bialykostek/kontroler/README.md

# Neural controller for Unmanned Aerial Vehicle control
Official repositiry 

List of most important files:

- [jan_kostecki_praca_inzynierska.pdf](/praca/jan_kostecki_praca_inzynierska.pdf) - Engineering Thesis
- [flight_model_18.h](/Kontroler/babyDodoTFPPM/flight_model_18.h) - best AI model (2 minutes in the air!)
- [flight.py](/AI/sintest.py) - Tensorflow model training
- [nettocpp.m](/AI/nettocpp.m) - matlab neural network to C++ converter
- [groundStation.ino](/Ground%20Station/groundStation/groundStation.ino) - ground station software
- [websockeetCOM.py](/Ground%20Station/websocketCOM.py) - relay app
- [babyDodo.ino](/Kontroler/babyDodo/babyDodo.ino) - controller software
- [plytka.kicad_pcb](/plytka/plytka/plytka.kicad_pcb) - PCB design
- [dodo.xfl](/samolot/dodo.xfl) - XFLR5 plane design
- [websocket.js](/serwer/websocket.js) - server software
- [main.html](/webapp/main.html) - web app main page
- [documentation.txt](/documentation.md) - communication protocol documentation
