bialykostek/kontroler/praca/neuralcontroler.pptx

## Neural controller for Unmanned Aerial Vehicle control

Jan Kostecki

## Objective

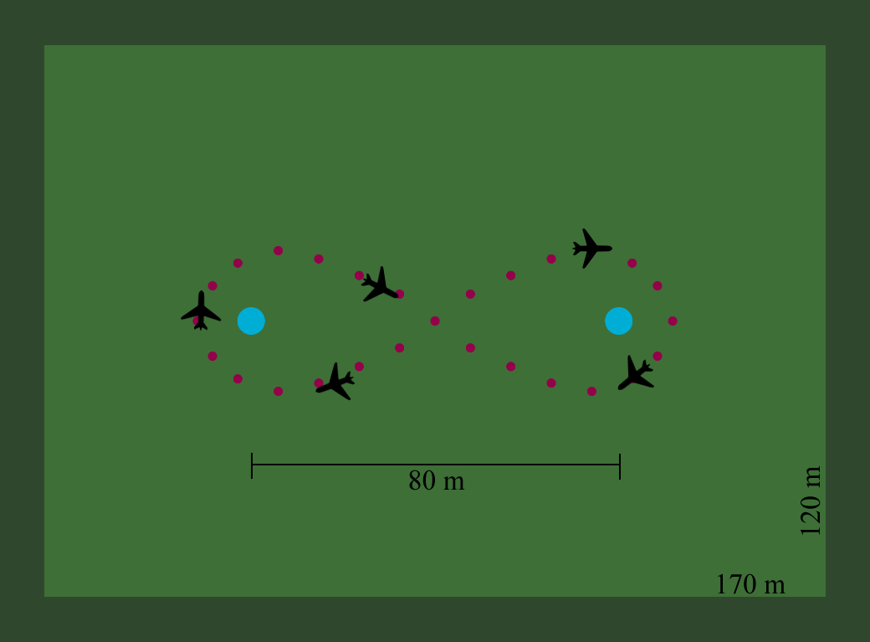
[picture p1: figure]

## Slide 3

Model plane „Dodo”

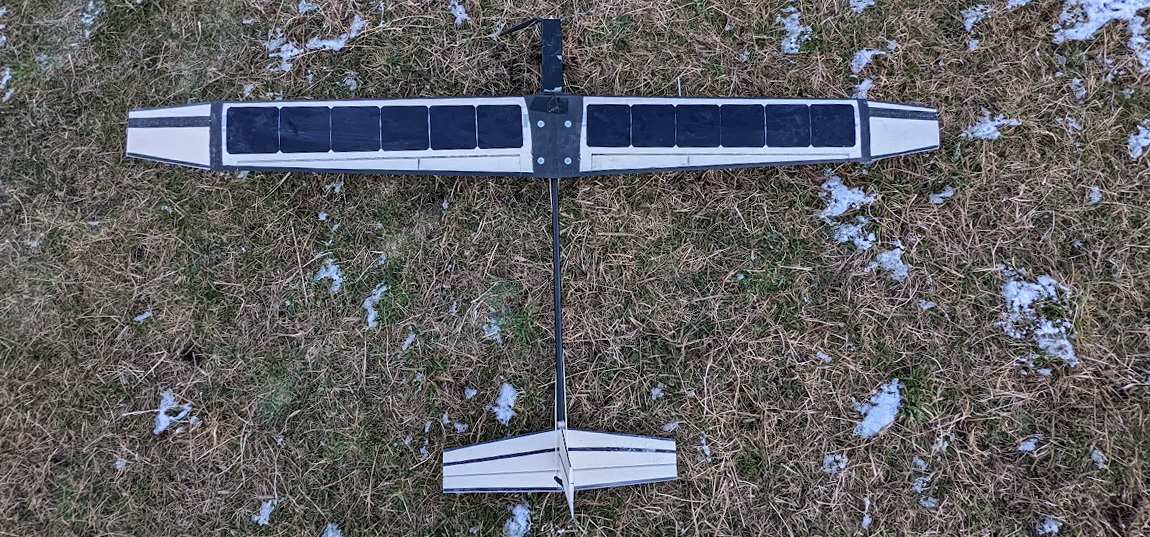
[picture p2: figure]
A picture containing text, tree, outdoor, sign

## Slide 4

Electronic controller module

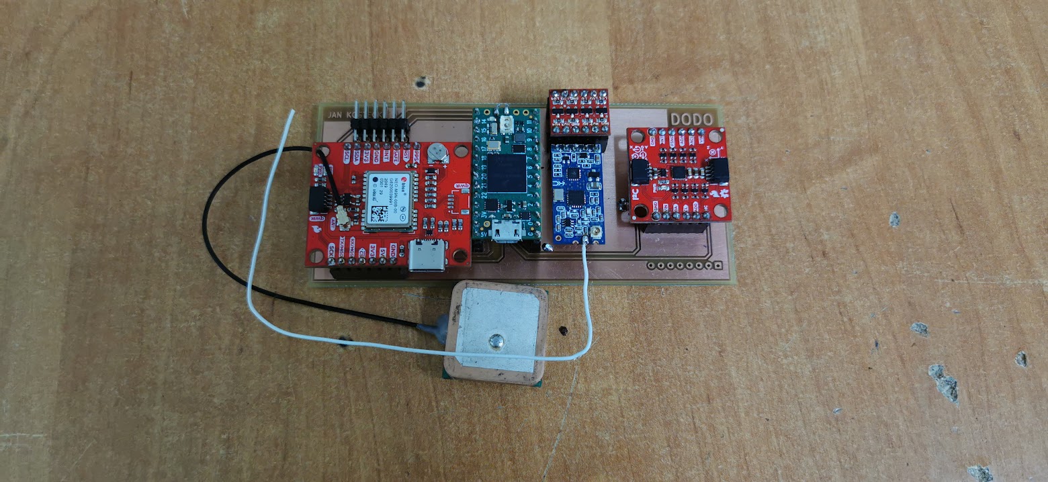
[picture p3: figure]

## Slide 5

Web visualization app

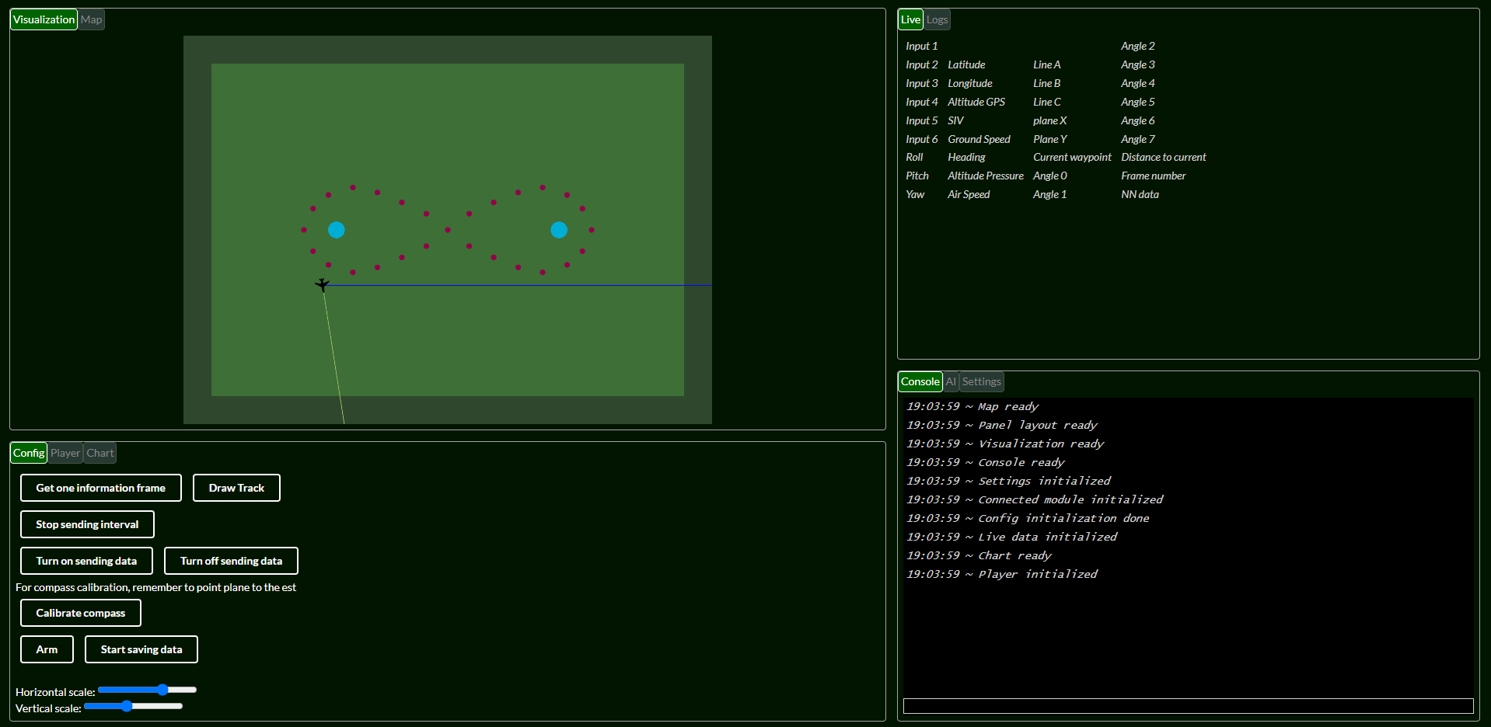
[picture p4: figure]

## Milestones

1. Prepare plane for flight (small repairs)
2. Test flight
3. Collect training data during flights
4. Fix importing TensorFlow Lite model to Teensy 4.0 microcontroller
5. Train few different networks (RNN, LSTM)
6. Test autonomous flight
7. Compare performance results

## Bibliography

Mozammal Chowdhury and Shawn Keshmiri. Design and flight test validation of an ai-based longitudinal flight controller for fixed-wing uass. IEEE Computer Society, 2022
Mihai Lungu. Backstepping and dynamic inversion combined controller for auto-landing of fixed wing uavs. Aerospace Science and Technology, 2020
Ruijie Sun, Zhou Zhou, and Xiaoping Zhu. Stability control of a fixed full-wing layout uav under manipulation constraints. Aerospace Science and Technology, 2022

## Thank you :)
