bialykostek/kontroler/praca/template/template/template.tex

%
\RequirePackage{fix-cm}
\documentclass[12pt]{report}
\usepackage{graphicx}
\usepackage{setspace}
\usepackage{authblk}
\usepackage{booktabs}
\usepackage{color,soul}
\usepackage{subfigure}
\usepackage{indentfirst}
\setlength\parindent{1cm}
\usepackage{times}
\usepackage{cite}
\usepackage[nottoc,notlot,notlof]{tocbibind}
% For tablesgenerator:
\usepackage{multirow}
\usepackage[table,xcdraw]{xcolor}
\usepackage[normalem]{ulem}
\usepackage{adjustbox}
\usepackage{float}
\usepackage[toc,page]{appendix}
\usepackage{listings}
\usepackage[utf8]{inputenc}
\usepackage{geometry}
\usepackage[final]{pdfpages}
\usepackage{hyperref}

\geometry{ a4paper, left=35mm,  right=25mm,  top=25mm, bottom=25mm  }
\linespread{1.2}

\hbadness=12000

\begin{document}

\tableofcontents
\chapter{Example chapter}
\section{Example section}
Example text.Example text.Example text.Example text.Example text.Example text.Example text.Example text.Example text.Example text.Example text.Example text.Example text.Example text.Example text.Example text.Example text.
\par
Example 2nd paragraph. Example 2nd paragraph.Example 2nd paragraph.Example 2nd paragraph.Example 2nd paragraph.Example 2nd paragraph.Example 2nd paragraph.Example 2nd paragraph.Example 2nd paragraph.Example 2nd paragraph.Example 2nd paragraph.Example 2nd paragraph. \par
\subsection{Example subsection}
Example text.Example text.Example text.Example text.Example text.Example text.Example text.Example text.Example text.Example text.Example text.Example text.Example text.Example text.Example text.Example text.Example text.

\chapter{Useful things}
\label{sec:useful_things}
\section{Lists and such}

Example itemize.
\begin{itemize}
\item item
\item item
\item item
\end{itemize}

Example enumerate
\begin{enumerate}
\item item
\item item
\item item
\end{enumerate}

\section{Including external content}
\label{sec:content}
\begin{figure}[H] 
  \centering
    
      \caption{Figure caption}
      \label{fig:example}
\end{figure}

\includepdf[pages=1]{pdfs/example}

\section{Tables and equations}
http://www.tablesgenerator.com/ is convenient for table generation until you get
used to the syntax.
\begin{table}[H]
\label{tab:example}
\begin{tabular}{|l|l|l|l|l|}
\hline
1 & 1 & 1 & 1 & 1 \\ \hline
1 & 1 & 1 & 1 & 1 \\ \hline
1 & 1 & 1 & 1 & 1 \\ \hline
1 & 1 & 1 & 1 & 1 \\ \hline
\end{tabular}
\end{table}

https://www.codecogs.com/latex/eqneditor.php is convenient for equation generation
until you get used to the syntax.

\begin{equation}
\label{eq:example}
 u(t)=K_{p}e(t) + K_{i} \int_{0}^{t}e(t')dt'+K_{d}\frac{de(t)}{dt}
\end{equation}

\section{Adding references}
Added content was labeled following type:label convention, using:
\begin{itemize}
\item tab for tables
\item fig for figures
\item eq for equations
\item sec for text sections
\end{itemize}
Not a rigid thing, can be changed to any other names but some labeling convention should be used, as it makes referring specific things easier.
Example references:
\begin{itemize}
\item table: \autoref{tab:example}
\item figure: \autoref{fig:example}
\item equation: \autoref{eq:example}
\item chapter: \autoref{sec:useful_things}
\item section: \autoref{sec:content}
\item position from bibliography(within the included .bib file): \cite{ref_key}
\end{itemize}

\bibliography{template_ref}
\bibliographystyle{ieeetr}	

\end{document}
