bialykostek/kontroler/praca/latex/tytulowa.pdf

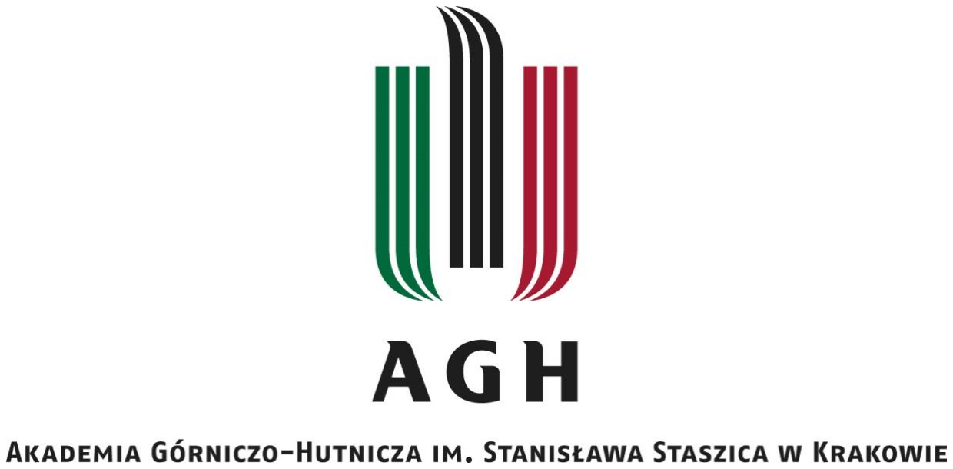
[picture p74: figure]

WYDZIAŁ INŻYNIERII MECHANICZNEJ I ROBOTYKI

KATEDRA ROBOTYKI I MECHATRONIKI

## Praca dyplomowa

## Neuronowy kontroler do sterowania bezzałogowym statkiem powietrznym

## Neural controller for an Unmanned Aerial Vehicle control

Autor: | Jan Kostecki
Kierunek studiów: | Inżynieria Mechatroniczna
Opiekun pracy: | dr hab. inż. Ziemowit Dworakowski, prof. AGH

Kraków, 2022
