bialykostek/kontroler/polocie_dark.png

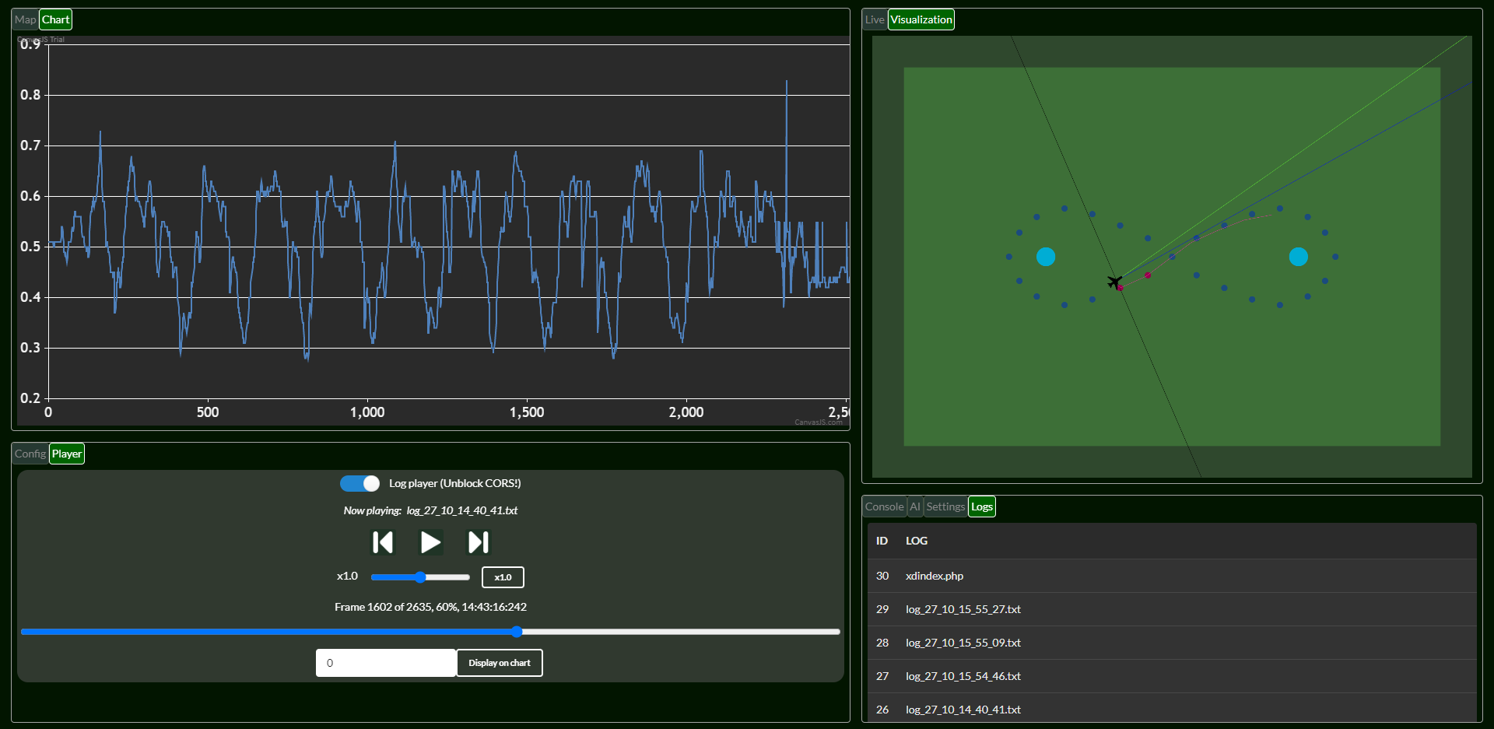
polocie_dark.png
