bialykostek/kontroler/praca/latex/images/budowa2.png

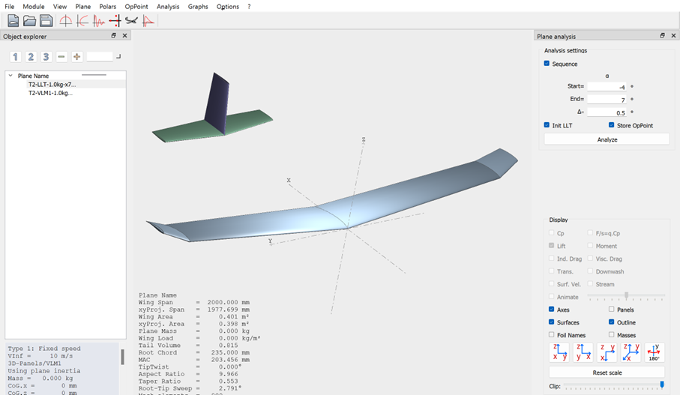
praca/latex/images/budowa2.png
