bialykostek/kontroler/praca/latex/images/budowa6.jpg

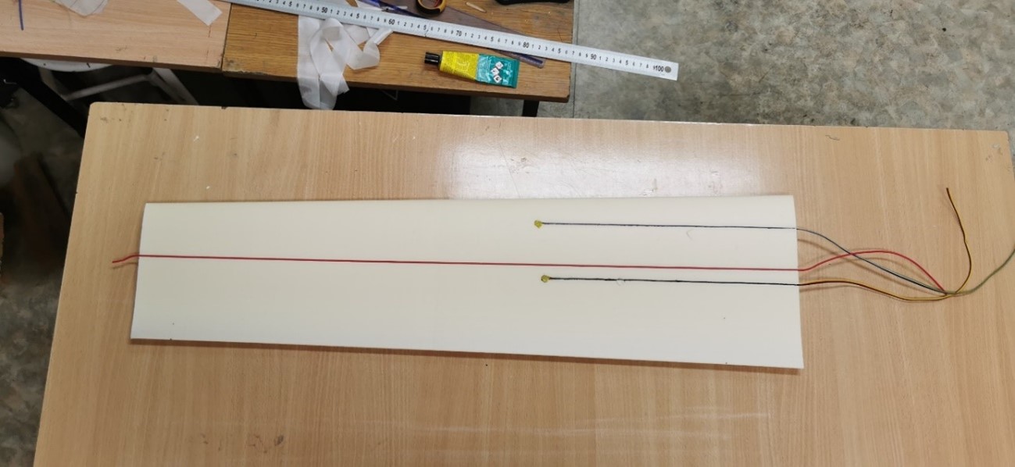
praca/latex/images/budowa6.jpg
