bialykostek/kontroler/praca/latex/images/budowa8.jpg

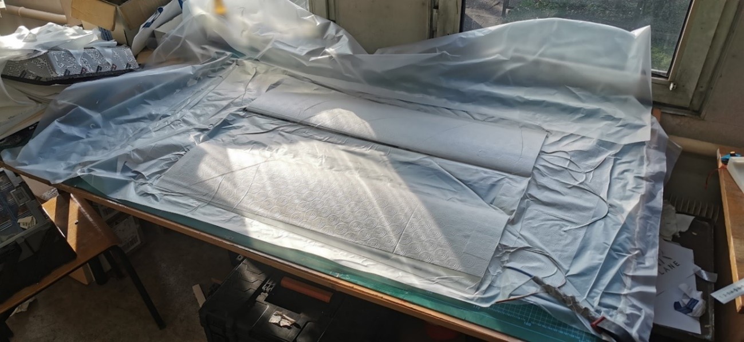
praca/latex/images/budowa8.jpg
