bialykostek/kontroler/praca/latex/images/budowa10.jpg

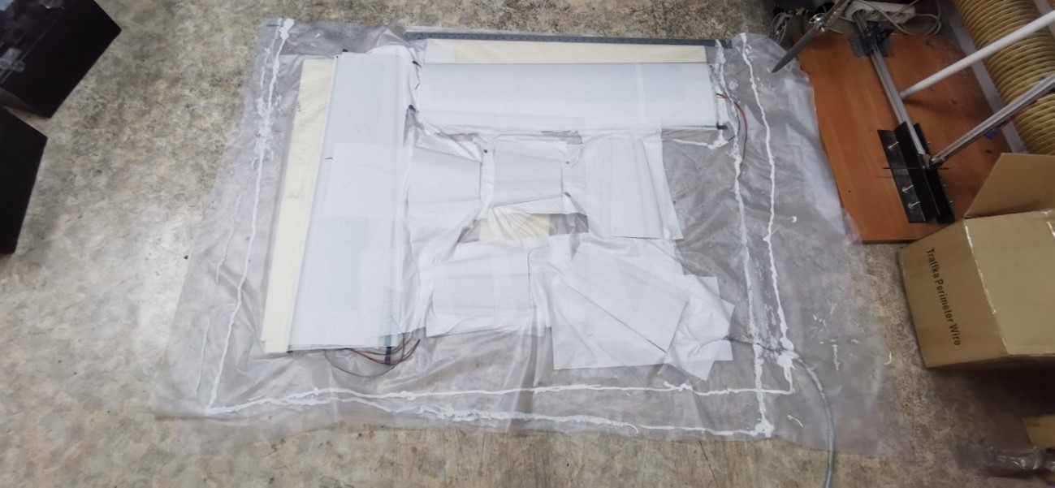
praca/latex/images/budowa10.jpg
