bialykostek/kontroler/praca/latex/images/budowa12.jpg

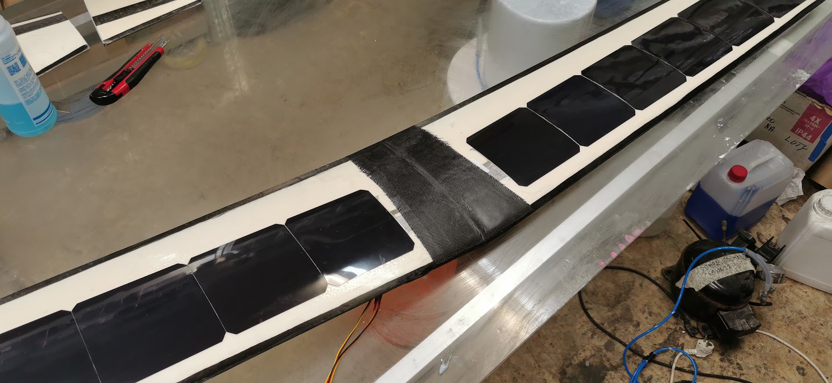
praca/latex/images/budowa12.jpg
