bialykostek/kontroler/praca/latex/images/budowa15.png

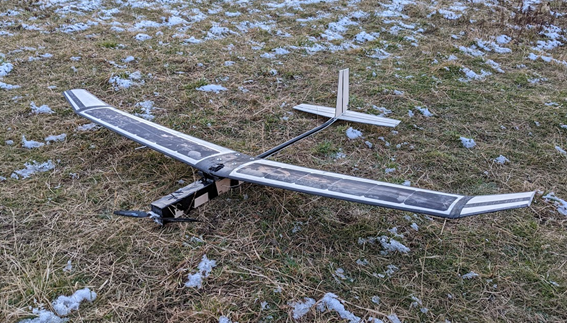
praca/latex/images/budowa15.png
