bialykostek/kontroler/praca/latex/images/charakterystyki.png

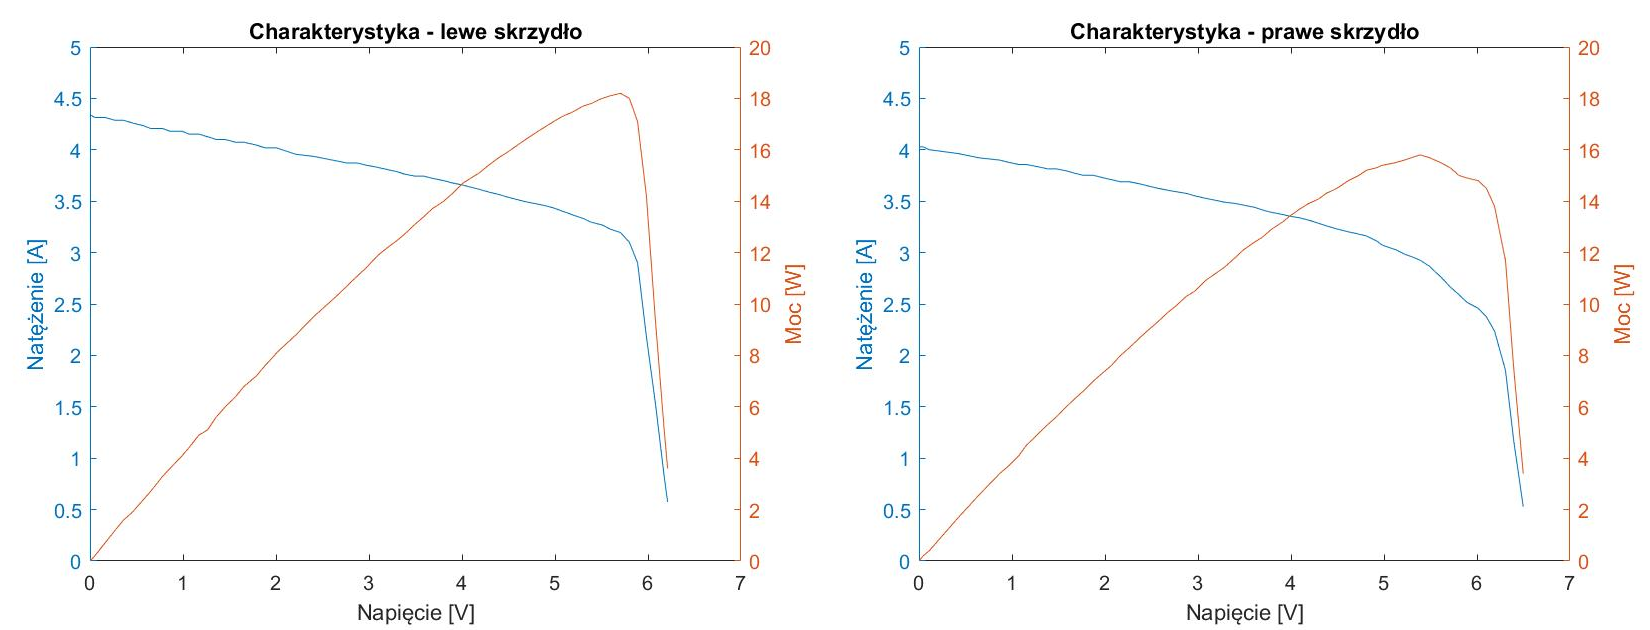
praca/latex/images/charakterystyki.png
