bialykostek/kontroler/praca/latex/images/cuav.jpg

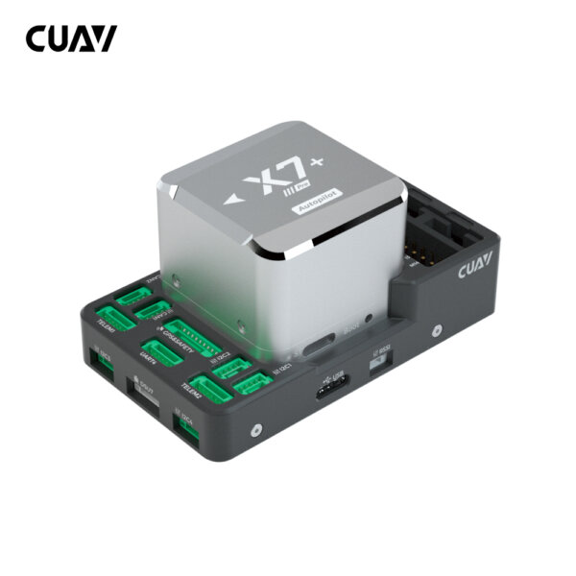
praca/latex/images/cuav.jpg
