bialykostek/kontroler/praca/latex/images/diagram_blokowy.png

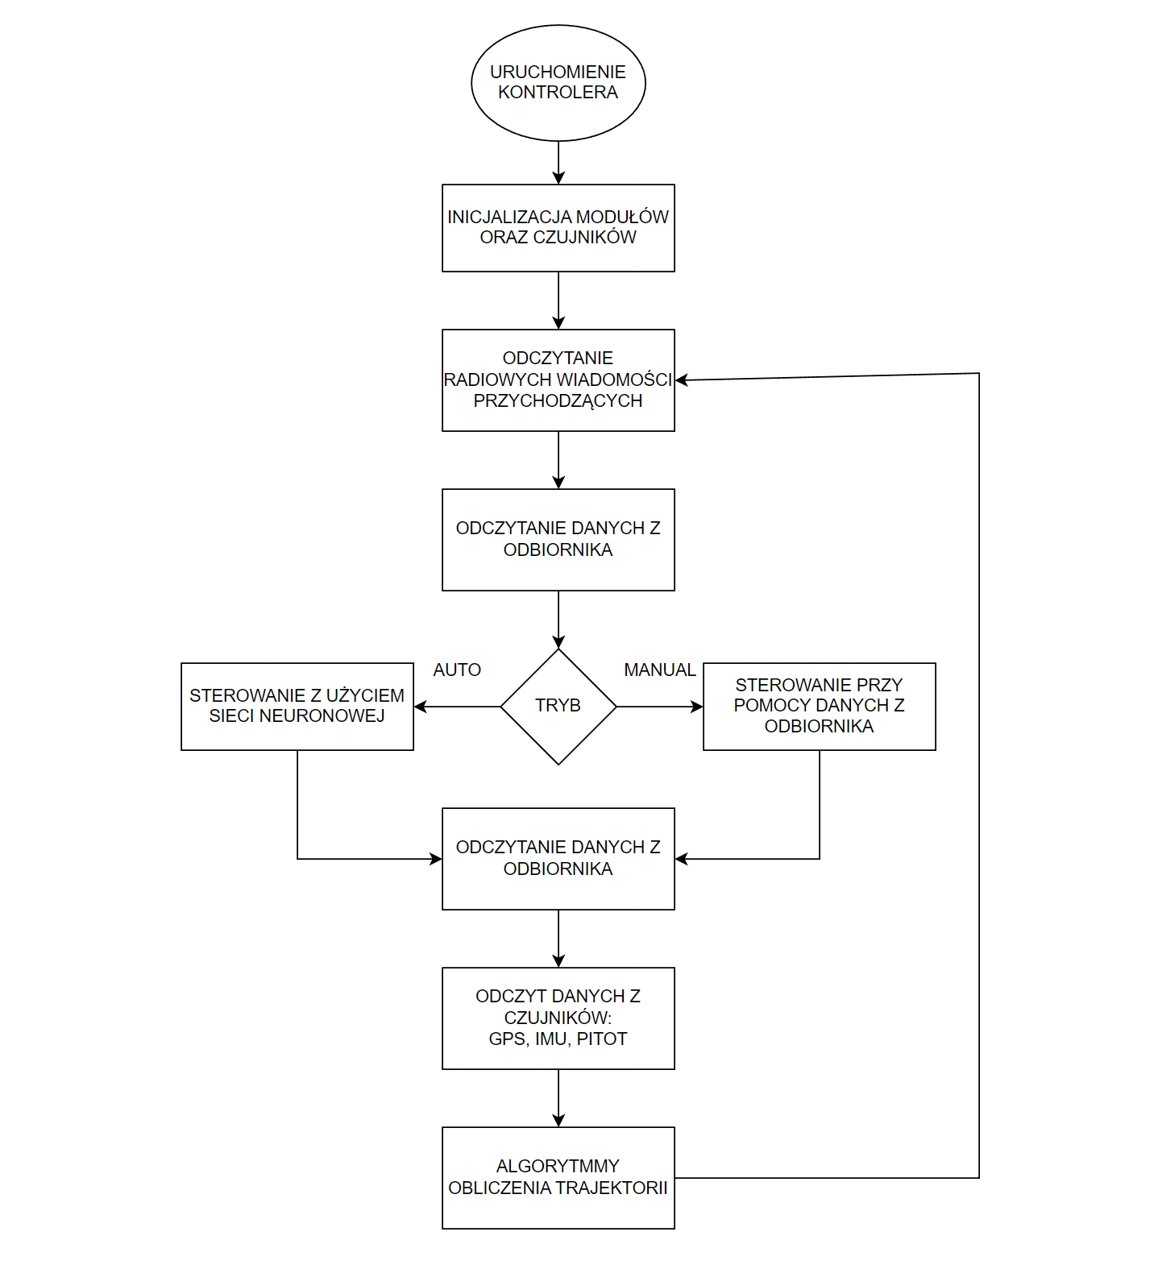
praca/latex/images/diagram_blokowy.png
