bialykostek/kontroler/praca/latex/images/diagram_emergency.png

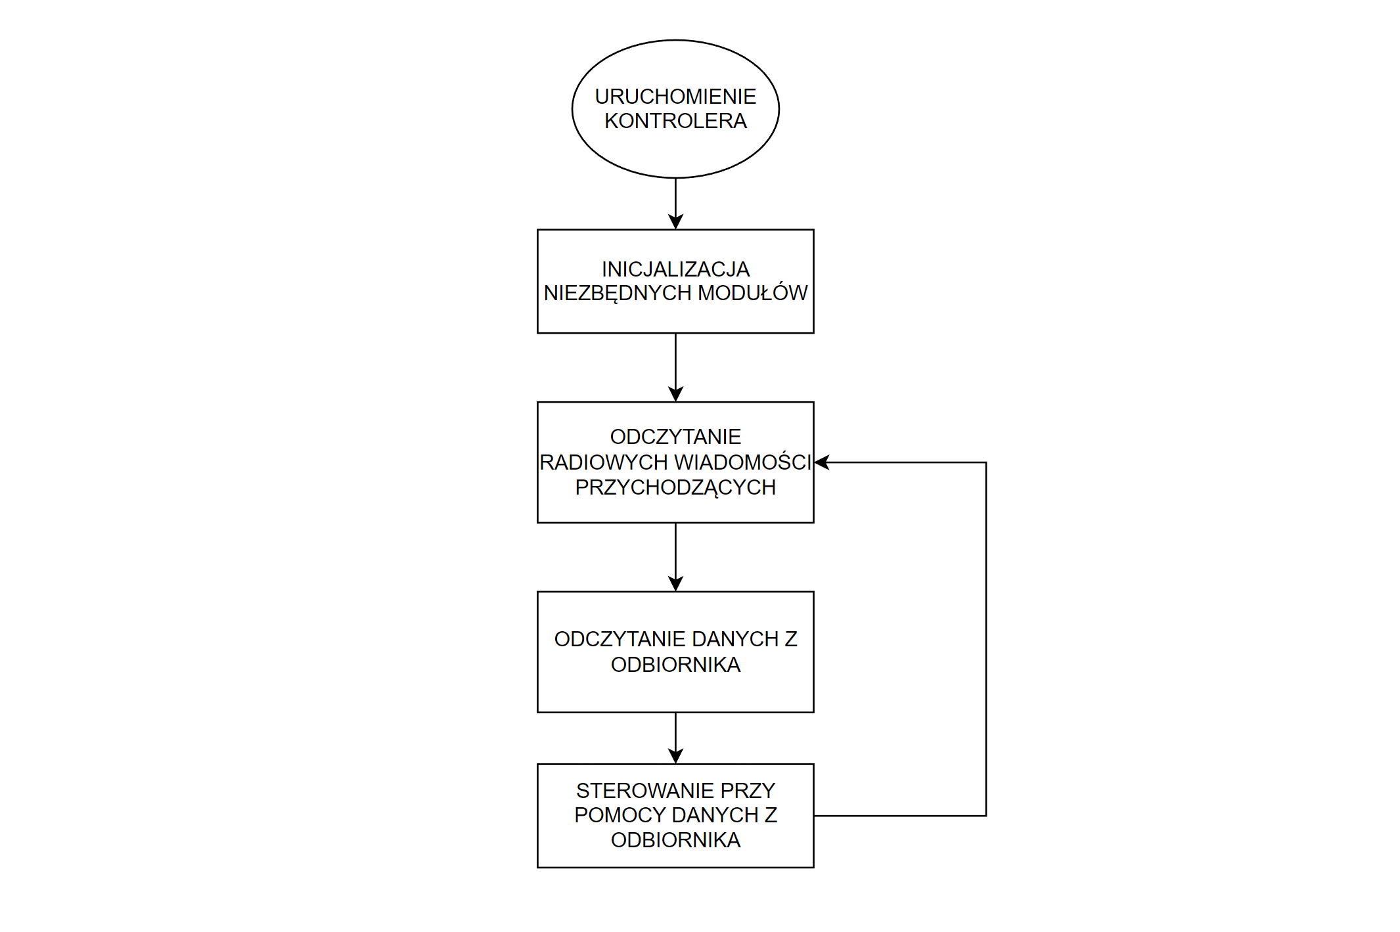
praca/latex/images/diagram_emergency.png
