bialykostek/kontroler/praca/latex/images/dodopcb.png

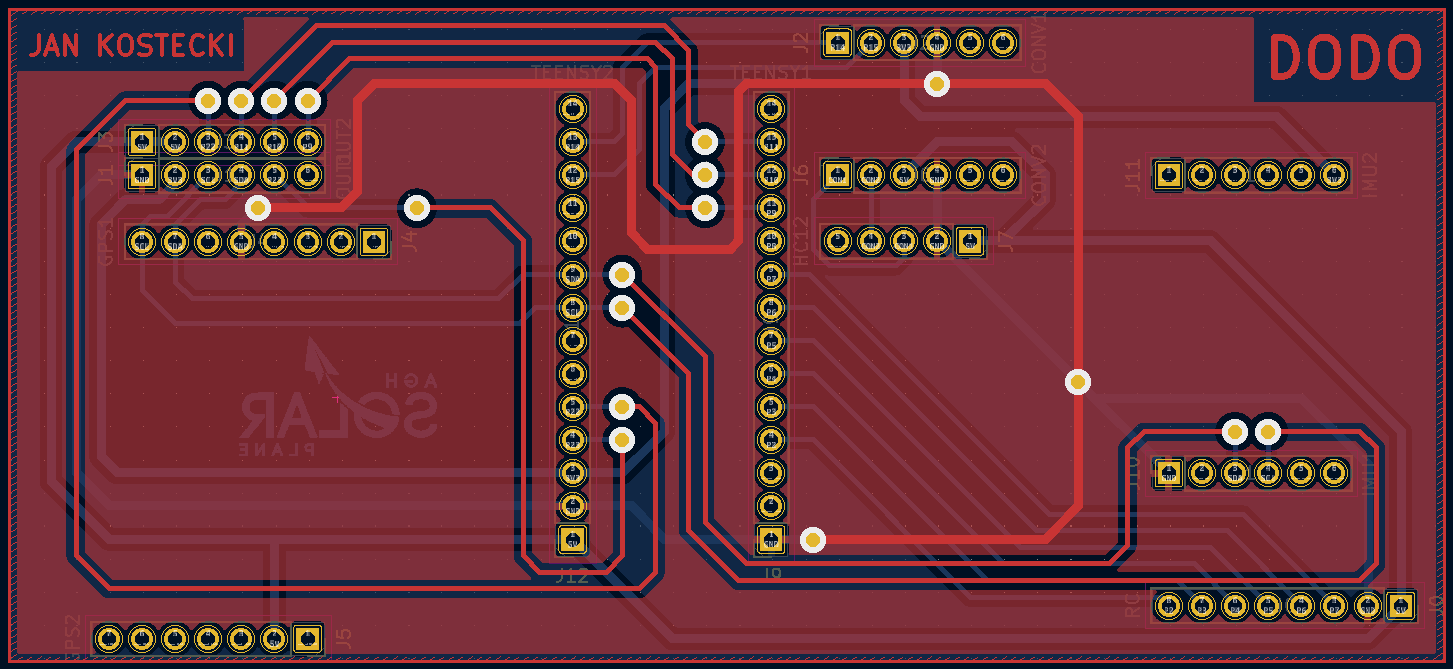
praca/latex/images/dodopcb.png
