bialykostek/kontroler/praca/latex/images/kamerat.png

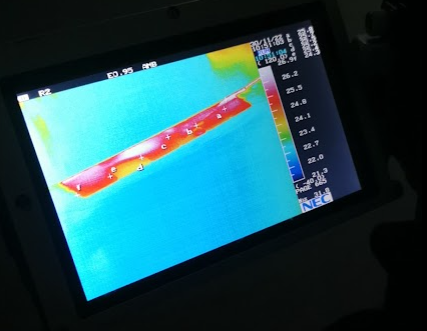
praca/latex/images/kamerat.png
