bialykostek/kontroler/praca/latex/images/kontroler1.png

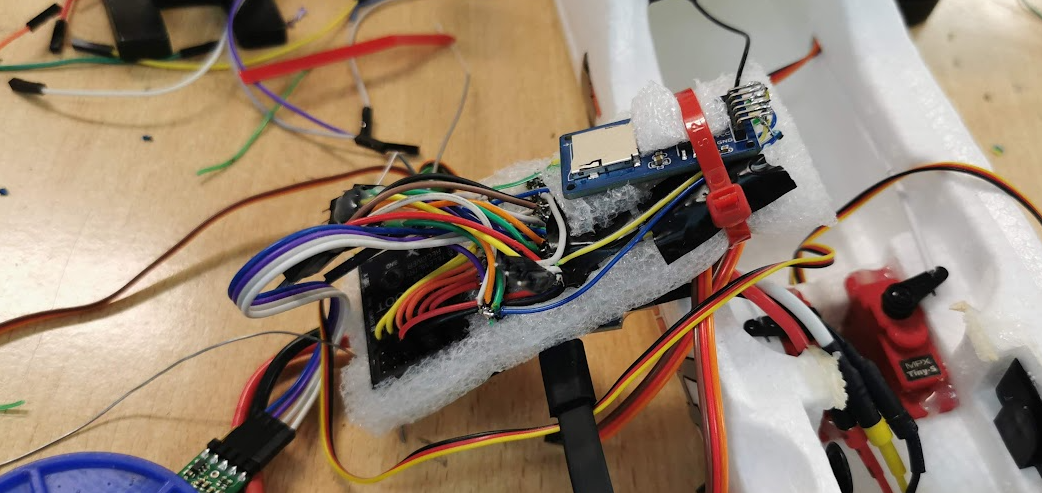
praca/latex/images/kontroler1.png
