bialykostek/kontroler/praca/latex/images/legitymacjap.jpg

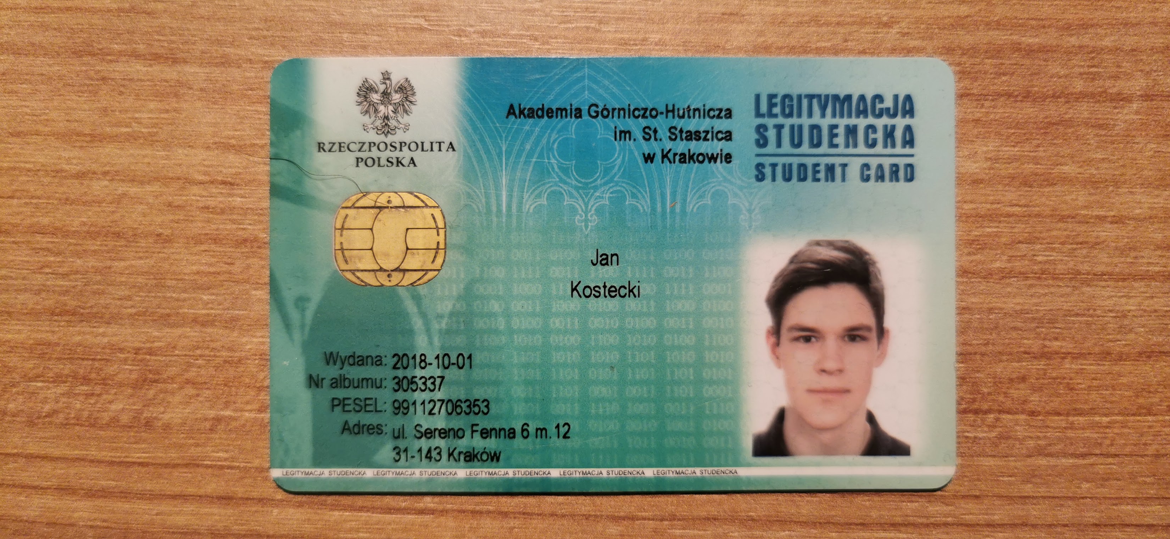
praca/latex/images/legitymacjap.jpg
