bialykostek/kontroler/praca/latex/images/legitymacjat.jpg

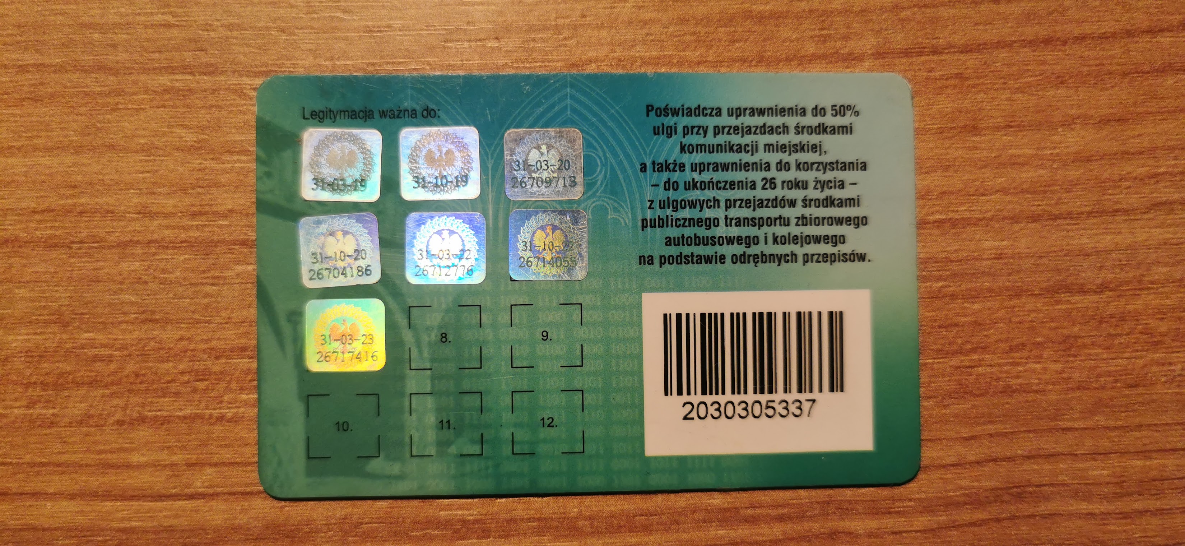
praca/latex/images/legitymacjat.jpg
