bialykostek/kontroler/praca/latex/images/leweprzetarte.jpg

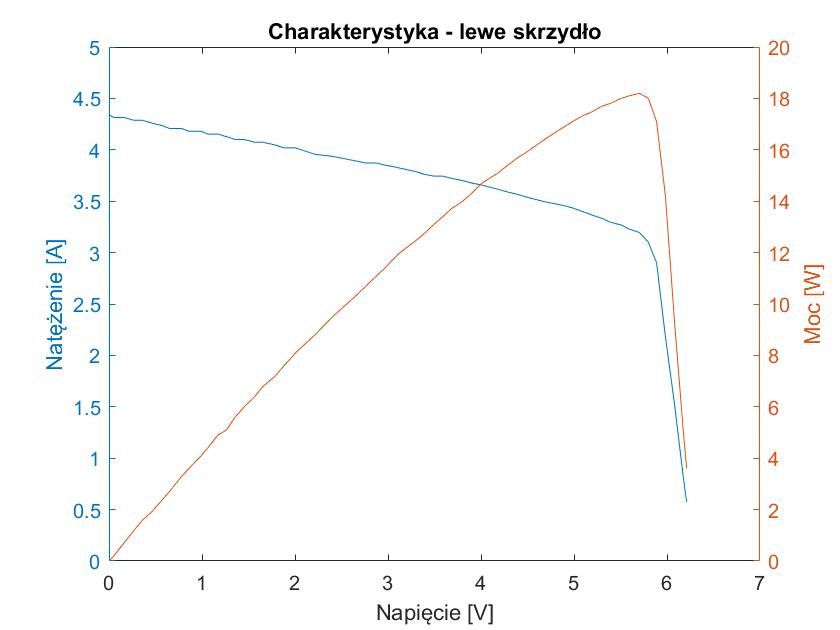
praca/latex/images/leweprzetarte.jpg
