bialykostek/kontroler/praca/latex/images/mateksys.png

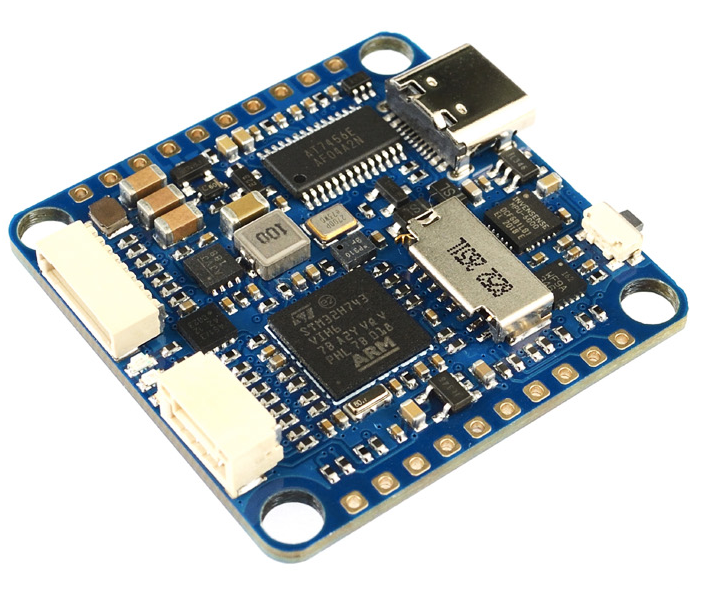
praca/latex/images/mateksys.png
