bialykostek/kontroler/praca/latex/images/pixhawk.jpg

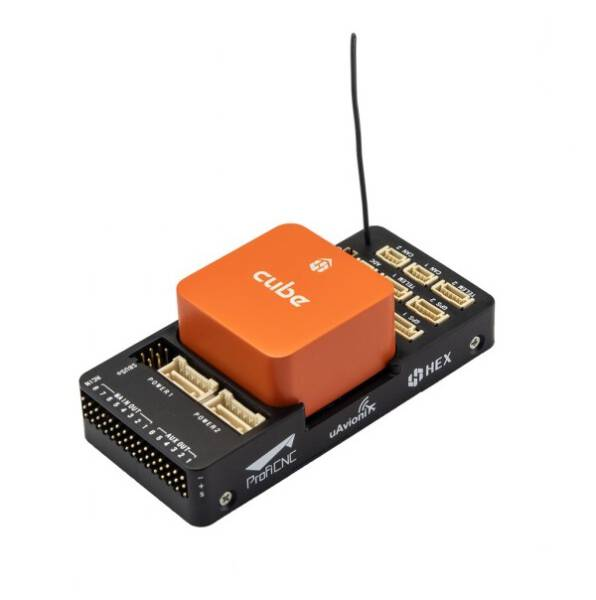
praca/latex/images/pixhawk.jpg
