bialykostek/kontroler/praca/latex/images/porownanie2.jpg

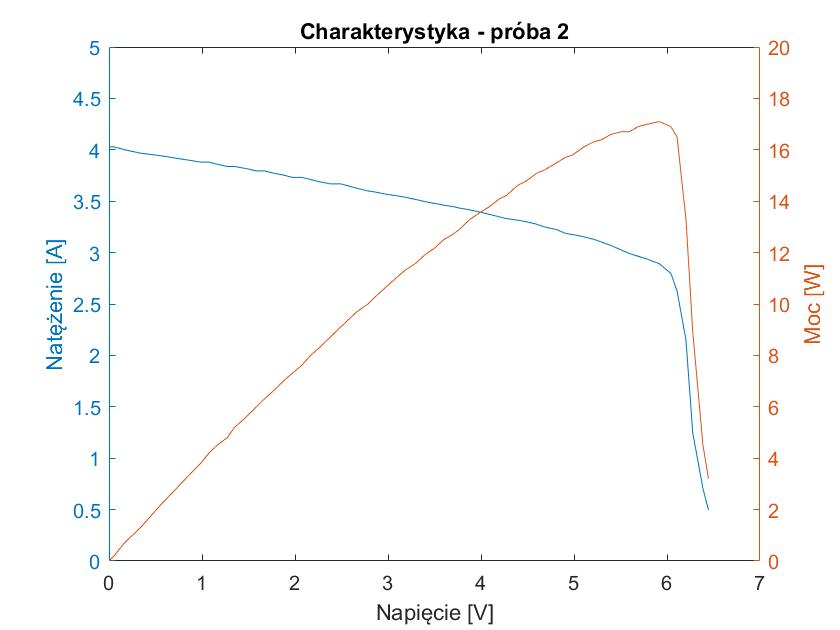
praca/latex/images/porownanie2.jpg
