bialykostek/kontroler/praca/latex/images/stacjaodbiorcza.jpg

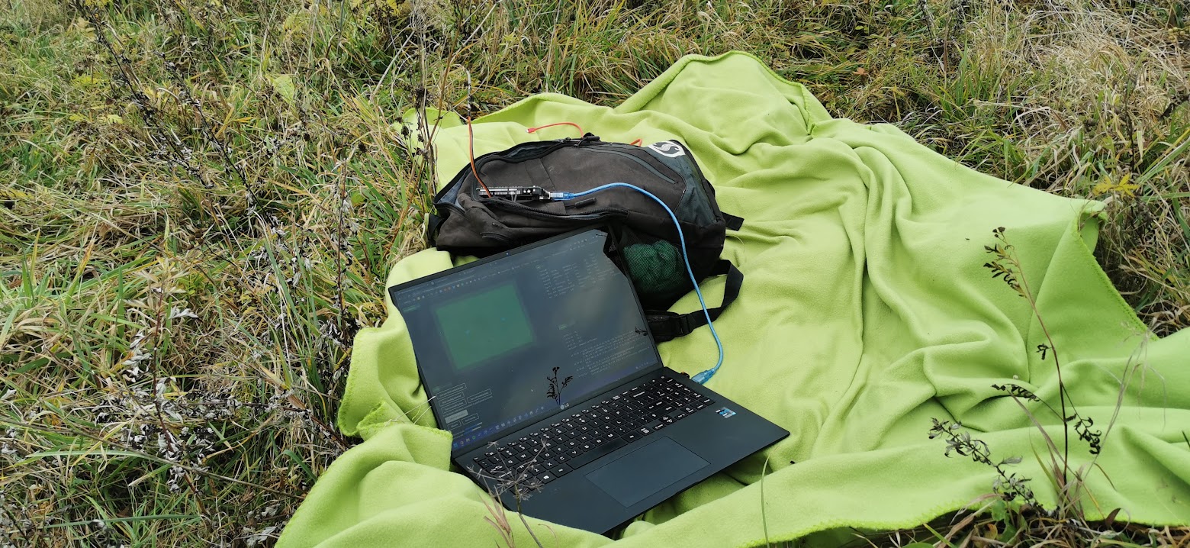
praca/latex/images/stacjaodbiorcza.jpg
