bialykostek/kontroler/praca/latex/images/termolewe.jpg

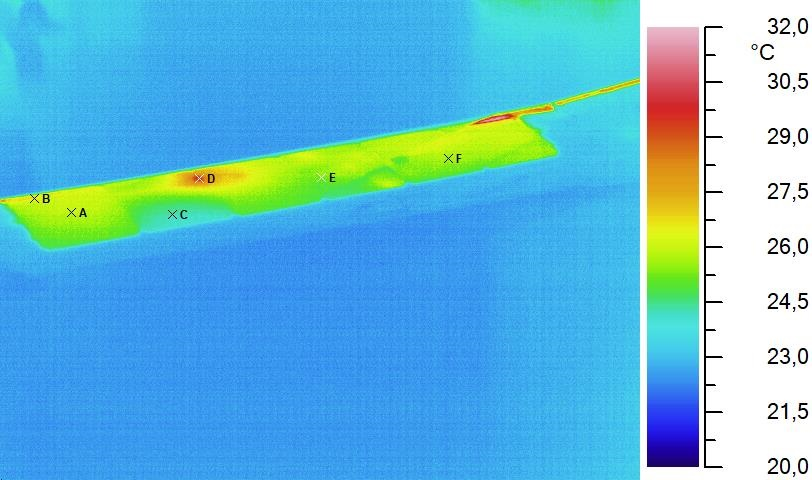
praca/latex/images/termolewe.jpg
