bialykostek/kontroler/praca/latex/images/termoprawe.jpg

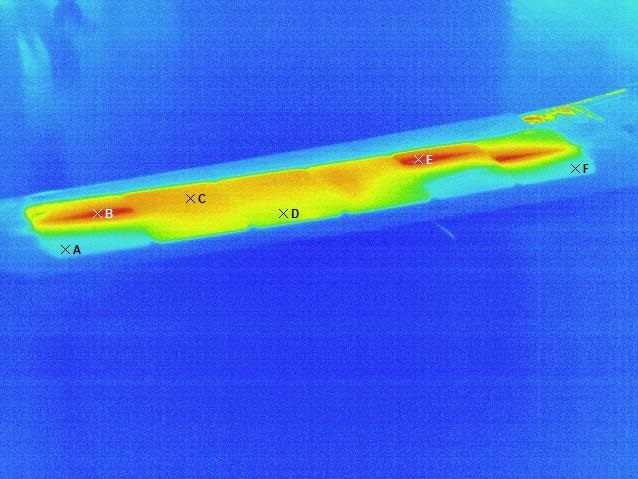
praca/latex/images/termoprawe.jpg
