bialykostek/kontroler/praca/latex/images/terzwlewe.jpg

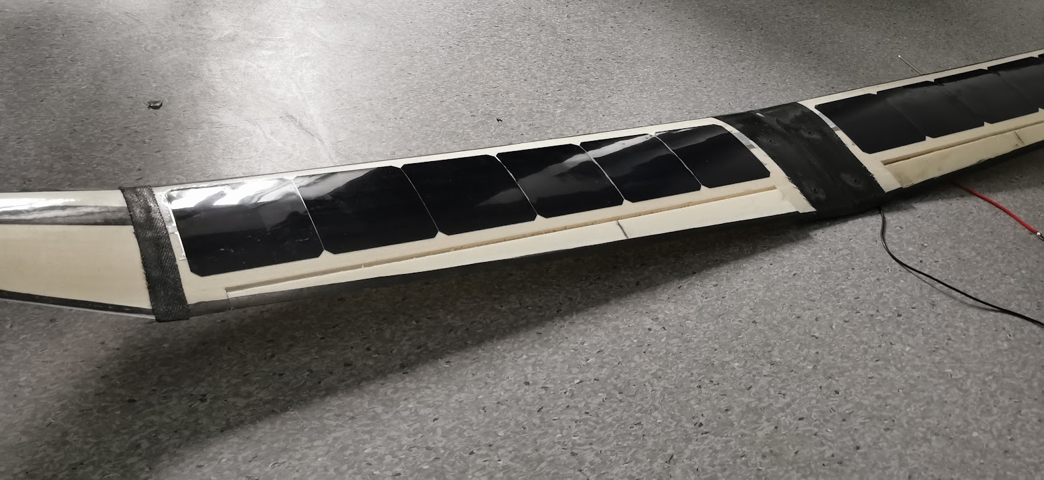
praca/latex/images/terzwlewe.jpg
