bialykostek/kontroler/praca/latex/images/terzwprawe.jpg

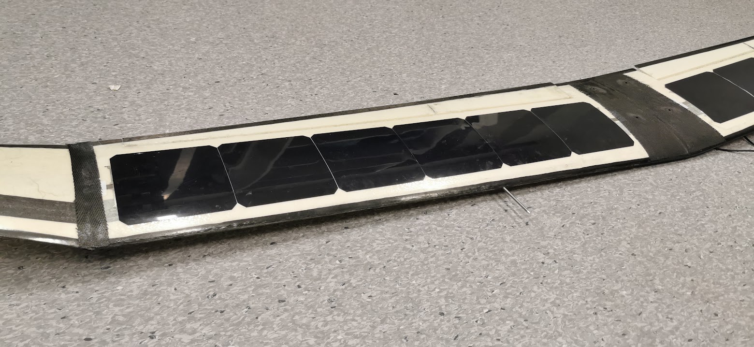
praca/latex/images/terzwprawe.jpg
