bialykostek/kontroler/praca/na pracy.png

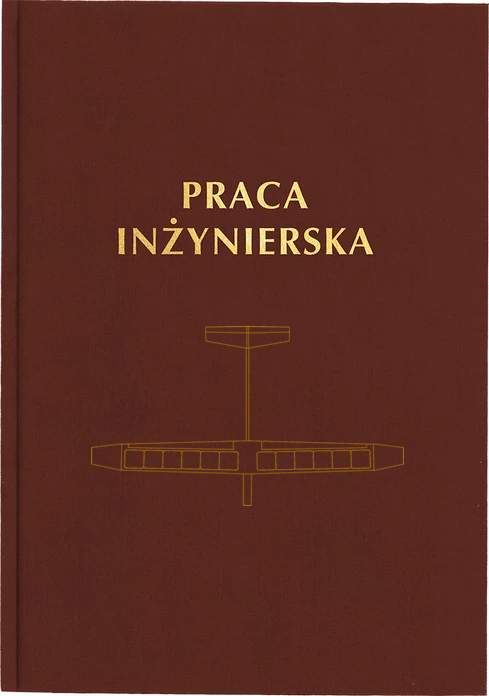
praca/na pracy.png
