bialykostek/kontroler/praca/pcb1.png

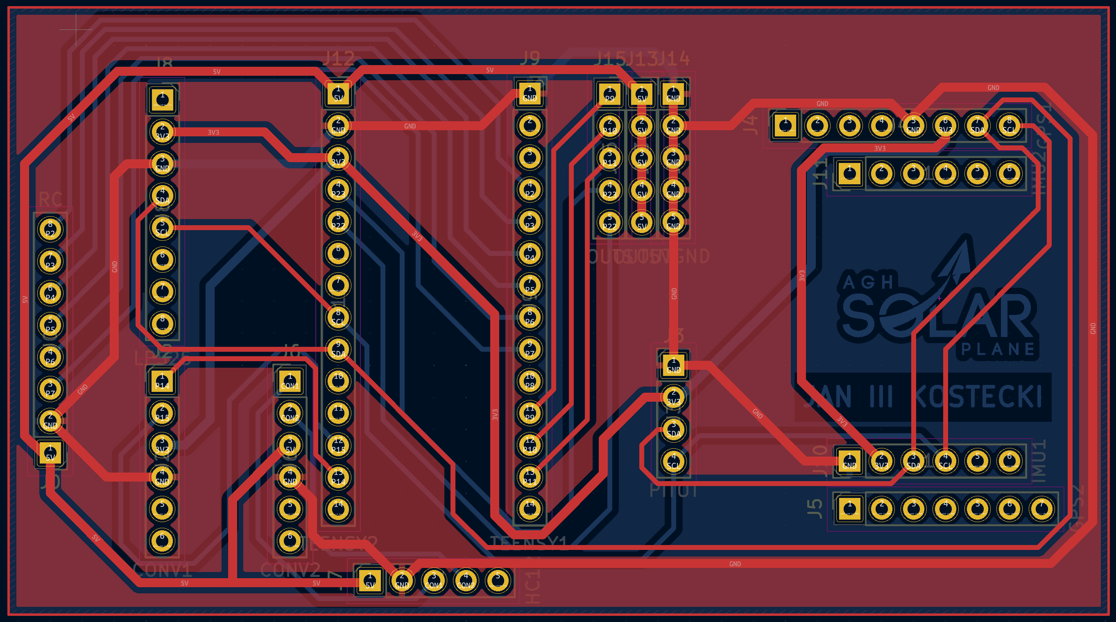
praca/pcb1.png
