bialykostek/kontroler/praca/pcb2.png

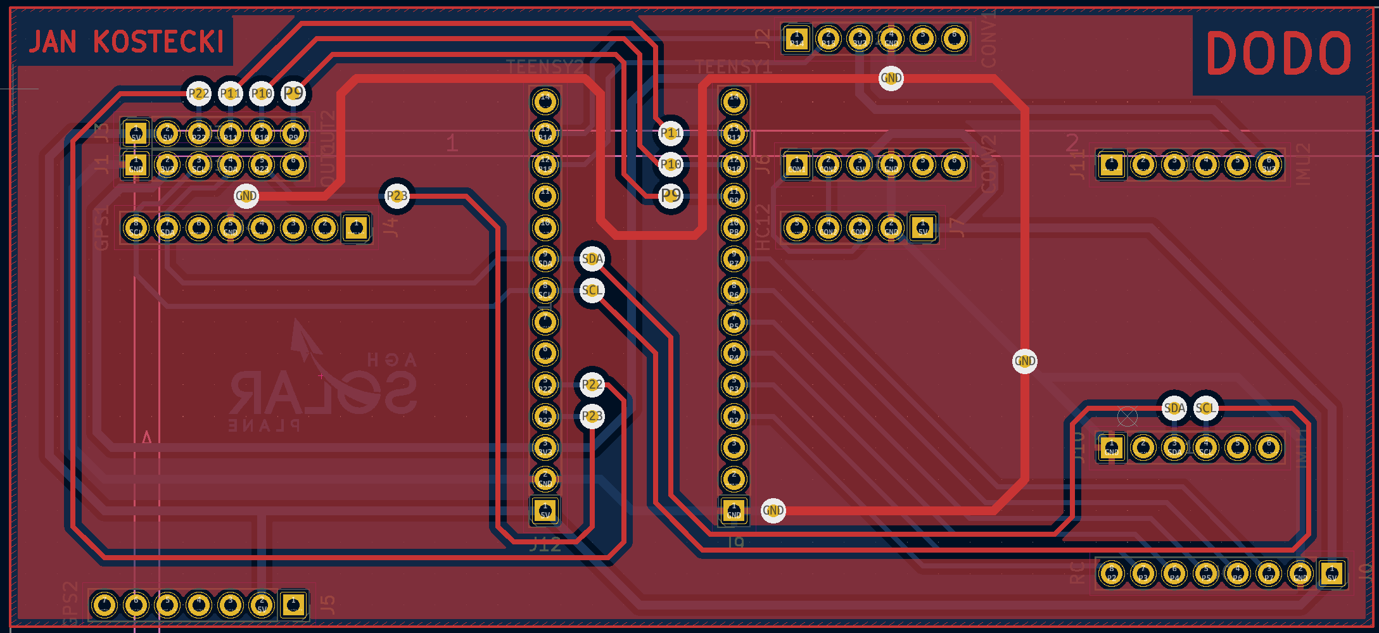
praca/pcb2.png
