bialykostek/kontroler/praca/pomiary/pomiar10aleweprzetarte.PNG

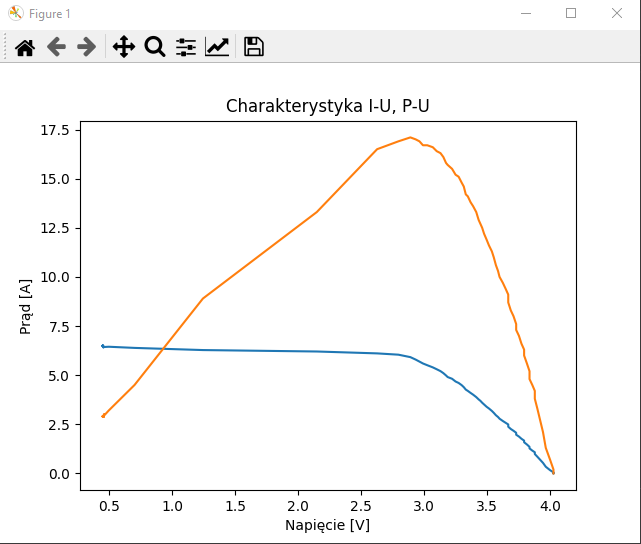
praca/pomiary/pomiar10aleweprzetarte.PNG
