bialykostek/kontroler/praca/pomiary/pomiar10apraweprzetarte.PNG

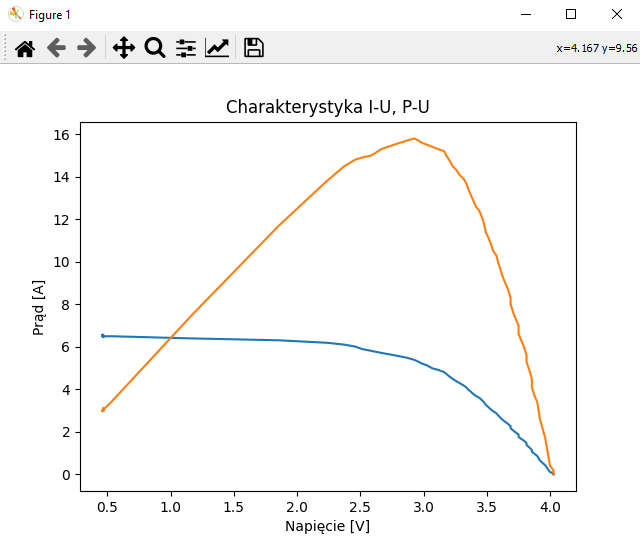
praca/pomiary/pomiar10apraweprzetarte.PNG
