bialykostek/kontroler/praca/porownanie2.jpg

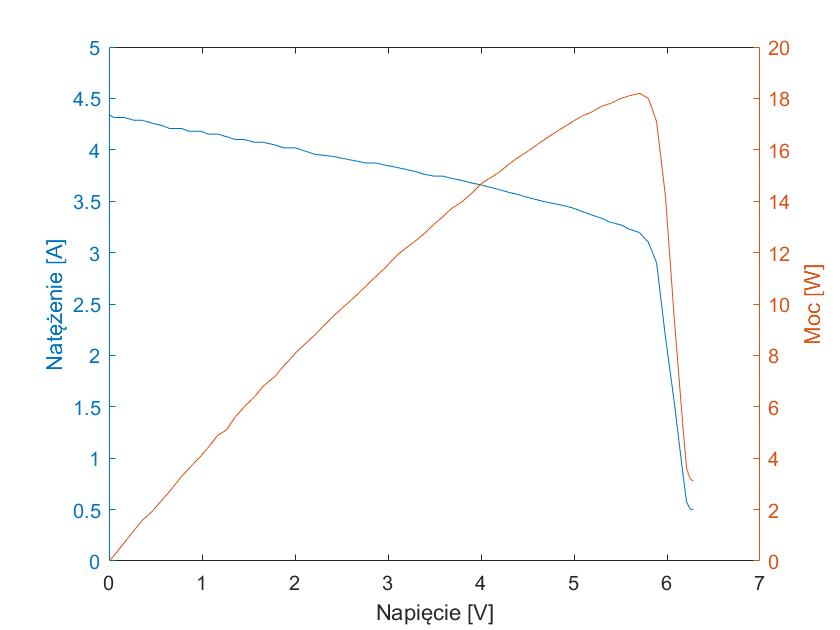
praca/porownanie2.jpg
