bialykostek/kontroler/praca/samolociksam (1).png

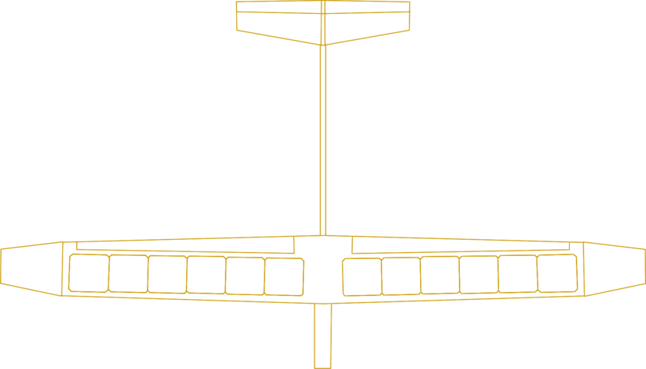
praca/samolociksam (1).png
