bialykostek/kontroler/praca/trasa.png

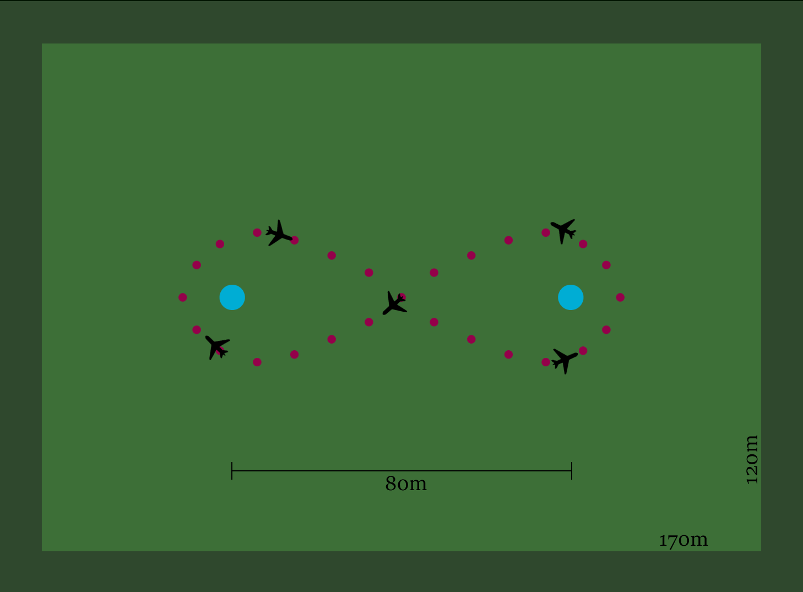
praca/trasa.png
