bialykostek/kontroler/praca/zdodo.jpg

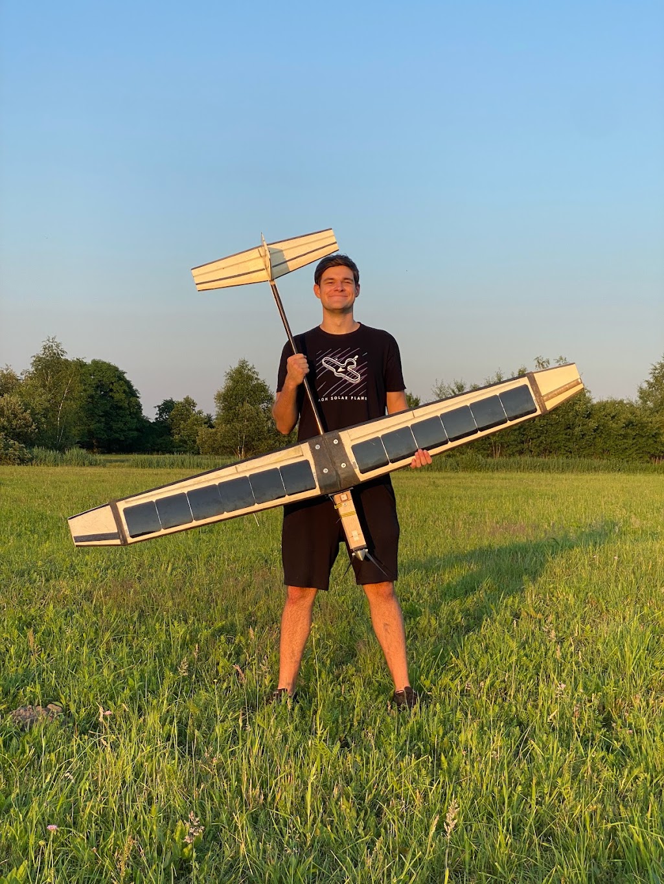
praca/zdodo.jpg
