bialykostek/kontroler/przedlotem_dark.png

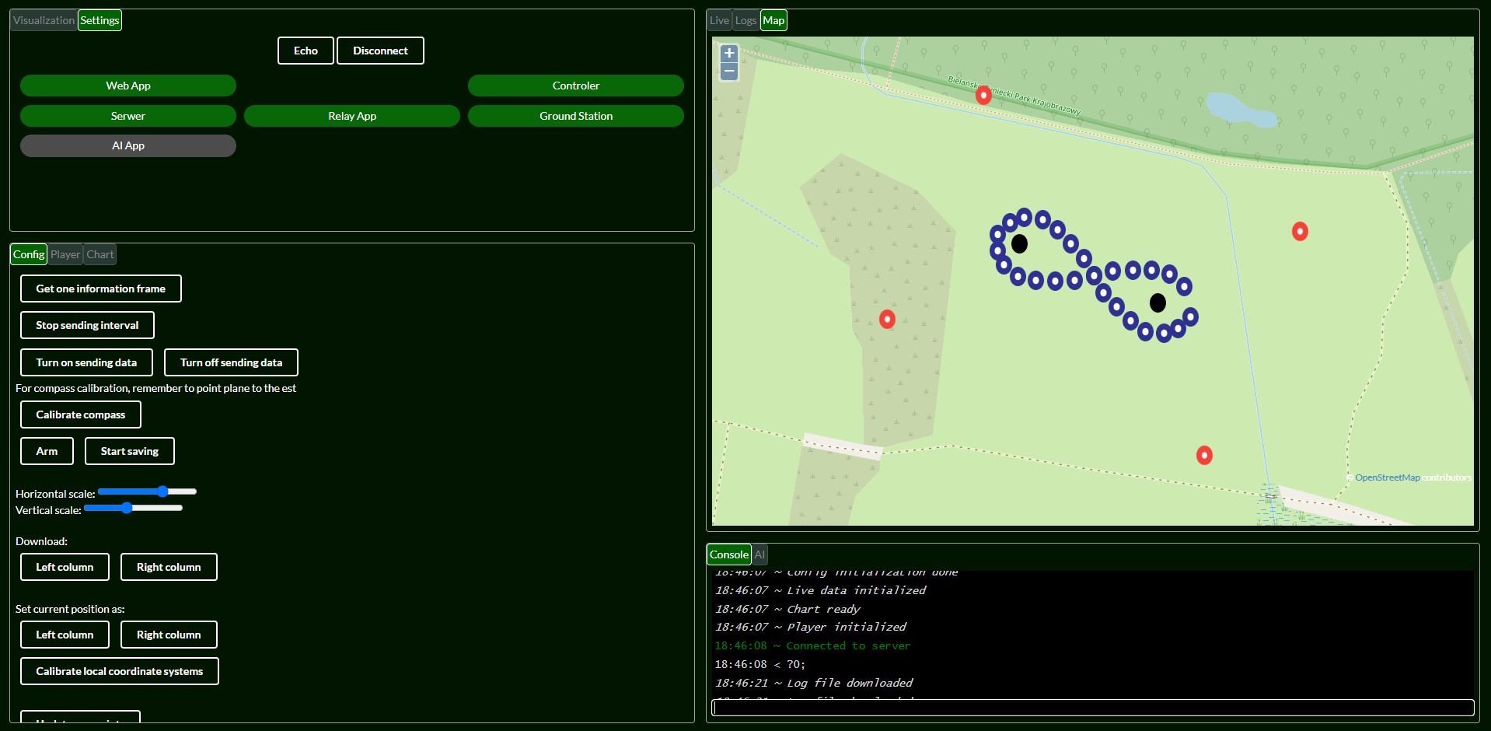
przedlotem_dark.png
