bialykostek/kontroler/samolot/podstawka.step

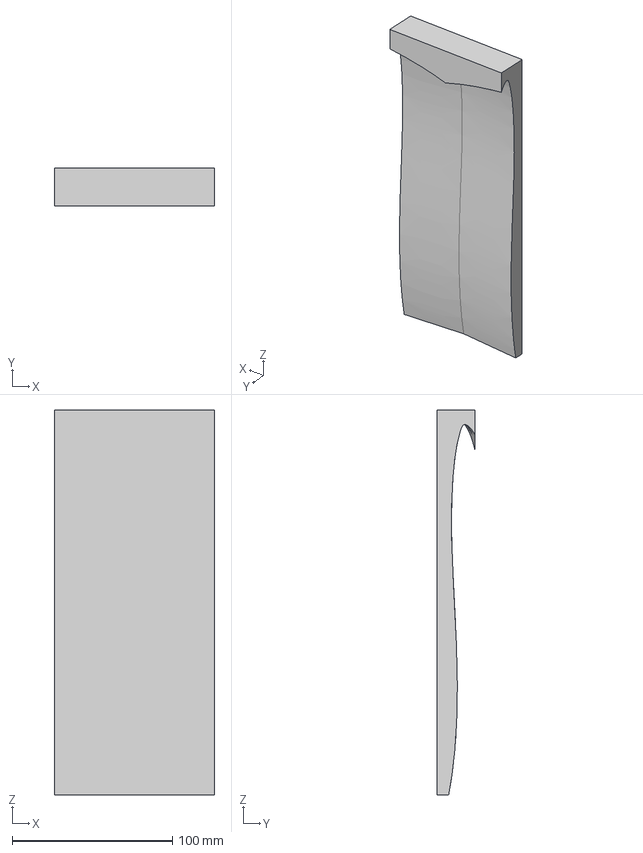
[picture p112: CAD file, 2022-12-01]
samolot/podstawka.step
100.0 x 24.0 x 240.0 mm
