bialykostek/kontroler/samolot/podstawka v6.step

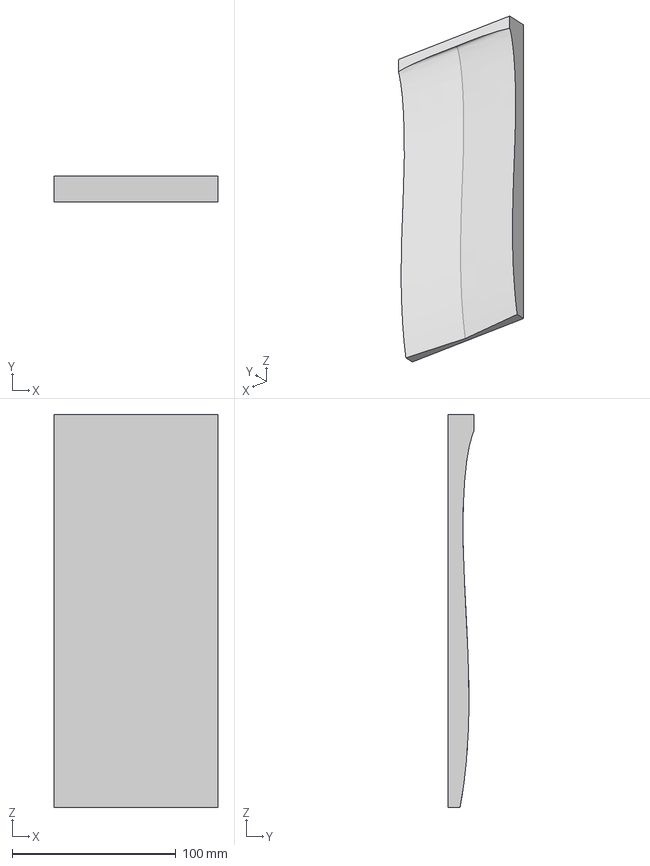
[picture p113: CAD file, 2022-12-01]
samolot/podstawka v6.step
100.0 x 16.0 x 240.0 mm
