bialykostek/kontroler/samolot/podstawka v5.stl

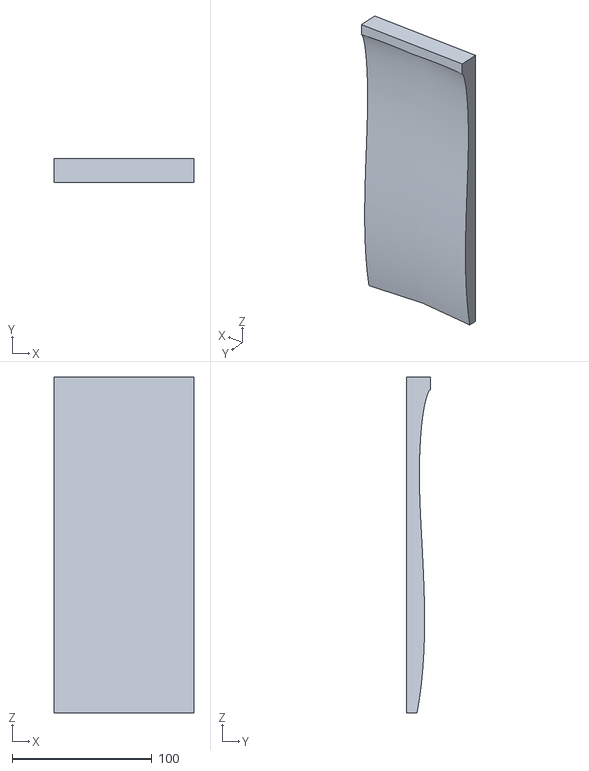
[picture p114: CAD file, 2022-12-01]
samolot/podstawka v5.stl
100.0 x 17.0 x 240.0
