bialykostek/kontroler/(list of files, cad)

Other CAD files:
samolot/podstawka v4.stl
