bialykostek/kontroler/samolot/poziom_lewy_Jasiek_off_100_fix.txt

G17
G21
G91
( SET CUTTER COMPENSATION )
G40
( SET TOOL LENGTH OFFSET )
G49
( SET PATH CONTROL MODE )
G64
( SET FEED RATE MODE )
G94

F1000
G1 X0 Y100 U0 Z100
G1 X300 Y0 U300 Z0
G1 X0 Y-90 U0 Z-90
F40
G1 X0 Y-50 U0 Z-50
G1 X-39.9414 Y0 U0 Z0
G1 X-10 Y0 U-10 Z0
G1 X-1.4856 Y0.1375 U-4.9362 Z0.457
G1 X-0.2404 Y0.0225 U-0.7991 Z0.0713
G1 X-1.5806 Y0.1436 U-5.2519 Z0.4772
G1 X-0.2246 Y0.0207 U-0.7468 Z0.0643
G1 X-2.1005 Y0.1857 U-6.9794 Z0.617
G1 X-0.2045 Y0.0184 U-0.68 Z0.0564
G1 X-2.2226 Y0.1903 U-7.3851 Z0.6322
G1 X-0.1835 Y0.016 U-0.6103 Z0.0488
G1 X-2.2813 Y0.1888 U-7.5804 Z0.6272
G1 X-0.1622 Y0.0137 U-0.5393 Z0.0417
G1 X-2.261 Y0.1809 U-7.5129 Z0.6011
G1 X-0.1412 Y0.0115 U-0.4696 Z0.0351
G1 X-2.297 Y0.1776 U-7.6323 Z0.59
G1 X-0.1201 Y0.0095 U-0.3993 Z0.0288
G1 X-2.3617 Y0.1764 U-7.8474 Z0.586
G1 X-0.0985 Y0.0075 U-0.3276 Z0.0228
G1 X-2.4018 Y0.1732 U-7.9806 Z0.5754
G1 X-0.0768 Y0.0057 U-0.2554 Z0.0171
G1 X-2.4215 Y0.1682 U-8.0461 Z0.5588
G1 X-0.0551 Y0.0039 U-0.1833 Z0.0118
G1 X-2.4496 Y0.1636 U-8.1393 Z0.5437
G1 X-0.0334 Y0.0023 U-0.1109 Z0.0068
G1 X-2.4639 Y0.158 U-8.1869 Z0.525
G1 X-0.0117 Y0.0008 U-0.0389 Z0.0023
G1 X-2.4721 Y0.1515 U-8.2143 Z0.5033
G1 X-0.0099 Y0.0006 U-0.0328 Z0.0021
G1 X-2.4639 Y0.1435 U-8.187 Z0.4769
G1 X-0.0314 Y0.0017 U-0.1044 Z0.0064
G1 X-2.4454 Y0.1346 U-8.1254 Z0.4471
G1 X-0.053 Y0.0026 U-0.1759 Z0.0103
G1 X-2.4256 Y0.1251 U-8.0597 Z0.4157
G1 X-0.0745 Y0.0034 U-0.2473 Z0.0136
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
