bialykostek/kontroler/samolot/poziom_prawy_Jasiek_off_650_fix.txt

G17
G21
G91
( SET CUTTER COMPENSATION )
G40
( SET TOOL LENGTH OFFSET )
G49
( SET PATH CONTROL MODE )
G64
( SET FEED RATE MODE )
G94

F1000
G1 X0 Y100 U0 Z100
G1 X300 Y0 U300 Z0
G1 X0 Y-90 U0 Z-90
F40
G1 X0 Y-50 U0 Z-50
G1 X0 Y0 U-39.8989 Z0
G1 X-10 Y0 U-10 Z0
G1 X-4.5048 Y0.4171 U-1.0542 Z0.0976
G1 X-0.7293 Y0.0652 U-0.1706 Z0.0164
G1 X-4.793 Y0.4355 U-1.1217 Z0.1019
G1 X-0.6816 Y0.0588 U-0.1594 Z0.0153
G1 X-6.3696 Y0.5631 U-1.4906 Z0.1318
G1 X-0.6206 Y0.0516 U-0.1451 Z0.0137
G1 X-6.7398 Y0.5769 U-1.5773 Z0.135
G1 X-0.5569 Y0.0447 U-0.1302 Z0.0119
G1 X-6.918 Y0.5724 U-1.619 Z0.134
G1 X-0.4922 Y0.0382 U-0.1151 Z0.0102
G1 X-6.8565 Y0.5486 U-1.6046 Z0.1284
G1 X-0.4285 Y0.0321 U-0.1002 Z0.0086
G1 X-6.9654 Y0.5384 U-1.63 Z0.126
G1 X-0.3644 Y0.0264 U-0.0852 Z0.0071
G1 X-7.1617 Y0.5348 U-1.676 Z0.1252
G1 X-0.299 Y0.0209 U-0.0699 Z0.0056
G1 X-7.2833 Y0.5251 U-1.7044 Z0.1229
G1 X-0.2331 Y0.0157 U-0.0545 Z0.0042
G1 X-7.343 Y0.5099 U-1.7184 Z0.1193
G1 X-0.1673 Y0.0108 U-0.0391 Z0.0029
G1 X-7.4281 Y0.4962 U-1.7383 Z0.1161
G1 X-0.1012 Y0.0063 U-0.0237 Z0.0017
G1 X-7.4715 Y0.4791 U-1.7485 Z0.1121
G1 X-0.0355 Y0.0021 U-0.0083 Z0.0006
G1 X-7.4965 Y0.4593 U-1.7543 Z0.1075
G1 X-0.0299 Y0.0019 U-0.007 Z0.0004
G1 X-7.4716 Y0.4352 U-1.7485 Z0.1018
G1 X-0.0953 Y0.0058 U-0.0223 Z0.0011
G1 X-7.4154 Y0.4081 U-1.7354 Z0.0955
G1 X-0.1606 Y0.0093 U-0.0376 Z0.0017
G1 X-7.3555 Y0.3794 U-1.7213 Z0.0888
G1 X-0.2257 Y0.0123 U-0.0529 Z0.0021
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
