bialykostek/kontroler/plytka/plytka/plytka.kicad_pcb

## KiCad design plytka/plytka/plytka.kicad_pcb (2022-12-01)

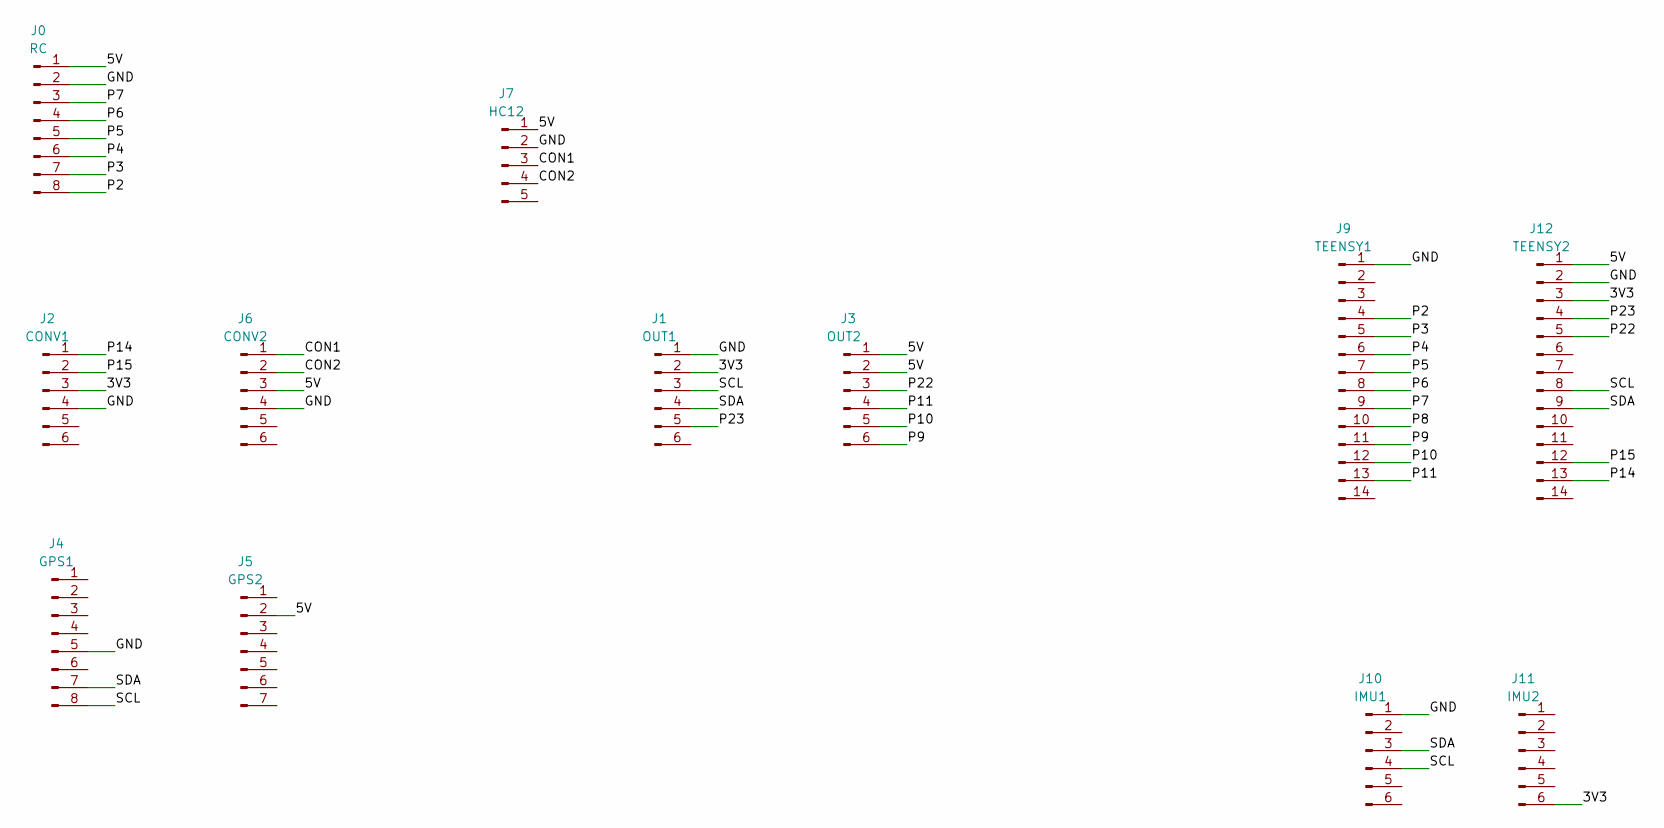
[picture p115: schematic plytka.kicad_sch]

Parts:
J0: RC; PinSocket_1x08_P2.54mm_Vertical
J1: OUT1; PinSocket_1x06_P2.54mm_Vertical
J2: CONV1; PinSocket_1x06_P2.54mm_Vertical
J3: OUT2; PinSocket_1x06_P2.54mm_Vertical
J4: GPS1; PinSocket_1x08_P2.54mm_Vertical
J5: GPS2; PinSocket_1x07_P2.54mm_Vertical
J6: CONV2; PinSocket_1x06_P2.54mm_Vertical
J7: HC12; PinSocket_1x05_P2.54mm_Vertical
J9: TEENSY1; PinSocket_1x14_P2.54mm_Vertical
J10: IMU1; PinSocket_1x06_P2.54mm_Vertical
J11: IMU2; PinSocket_1x06_P2.54mm_Vertical
J12: TEENSY2; PinSocket_1x14_P2.54mm_Vertical

Connections:
/3V3: J1.2, J2.3, J11.6, J12.3
/5V: J0.1, J3.1, J3.2, J5.2, J6.3, J7.1, J12.1
/CON1: J6.1, J7.3
/CON2: J6.2, J7.4
/GND: J0.2, J1.1, J2.4, J4.5, J6.4, J7.2, J9.1, J10.1, J12.2
/P2: J0.8, J9.4
/P3: J0.7, J9.5
/P4: J0.6, J9.6
/P5: J0.5, J9.7
/P6: J0.4, J9.8
/P7: J0.3, J9.9
/P8: J9.10
/P9: J3.6, J9.11
/P10: J3.5, J9.12
/P11: J3.4, J9.13
/P14: J2.1, J12.13
/P15: J2.2, J12.12
/P22: J3.3, J12.5
/P23: J1.5, J12.4
/SCL: J1.3, J4.8, J10.4, J12.8
/SDA: J1.4, J4.7, J10.3, J12.9

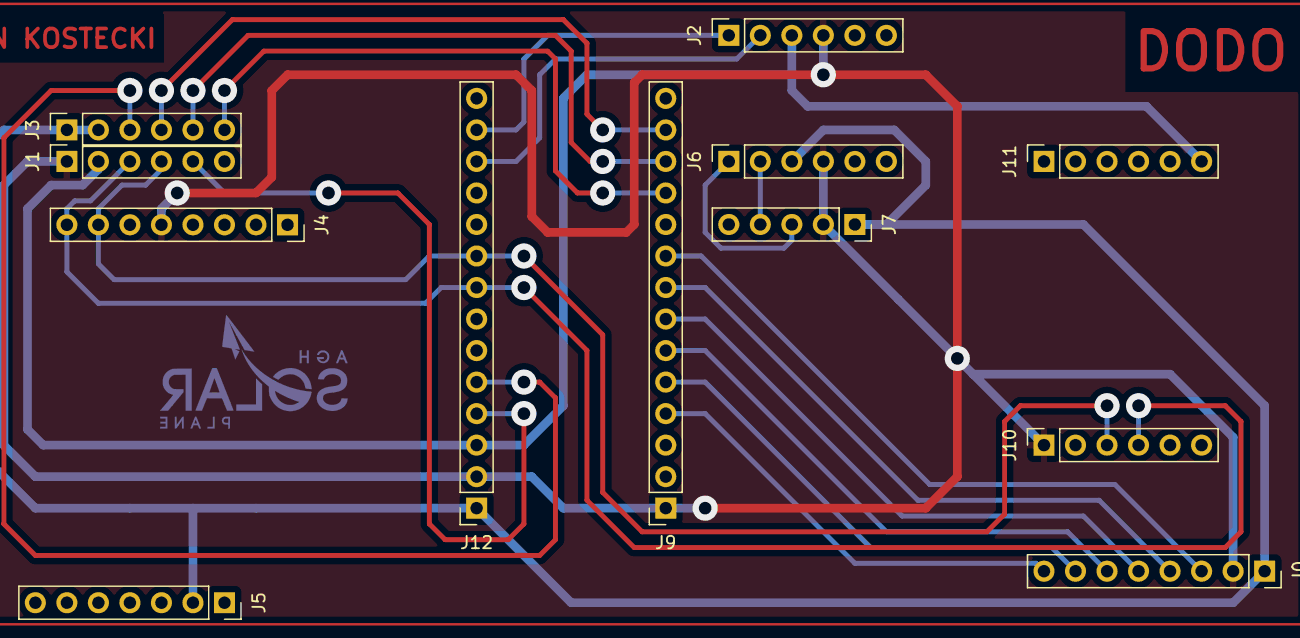
[picture p116: board plytka.kicad_pcb from above]

Board: 2 copper layers, 13 parts (0 on the bottom side), 20 nets.

Other parts of the board:
Ge: LOGO; LogoSolar_15x9
