bialykostek/kontroler/AI/flight_model_2.h

#define TENSORFLOW_LITE_EXPERIMENTAL_MICRO_EXAMPLES_HELLO_WORLD_SINE_MODEL_DATA_H_
#ifdef __has_attribute
#define HAVE_ATTRIBUTE(x) __has_attribute(x)
#else
#define HAVE_ATTRIBUTE(x) 0
#endif
#if HAVE_ATTRIBUTE(aligned) || (defined(__GNUC__) && !defined(__clang__))
#define DATA_ALIGN_ATTRIBUTE __attribute__((aligned(4)))
#else
#define DATA_ALIGN_ATTRIBUTE
#endif

const int flight_model_len = 4584;
const unsigned char flight_model[] DATA_ALIGN_ATTRIBUTE = {
 0x1c, 0x00, 0x00, 0x00, 0x54, 0x46, 0x4c, 0x33, 0x00, 0x00, 0x12, 0x00,
  0x1c, 0x00, 0x04, 0x00, 0x08, 0x00, 0x0c, 0x00, 0x10, 0x00, 0x14, 0x00,
  0x00, 0x00, 0x18, 0x00, 0x12, 0x00, 0x00, 0x00, 0x03, 0x00, 0x00, 0x00,
  0x94, 0x11, 0x00, 0x00, 0x94, 0x0c, 0x00, 0x00, 0x7c, 0x0c, 0x00, 0x00,
  0x34, 0x00, 0x00, 0x00, 0x04, 0x00, 0x00, 0x00, 0x01, 0x00, 0x00, 0x00,
  0x04, 0x00, 0x00, 0x00, 0x10, 0xef, 0xff, 0xff, 0x08, 0x00, 0x00, 0x00,
  0x0d, 0x00, 0x00, 0x00, 0x13, 0x00, 0x00, 0x00, 0x6d, 0x69, 0x6e, 0x5f,
  0x72, 0x75, 0x6e, 0x74, 0x69, 0x6d, 0x65, 0x5f, 0x76, 0x65, 0x72, 0x73,
  0x69, 0x6f, 0x6e, 0x00, 0x0e, 0x00, 0x00, 0x00, 0x3c, 0x0c, 0x00, 0x00,
  0x34, 0x0c, 0x00, 0x00, 0xdc, 0x08, 0x00, 0x00, 0xcc, 0x08, 0x00, 0x00,
  0xc0, 0x08, 0x00, 0x00, 0xb8, 0x08, 0x00, 0x00, 0xb0, 0x08, 0x00, 0x00,
  0xa8, 0x08, 0x00, 0x00, 0xb4, 0x01, 0x00, 0x00, 0x50, 0x01, 0x00, 0x00,
  0x18, 0x01, 0x00, 0x00, 0x40, 0x00, 0x00, 0x00, 0x1c, 0x00, 0x00, 0x00,
  0x04, 0x00, 0x00, 0x00, 0x5a, 0xf7, 0xff, 0xff, 0x04, 0x00, 0x00, 0x00,
  0x06, 0x00, 0x00, 0x00, 0x31, 0x2e, 0x31, 0x34, 0x2e, 0x30, 0x00, 0x00,
  0x6e, 0xf7, 0xff, 0xff, 0x04, 0x00, 0x00, 0x00, 0x14, 0x00, 0x00, 0x00,
  0x9b, 0xf6, 0xa9, 0x3e, 0xce, 0xd2, 0xe3, 0x3e, 0x5a, 0x2d, 0xb8, 0x3e,
  0x74, 0x7d, 0x01, 0x3f, 0x74, 0xfc, 0xdd, 0x3e, 0x8e, 0xf7, 0xff, 0xff,
  0x04, 0x00, 0x00, 0x00, 0xc8, 0x00, 0x00, 0x00, 0x78, 0x6e, 0xbb, 0x3e,
  0x2d, 0xe4, 0x40, 0x3f, 0x7d, 0xa1, 0xe5, 0x3e, 0x48, 0xf8, 0x88, 0x3c,
  0x56, 0x51, 0xb9, 0x3e, 0x4d, 0xcf, 0xd3, 0x3e, 0x3f, 0x17, 0xdb, 0x3d,
  0x43, 0x41, 0xb5, 0x3c, 0x78, 0xd5, 0x04, 0x3f, 0xe3, 0x8a, 0x2b, 0x3e,
  0xac, 0x53, 0xdb, 0xbe, 0x84, 0x86, 0xcd, 0x3d, 0xa2, 0x8c, 0x85, 0x3e,
  0x74, 0x13, 0x9f, 0x3e, 0x32, 0xf3, 0x14, 0xbe, 0x2c, 0x7a, 0xc5, 0xbd,
  0xf5, 0x69, 0x99, 0x3c, 0x0d, 0x5a, 0x54, 0x3e, 0xce, 0x55, 0xcc, 0xbd,
  0xe4, 0x97, 0x8f, 0x3e, 0x35, 0xda, 0xc4, 0xbe, 0x94, 0x44, 0x0c, 0xbd,
  0x14, 0xfd, 0xaf, 0x3e, 0x86, 0xae, 0x9b, 0x3e, 0xe7, 0x26, 0x29, 0xbe,
  0xa2, 0x1e, 0xbb, 0xbd, 0xec, 0x93, 0x14, 0x3d, 0xfb, 0xc2, 0x54, 0x3e,
  0xfe, 0x26, 0xa2, 0xbd, 0x67, 0x1c, 0x79, 0x3e, 0x88, 0x44, 0xce, 0x3d,
  0x92, 0x42, 0x0e, 0xbb, 0x59, 0x48, 0x41, 0x3d, 0x39, 0xfb, 0x0a, 0xbd,
  0xa1, 0x1c, 0x29, 0xbe, 0xca, 0x45, 0x52, 0x3d, 0xa8, 0x8d, 0xf8, 0x3c,
  0x82, 0x81, 0x36, 0xbc, 0xef, 0x36, 0xc3, 0xbd, 0xa3, 0x07, 0x21, 0x3d,
  0x8f, 0xb9, 0xe5, 0xbc, 0xd9, 0x8b, 0xc1, 0xbe, 0x80, 0xbd, 0x6b, 0x3e,
  0x2d, 0x47, 0x90, 0x3c, 0xce, 0x63, 0x98, 0x3e, 0x0f, 0x96, 0xed, 0x3e,
  0xa2, 0xed, 0xf1, 0xbe, 0xc9, 0xae, 0x37, 0x3d, 0xdf, 0xc0, 0xa5, 0x3d,
  0x14, 0x24, 0x1e, 0x3e, 0x62, 0xf8, 0xff, 0xff, 0x04, 0x00, 0x00, 0x00,
  0x28, 0x00, 0x00, 0x00, 0x26, 0xbb, 0x92, 0xbe, 0x89, 0xbe, 0x91, 0xbe,
  0x9a, 0xac, 0x51, 0xbe, 0x70, 0x47, 0xb0, 0xbe, 0x70, 0xb1, 0x94, 0xbe,
  0x8f, 0x3b, 0xcd, 0xbe, 0xa3, 0x31, 0xd5, 0xbe, 0x0d, 0xc8, 0xa9, 0xbe,
  0x3e, 0xa1, 0xa4, 0xbe, 0xc2, 0x69, 0xb3, 0xbe, 0x96, 0xf8, 0xff, 0xff,
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
 
};
