bialykostek/kontroler/AI/flight_model_3.h

#define TENSORFLOW_LITE_EXPERIMENTAL_MICRO_EXAMPLES_HELLO_WORLD_SINE_MODEL_DATA_H_
#ifdef __has_attribute
#define HAVE_ATTRIBUTE(x) __has_attribute(x)
#else
#define HAVE_ATTRIBUTE(x) 0
#endif
#if HAVE_ATTRIBUTE(aligned) || (defined(__GNUC__) && !defined(__clang__))
#define DATA_ALIGN_ATTRIBUTE __attribute__((aligned(4)))
#else
#define DATA_ALIGN_ATTRIBUTE
#endif

const int flight_model_len = 3476;
const unsigned char flight_model[] DATA_ALIGN_ATTRIBUTE = {
 0x1c, 0x00, 0x00, 0x00, 0x54, 0x46, 0x4c, 0x33, 0x00, 0x00, 0x12, 0x00,
  0x1c, 0x00, 0x04, 0x00, 0x08, 0x00, 0x0c, 0x00, 0x10, 0x00, 0x14, 0x00,
  0x00, 0x00, 0x18, 0x00, 0x12, 0x00, 0x00, 0x00, 0x03, 0x00, 0x00, 0x00,
  0x40, 0x0d, 0x00, 0x00, 0xd0, 0x09, 0x00, 0x00, 0xb8, 0x09, 0x00, 0x00,
  0x34, 0x00, 0x00, 0x00, 0x04, 0x00, 0x00, 0x00, 0x01, 0x00, 0x00, 0x00,
  0x04, 0x00, 0x00, 0x00, 0x64, 0xf3, 0xff, 0xff, 0x08, 0x00, 0x00, 0x00,
  0x09, 0x00, 0x00, 0x00, 0x13, 0x00, 0x00, 0x00, 0x6d, 0x69, 0x6e, 0x5f,
  0x72, 0x75, 0x6e, 0x74, 0x69, 0x6d, 0x65, 0x5f, 0x76, 0x65, 0x72, 0x73,
  0x69, 0x6f, 0x6e, 0x00, 0x0a, 0x00, 0x00, 0x00, 0x78, 0x09, 0x00, 0x00,
  0x70, 0x09, 0x00, 0x00, 0xbc, 0x07, 0x00, 0x00, 0xac, 0x07, 0x00, 0x00,
  0xa0, 0x07, 0x00, 0x00, 0x98, 0x07, 0x00, 0x00, 0xa4, 0x00, 0x00, 0x00,
  0x40, 0x00, 0x00, 0x00, 0x1c, 0x00, 0x00, 0x00, 0x04, 0x00, 0x00, 0x00,
  0x6a, 0xf8, 0xff, 0xff, 0x04, 0x00, 0x00, 0x00, 0x06, 0x00, 0x00, 0x00,
  0x31, 0x2e, 0x31, 0x34, 0x2e, 0x30, 0x00, 0x00, 0x7e, 0xf8, 0xff, 0xff,
  0x04, 0x00, 0x00, 0x00, 0x14, 0x00, 0x00, 0x00, 0xf6, 0x63, 0x16, 0x3f,
  0xb7, 0xeb, 0xf7, 0x3e, 0x76, 0xfa, 0xc9, 0x3e, 0x59, 0xe9, 0x00, 0x3f,
  0xef, 0x56, 0x00, 0x3f, 0x9e, 0xf8, 0xff, 0xff, 0x04, 0x00, 0x00, 0x00,
  0x54, 0x00, 0x00, 0x00, 0xf8, 0x78, 0x0e, 0x3d, 0xec, 0x5c, 0xef, 0xbe,
  0x6f, 0x23, 0x5f, 0xbe, 0x73, 0x82, 0x11, 0xbf, 0x6d, 0x18, 0xb9, 0xbe,
  0x1d, 0x2f, 0x1d, 0x3e, 0xca, 0xa7, 0xfc, 0x3d, 0x64, 0x85, 0x84, 0xbc,
  0xa0, 0x86, 0x37, 0xbe, 0x74, 0xfb, 0x70, 0xbe, 0xba, 0x17, 0x04, 0xbf,
  0x27, 0x93, 0x0a, 0xbf, 0x9a, 0x32, 0x81, 0x3a, 0xf0, 0xb7, 0x58, 0xbf,
  0x15, 0x89, 0xfd, 0xbe, 0xd5, 0xaa, 0x16, 0xbe, 0x9a, 0x15, 0xac, 0xbd,
  0x8a, 0xb3, 0xeb, 0xbe, 0xed, 0x81, 0x02, 0xbf, 0xe4, 0xf3, 0x4e, 0xbf,
  0x84, 0x82, 0x71, 0xbd, 0xfe, 0xf8, 0xff, 0xff, 0x04, 0x00, 0x00, 0x00,
  0xe4, 0x06, 0x00, 0x00, 0xea, 0x50, 0xbd, 0xbe, 0x0d, 0x64, 0x98, 0x3d,
  0x98, 0x29, 0x97, 0xbe, 0x44, 0x7b, 0x52, 0xbc, 0xed, 0x89, 0xa9, 0xbe,
  0x1d, 0xd3, 0xa0, 0xbd, 0x20, 0x55, 0xbb, 0xbe, 0x58, 0x71, 0x88, 0x3e,
  0x0a, 0x1e, 0x81, 0xbd, 0x4a, 0xb4, 0x51, 0xbe, 0x0f, 0x1d, 0x82, 0xbe,
  0xe1, 0x3c, 0xf5, 0xbd, 0x1c, 0x86, 0x85, 0xbe, 0xc1, 0xbb, 0x43, 0x3d,
  0x13, 0x87, 0xb9, 0xbe, 0x9f, 0x75, 0xdb, 0x3d, 0x2f, 0xba, 0xda, 0xbf,
  0x50, 0xa3, 0x51, 0xbf, 0xa7, 0x75, 0x5e, 0xbf, 0x7d, 0x07, 0x93, 0x3f,
  0x09, 0x13, 0x7b, 0xbf, 0x9b, 0xb1, 0x25, 0x3e, 0xec, 0x51, 0x23, 0xbe,
  0xea, 0x2c, 0xa9, 0xbd, 0xe2, 0x90, 0xf8, 0xbe, 0xfb, 0x52, 0x96, 0xbd,
  0xf8, 0xc1, 0x43, 0x3e, 0x65, 0xc5, 0x15, 0x3e, 0xc8, 0x8f, 0x11, 0xbe,
  0xae, 0xa8, 0xf5, 0xbe, 0x22, 0x8c, 0x35, 0xbf, 0x94, 0x8a, 0x5a, 0xbe,
  0x8e, 0x1f, 0x99, 0xbd, 0xb4, 0x83, 0x47, 0xbe, 0x07, 0x9b, 0xb0, 0xbd,
  0x7b, 0x6e, 0x22, 0xbe, 0xce, 0x0c, 0x00, 0x3d, 0x27, 0x9a, 0xab, 0x3e,
  0x5e, 0x9f, 0xaf, 0x3e, 0x06, 0x12, 0x3d, 0x3f, 0x45, 0x4c, 0x5a, 0x3c,
  0xbf, 0x6f, 0x85, 0x3e, 0x4c, 0x31, 0xb8, 0xbd, 0x6f, 0x06, 0x01, 0xbf,
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
};
