bialykostek/kontroler/Kontroler/DodoMaster/flight_model_18.h

#define TENSORFLOW_LITE_EXPERIMENTAL_MICRO_EXAMPLES_HELLO_WORLD_SINE_MODEL_DATA_H_
#ifdef __has_attribute
#define HAVE_ATTRIBUTE(x) __has_attribute(x)
#else
#define HAVE_ATTRIBUTE(x) 0
#endif
#if HAVE_ATTRIBUTE(aligned) || (defined(__GNUC__) && !defined(__clang__))
#define DATA_ALIGN_ATTRIBUTE __attribute__((aligned(4)))
#else
#define DATA_ALIGN_ATTRIBUTE
#endif

const int flight_model_len = 32180;
const unsigned char flight_model[] DATA_ALIGN_ATTRIBUTE = {
 0x1c, 0x00, 0x00, 0x00, 0x54, 0x46, 0x4c, 0x33, 0x00, 0x00, 0x12, 0x00,
  0x1c, 0x00, 0x04, 0x00, 0x08, 0x00, 0x0c, 0x00, 0x10, 0x00, 0x14, 0x00,
  0x00, 0x00, 0x18, 0x00, 0x12, 0x00, 0x00, 0x00, 0x03, 0x00, 0x00, 0x00,
  0x70, 0x7d, 0x00, 0x00, 0x08, 0x72, 0x00, 0x00, 0xf0, 0x71, 0x00, 0x00,
  0x34, 0x00, 0x00, 0x00, 0x04, 0x00, 0x00, 0x00, 0x01, 0x00, 0x00, 0x00,
  0x04, 0x00, 0x00, 0x00, 0x34, 0x83, 0xff, 0xff, 0x08, 0x00, 0x00, 0x00,
  0x1d, 0x00, 0x00, 0x00, 0x13, 0x00, 0x00, 0x00, 0x6d, 0x69, 0x6e, 0x5f,
  0x72, 0x75, 0x6e, 0x74, 0x69, 0x6d, 0x65, 0x5f, 0x76, 0x65, 0x72, 0x73,
  0x69, 0x6f, 0x6e, 0x00, 0x1e, 0x00, 0x00, 0x00, 0xb0, 0x71, 0x00, 0x00,
  0xa8, 0x71, 0x00, 0x00, 0xa0, 0x71, 0x00, 0x00, 0x18, 0x71, 0x00, 0x00,
  0x88, 0x70, 0x00, 0x00, 0x80, 0x70, 0x00, 0x00, 0x60, 0x62, 0x00, 0x00,
  0x58, 0x62, 0x00, 0x00, 0x50, 0x62, 0x00, 0x00, 0x48, 0x62, 0x00, 0x00,
  0x40, 0x62, 0x00, 0x00, 0x38, 0x62, 0x00, 0x00, 0x30, 0x62, 0x00, 0x00,
  0x10, 0x54, 0x00, 0x00, 0x80, 0x4c, 0x00, 0x00, 0x78, 0x4c, 0x00, 0x00,
  0x58, 0x3e, 0x00, 0x00, 0xd0, 0x3d, 0x00, 0x00, 0xb0, 0x2f, 0x00, 0x00,
  0x28, 0x2f, 0x00, 0x00, 0xa0, 0x2e, 0x00, 0x00, 0x80, 0x20, 0x00, 0x00,
  0xf8, 0x1f, 0x00, 0x00, 0x70, 0x1f, 0x00, 0x00, 0x50, 0x11, 0x00, 0x00,
  0x30, 0x03, 0x00, 0x00, 0xa8, 0x02, 0x00, 0x00, 0x40, 0x00, 0x00, 0x00,
  0x1c, 0x00, 0x00, 0x00, 0x04, 0x00, 0x00, 0x00, 0x5a, 0x8f, 0xff, 0xff,
  0x04, 0x00, 0x00, 0x00, 0x05, 0x00, 0x00, 0x00, 0x31, 0x2e, 0x35, 0x2e,
  0x30, 0x00, 0x00, 0x00, 0x6e, 0x8f, 0xff, 0xff, 0x04, 0x00, 0x00, 0x00,
  0x14, 0x00, 0x00, 0x00, 0xb0, 0x27, 0x08, 0x3e, 0x31, 0x01, 0xb6, 0x3d,
  0xc7, 0xfa, 0xd1, 0x3d, 0x4b, 0xf0, 0x50, 0x3e, 0x4e, 0xcb, 0xd9, 0x3d,
  0x8e, 0x8f, 0xff, 0xff, 0x04, 0x00, 0x00, 0x00, 0x58, 0x02, 0x00, 0x00,
  0xca, 0xe4, 0x97, 0xbe, 0x3a, 0x9d, 0xe1, 0x3d, 0x2c, 0x46, 0xb6, 0xbe,
  0x7e, 0x88, 0x13, 0xbd, 0xab, 0xe8, 0xe6, 0x3e, 0xc6, 0xc4, 0x20, 0x3d,
  0xd1, 0xd5, 0x59, 0xbe, 0xe3, 0xc1, 0x9f, 0x3d, 0xed, 0x41, 0x65, 0xbe,
  0x25, 0xdf, 0xf9, 0x3d, 0x22, 0x41, 0x83, 0xbd, 0x70, 0xa2, 0xc9, 0x3e,
  0x41, 0xfe, 0xbb, 0xbd, 0x4b, 0x31, 0x75, 0xbd, 0x14, 0x14, 0x23, 0x3e,
  0xcd, 0x67, 0xae, 0x3e, 0x64, 0x1e, 0x83, 0x3c, 0x93, 0x2e, 0x20, 0xbe,
  0xb2, 0xad, 0xb2, 0x3d, 0xae, 0x40, 0x25, 0x3e, 0x5b, 0x68, 0x3d, 0x3e,
  0xb2, 0x15, 0x6a, 0x3d, 0x47, 0xb2, 0x9b, 0x3e, 0x78, 0x6e, 0x83, 0xbe,
  0xca, 0x45, 0x3c, 0xbe, 0xff, 0x66, 0xb6, 0xbd, 0x8e, 0x72, 0x4e, 0xbe,
  0x36, 0x1b, 0xa6, 0xbe, 0xfc, 0x26, 0xd8, 0x3e, 0xd0, 0x61, 0x83, 0xbe,
  0xe4, 0x3a, 0x21, 0xbe, 0xae, 0x25, 0x2b, 0x3e, 0xf9, 0xa3, 0xc0, 0xbd,
  0xcc, 0x9d, 0x50, 0xbe, 0xdd, 0xfc, 0x2f, 0x3e, 0x5b, 0xae, 0x3f, 0xbe,
  0x45, 0x50, 0x9d, 0x3e, 0x27, 0x07, 0x50, 0xbe, 0x54, 0xa4, 0xa1, 0xbd,
  0x95, 0x0e, 0xa4, 0xbe, 0x00, 0xfb, 0x5e, 0x3e, 0xd0, 0x9c, 0x99, 0xbe,
  0x2b, 0x1c, 0xb7, 0x3e, 0xd0, 0x4a, 0x42, 0xbe, 0x39, 0xdf, 0x67, 0xbe,
  0x5c, 0xba, 0x72, 0x3d, 0xc0, 0x4f, 0x07, 0xbe, 0xeb, 0x1f, 0x18, 0x3d,
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
};
