bialykostek/kontroler/Kontroler/babyDodoTFPPM/flight_model_1.h

#define TENSORFLOW_LITE_EXPERIMENTAL_MICRO_EXAMPLES_HELLO_WORLD_SINE_MODEL_DATA_H_
#ifdef __has_attribute
#define HAVE_ATTRIBUTE(x) __has_attribute(x)
#else
#define HAVE_ATTRIBUTE(x) 0
#endif
#if HAVE_ATTRIBUTE(aligned) || (defined(__GNUC__) && !defined(__clang__))
#define DATA_ALIGN_ATTRIBUTE __attribute__((aligned(4)))
#else
#define DATA_ALIGN_ATTRIBUTE
#endif

const int flight_model_len = 4468;
const unsigned char flight_model[] DATA_ALIGN_ATTRIBUTE = {
 0x1c, 0x00, 0x00, 0x00, 0x54, 0x46, 0x4c, 0x33, 0x00, 0x00, 0x12, 0x00,
  0x1c, 0x00, 0x04, 0x00, 0x08, 0x00, 0x0c, 0x00, 0x10, 0x00, 0x14, 0x00,
  0x00, 0x00, 0x18, 0x00, 0x12, 0x00, 0x00, 0x00, 0x03, 0x00, 0x00, 0x00,
  0x20, 0x11, 0x00, 0x00, 0x8c, 0x0c, 0x00, 0x00, 0x74, 0x0c, 0x00, 0x00,
  0x34, 0x00, 0x00, 0x00, 0x04, 0x00, 0x00, 0x00, 0x01, 0x00, 0x00, 0x00,
  0x04, 0x00, 0x00, 0x00, 0x84, 0xef, 0xff, 0xff, 0x08, 0x00, 0x00, 0x00,
  0x0c, 0x00, 0x00, 0x00, 0x13, 0x00, 0x00, 0x00, 0x6d, 0x69, 0x6e, 0x5f,
  0x72, 0x75, 0x6e, 0x74, 0x69, 0x6d, 0x65, 0x5f, 0x76, 0x65, 0x72, 0x73,
  0x69, 0x6f, 0x6e, 0x00, 0x0d, 0x00, 0x00, 0x00, 0x34, 0x0c, 0x00, 0x00,
  0x2c, 0x0c, 0x00, 0x00, 0xd4, 0x08, 0x00, 0x00, 0xc4, 0x08, 0x00, 0x00,
  0xb8, 0x08, 0x00, 0x00, 0xb0, 0x08, 0x00, 0x00, 0xa8, 0x08, 0x00, 0x00,
  0xb4, 0x01, 0x00, 0x00, 0x50, 0x01, 0x00, 0x00, 0x18, 0x01, 0x00, 0x00,
  0x40, 0x00, 0x00, 0x00, 0x1c, 0x00, 0x00, 0x00, 0x04, 0x00, 0x00, 0x00,
  0x5e, 0xf7, 0xff, 0xff, 0x04, 0x00, 0x00, 0x00, 0x06, 0x00, 0x00, 0x00,
  0x31, 0x2e, 0x31, 0x34, 0x2e, 0x30, 0x00, 0x00, 0x72, 0xf7, 0xff, 0xff,
  0x04, 0x00, 0x00, 0x00, 0x14, 0x00, 0x00, 0x00, 0x1e, 0x64, 0x1a, 0x3f,
  0x62, 0xd9, 0x00, 0x3f, 0x29, 0xc4, 0xd6, 0x3e, 0xf6, 0x26, 0xfd, 0x3e,
  0x7f, 0xa5, 0xe1, 0x3e, 0x92, 0xf7, 0xff, 0xff, 0x04, 0x00, 0x00, 0x00,
  0xc8, 0x00, 0x00, 0x00, 0xa1, 0x6c, 0x34, 0x3f, 0x7a, 0x9e, 0x34, 0x3e,
  0x9a, 0x23, 0x3f, 0x3e, 0x23, 0x15, 0xa4, 0x3e, 0xa4, 0x99, 0xe2, 0xbd,
  0x40, 0xa7, 0xa7, 0xbd, 0xdd, 0x2c, 0x25, 0xbf, 0x8d, 0x72, 0xc7, 0x3e,
  0x93, 0x94, 0x00, 0xbf, 0x91, 0x51, 0xc3, 0x3d, 0x1b, 0x52, 0x20, 0x3e,
  0xb6, 0xde, 0x83, 0xbe, 0x92, 0xb4, 0x26, 0x3e, 0xe3, 0x1c, 0xbc, 0x3e,
  0xeb, 0xa6, 0xad, 0x3e, 0x24, 0x0f, 0x1a, 0x3f, 0xca, 0x34, 0x29, 0x3e,
  0x99, 0x16, 0x37, 0x3e, 0x93, 0x4c, 0x87, 0xbe, 0x18, 0xbe, 0xa6, 0x3e,
  0x28, 0x96, 0xe3, 0x3d, 0xab, 0xf5, 0xed, 0xbd, 0x5a, 0x84, 0x4a, 0x3e,
  0x8a, 0x91, 0xb7, 0x3d, 0x82, 0x91, 0xff, 0x3e, 0x73, 0x1a, 0x1d, 0x3f,
  0x7c, 0x36, 0xbf, 0xbd, 0xc6, 0x80, 0x2e, 0xbe, 0x50, 0x51, 0x8b, 0xbe,
  0x1e, 0x0c, 0x79, 0x3e, 0x3f, 0xb3, 0x01, 0xbf, 0xbf, 0x8c, 0xd3, 0xbc,
  0xd0, 0x90, 0x21, 0x3f, 0x97, 0x1d, 0x92, 0x3e, 0x40, 0xfc, 0x30, 0x3e,
  0xcb, 0x98, 0xca, 0xbe, 0x0a, 0xb0, 0x8d, 0xbe, 0x52, 0x16, 0xa1, 0x3a,
  0x54, 0x95, 0x12, 0xbd, 0x60, 0x23, 0x29, 0x3e, 0x86, 0xbf, 0x08, 0x3f,
  0xbb, 0xb3, 0x28, 0xbf, 0x25, 0x64, 0x12, 0x3a, 0x82, 0x96, 0xbf, 0x3d,
  0x1d, 0xc0, 0x83, 0x3c, 0x22, 0xb4, 0x18, 0xbf, 0x85, 0xc9, 0x08, 0xbe,
  0x2e, 0x54, 0x08, 0xbf, 0xe3, 0x99, 0x8d, 0x3d, 0x4c, 0x29, 0x4e, 0x3e,
  0x66, 0xf8, 0xff, 0xff, 0x04, 0x00, 0x00, 0x00, 0x28, 0x00, 0x00, 0x00,
  0x63, 0x6c, 0xca, 0x3d, 0x1e, 0x6f, 0xfc, 0xbd, 0x98, 0xd0, 0xae, 0x3d,
  0xcd, 0x7d, 0x7e, 0x3d, 0x77, 0xde, 0xeb, 0x3d, 0x0b, 0xdb, 0x31, 0xbc,
  0x0b, 0x11, 0x34, 0xbd, 0x98, 0xa1, 0xa0, 0x3c, 0x60, 0x22, 0x91, 0xbd,
  0x3d, 0xdc, 0x2a, 0x3d, 0x9a, 0xf8, 0xff, 0xff, 0x04, 0x00, 0x00, 0x00,
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
};
