bialykostek/kontroler/Kontroler/babyDodoTFPPM/flight_model_10.h

#define TENSORFLOW_LITE_EXPERIMENTAL_MICRO_EXAMPLES_HELLO_WORLD_SINE_MODEL_DATA_H_
#ifdef __has_attribute
#define HAVE_ATTRIBUTE(x) __has_attribute(x)
#else
#define HAVE_ATTRIBUTE(x) 0
#endif
#if HAVE_ATTRIBUTE(aligned) || (defined(__GNUC__) && !defined(__clang__))
#define DATA_ALIGN_ATTRIBUTE __attribute__((aligned(4)))
#else
#define DATA_ALIGN_ATTRIBUTE
#endif

const int flight_model_len = 3728;
const unsigned char flight_model[] DATA_ALIGN_ATTRIBUTE = {
 0x1c, 0x00, 0x00, 0x00, 0x54, 0x46, 0x4c, 0x33, 0x00, 0x00, 0x12, 0x00,
  0x1c, 0x00, 0x04, 0x00, 0x08, 0x00, 0x0c, 0x00, 0x10, 0x00, 0x14, 0x00,
  0x00, 0x00, 0x18, 0x00, 0x12, 0x00, 0x00, 0x00, 0x03, 0x00, 0x00, 0x00,
  0x4c, 0x0e, 0x00, 0x00, 0x3c, 0x0b, 0x00, 0x00, 0x24, 0x0b, 0x00, 0x00,
  0x34, 0x00, 0x00, 0x00, 0x04, 0x00, 0x00, 0x00, 0x01, 0x00, 0x00, 0x00,
  0x04, 0x00, 0x00, 0x00, 0x58, 0xf2, 0xff, 0xff, 0x08, 0x00, 0x00, 0x00,
  0x08, 0x00, 0x00, 0x00, 0x13, 0x00, 0x00, 0x00, 0x6d, 0x69, 0x6e, 0x5f,
  0x72, 0x75, 0x6e, 0x74, 0x69, 0x6d, 0x65, 0x5f, 0x76, 0x65, 0x72, 0x73,
  0x69, 0x6f, 0x6e, 0x00, 0x09, 0x00, 0x00, 0x00, 0xe4, 0x0a, 0x00, 0x00,
  0xdc, 0x0a, 0x00, 0x00, 0x74, 0x08, 0x00, 0x00, 0x64, 0x08, 0x00, 0x00,
  0x58, 0x08, 0x00, 0x00, 0xc8, 0x00, 0x00, 0x00, 0x40, 0x00, 0x00, 0x00,
  0x1c, 0x00, 0x00, 0x00, 0x04, 0x00, 0x00, 0x00, 0xae, 0xf7, 0xff, 0xff,
  0x04, 0x00, 0x00, 0x00, 0x05, 0x00, 0x00, 0x00, 0x31, 0x2e, 0x35, 0x2e,
  0x30, 0x00, 0x00, 0x00, 0xc2, 0xf7, 0xff, 0xff, 0x04, 0x00, 0x00, 0x00,
  0x14, 0x00, 0x00, 0x00, 0x7c, 0x82, 0x03, 0x3e, 0xce, 0x05, 0x57, 0x3e,
  0xf4, 0xb8, 0x86, 0x3d, 0x73, 0xd7, 0xfc, 0x3d, 0x69, 0x75, 0xa5, 0x3d,
  0xe2, 0xf7, 0xff, 0xff, 0x04, 0x00, 0x00, 0x00, 0x78, 0x00, 0x00, 0x00,
  0x13, 0x02, 0xca, 0xbd, 0x7d, 0x3a, 0x65, 0x3e, 0x3e, 0x80, 0x3e, 0xbd,
  0x14, 0x53, 0xf1, 0x3d, 0x4d, 0xda, 0xc3, 0xbb, 0x8c, 0x2d, 0x0e, 0x3e,
  0x6c, 0x8e, 0x91, 0xbd, 0x40, 0x48, 0xd3, 0xbd, 0xf7, 0x15, 0x67, 0xbc,
  0x05, 0x0d, 0xac, 0xbd, 0x00, 0x00, 0x00, 0x00, 0x00, 0x00, 0x00, 0x00,
  0x00, 0x00, 0x00, 0x00, 0x00, 0x00, 0x00, 0x00, 0x00, 0x00, 0x00, 0x00,
  0x6c, 0x3d, 0x80, 0x3d, 0xe1, 0x38, 0xcc, 0xbd, 0x72, 0x1b, 0x20, 0xbd,
  0x00, 0x00, 0x00, 0x00, 0xc4, 0x85, 0x07, 0x3e, 0x00, 0x00, 0x00, 0x00,
  0x63, 0x01, 0x98, 0xbd, 0x42, 0x05, 0x35, 0xbd, 0x00, 0x00, 0x00, 0x00,
  0x00, 0x00, 0x00, 0x00, 0xf2, 0x68, 0x25, 0x3e, 0xac, 0xb8, 0xa4, 0x3d,
  0xe0, 0xf3, 0xe6, 0xbc, 0xb3, 0xc8, 0x02, 0x3e, 0xb7, 0x29, 0x0a, 0xbd,
  0x66, 0xf8, 0xff, 0xff, 0x04, 0x00, 0x00, 0x00, 0x80, 0x07, 0x00, 0x00,
  0x34, 0xe6, 0x5d, 0x3e, 0x73, 0x8d, 0x4a, 0x3e, 0x6e, 0xd8, 0x2c, 0x3e,
  0x55, 0xd7, 0x1b, 0x3e, 0x92, 0x00, 0x86, 0x3e, 0x15, 0x15, 0x46, 0xbe,
  0xd9, 0x2d, 0x1a, 0x3e, 0xea, 0x8b, 0x99, 0xbd, 0xb5, 0x13, 0x12, 0xbd,
  0x67, 0xf1, 0xa4, 0xbd, 0x1b, 0x10, 0xe9, 0x3d, 0xfa, 0x97, 0x87, 0x3e,
  0x59, 0xa5, 0x67, 0xbe, 0x27, 0xba, 0x64, 0x3e, 0xc0, 0x88, 0x5e, 0x3e,
  0xb7, 0x8e, 0x8d, 0xbe, 0x71, 0xa0, 0xf8, 0xbd, 0xad, 0x07, 0x5e, 0x3b,
  0xba, 0xa7, 0xde, 0x3e, 0x5f, 0x56, 0x7b, 0x3e, 0x53, 0x25, 0x07, 0x3e,
  0x46, 0x79, 0x9d, 0xbe, 0x86, 0x0e, 0xc6, 0xbc, 0x9d, 0x41, 0x3e, 0xbe,
  0xf5, 0xd6, 0xd5, 0xbd, 0xab, 0x27, 0x78, 0x3e, 0xd3, 0x1d, 0x77, 0xbe,
  0xd3, 0x25, 0x82, 0x3e, 0xab, 0xe1, 0xcd, 0xbd, 0xe7, 0x9f, 0xb3, 0x3c,
  0x20, 0xc3, 0x1c, 0xbe, 0x6d, 0x93, 0x33, 0xbe, 0x80, 0x0f, 0x81, 0xbd,
  0x75, 0x42, 0x92, 0x3e, 0xaf, 0xa9, 0xf9, 0x3d, 0x67, 0x39, 0x84, 0xbe,
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
};
