bialykostek/kontroler/Kontroler/babyDodoTFPPM/flight_model_11.h

#define TENSORFLOW_LITE_EXPERIMENTAL_MICRO_EXAMPLES_HELLO_WORLD_SINE_MODEL_DATA_H_
#ifdef __has_attribute
#define HAVE_ATTRIBUTE(x) __has_attribute(x)
#else
#define HAVE_ATTRIBUTE(x) 0
#endif
#if HAVE_ATTRIBUTE(aligned) || (defined(__GNUC__) && !defined(__clang__))
#define DATA_ALIGN_ATTRIBUTE __attribute__((aligned(4)))
#else
#define DATA_ALIGN_ATTRIBUTE
#endif

const int flight_model_len = 15880;
const unsigned char flight_model[] DATA_ALIGN_ATTRIBUTE = {
 0x1c, 0x00, 0x00, 0x00, 0x54, 0x46, 0x4c, 0x33, 0x00, 0x00, 0x12, 0x00,
  0x1c, 0x00, 0x04, 0x00, 0x08, 0x00, 0x0c, 0x00, 0x10, 0x00, 0x14, 0x00,
  0x00, 0x00, 0x18, 0x00, 0x12, 0x00, 0x00, 0x00, 0x03, 0x00, 0x00, 0x00,
  0xc4, 0x3d, 0x00, 0x00, 0x48, 0x37, 0x00, 0x00, 0x30, 0x37, 0x00, 0x00,
  0x34, 0x00, 0x00, 0x00, 0x04, 0x00, 0x00, 0x00, 0x01, 0x00, 0x00, 0x00,
  0x04, 0x00, 0x00, 0x00, 0xe0, 0xc2, 0xff, 0xff, 0x08, 0x00, 0x00, 0x00,
  0x11, 0x00, 0x00, 0x00, 0x13, 0x00, 0x00, 0x00, 0x6d, 0x69, 0x6e, 0x5f,
  0x72, 0x75, 0x6e, 0x74, 0x69, 0x6d, 0x65, 0x5f, 0x76, 0x65, 0x72, 0x73,
  0x69, 0x6f, 0x6e, 0x00, 0x12, 0x00, 0x00, 0x00, 0xf0, 0x36, 0x00, 0x00,
  0xe8, 0x36, 0x00, 0x00, 0xc8, 0x28, 0x00, 0x00, 0x58, 0x26, 0x00, 0x00,
  0xd0, 0x25, 0x00, 0x00, 0xc8, 0x25, 0x00, 0x00, 0xc0, 0x25, 0x00, 0x00,
  0xb8, 0x25, 0x00, 0x00, 0xb0, 0x25, 0x00, 0x00, 0xa8, 0x25, 0x00, 0x00,
  0x18, 0x1e, 0x00, 0x00, 0x90, 0x1d, 0x00, 0x00, 0x08, 0x1d, 0x00, 0x00,
  0xe8, 0x0e, 0x00, 0x00, 0xc8, 0x00, 0x00, 0x00, 0x40, 0x00, 0x00, 0x00,
  0x1c, 0x00, 0x00, 0x00, 0x04, 0x00, 0x00, 0x00, 0x7e, 0xd7, 0xff, 0xff,
  0x04, 0x00, 0x00, 0x00, 0x05, 0x00, 0x00, 0x00, 0x31, 0x2e, 0x35, 0x2e,
  0x30, 0x00, 0x00, 0x00, 0x92, 0xd7, 0xff, 0xff, 0x04, 0x00, 0x00, 0x00,
  0x14, 0x00, 0x00, 0x00, 0x4e, 0x9c, 0x95, 0x3d, 0x91, 0x2d, 0x86, 0x3d,
  0x03, 0xfb, 0x71, 0x3d, 0xe2, 0x8d, 0x00, 0x3e, 0xf2, 0x24, 0x99, 0x3d,
  0xb2, 0xd7, 0xff, 0xff, 0x04, 0x00, 0x00, 0x00, 0x78, 0x00, 0x00, 0x00,
  0x7e, 0xb9, 0x4c, 0xbd, 0xe7, 0xd7, 0x6b, 0x3d, 0x82, 0x38, 0xa0, 0x3d,
  0x59, 0x93, 0x4a, 0xbd, 0x3c, 0xfa, 0xc6, 0x3d, 0x19, 0x96, 0xbd, 0x3c,
  0x67, 0x2c, 0x0c, 0xbd, 0xed, 0x90, 0xbc, 0x3d, 0x30, 0x22, 0x97, 0x3d,
  0xa1, 0x71, 0x83, 0xbc, 0xfc, 0x50, 0x13, 0x3d, 0x19, 0x63, 0xee, 0xbb,
  0x00, 0x00, 0x00, 0x00, 0x00, 0x00, 0x00, 0x00, 0xb6, 0x3e, 0x50, 0xbd,
  0x00, 0x00, 0x00, 0x00, 0x1b, 0x83, 0x46, 0xbd, 0xa7, 0x42, 0x90, 0x3d,
  0xd5, 0xa1, 0xfd, 0xbc, 0x55, 0x5f, 0x10, 0xbd, 0xb5, 0xdf, 0xb4, 0x3d,
  0x00, 0x00, 0x00, 0x00, 0x04, 0x32, 0x8a, 0xbc, 0x89, 0x0e, 0xdb, 0xbc,
  0x2a, 0xa3, 0x17, 0x3d, 0xb9, 0xd4, 0x55, 0x3d, 0xac, 0xaf, 0xab, 0x3c,
  0x4e, 0x04, 0xf7, 0xbc, 0x00, 0x00, 0x00, 0x00, 0x00, 0x00, 0x00, 0x00,
  0x36, 0xd8, 0xff, 0xff, 0x04, 0x00, 0x00, 0x00, 0x10, 0x0e, 0x00, 0x00,
  0xbe, 0xe2, 0xb5, 0xbe, 0xa0, 0x5f, 0x85, 0x3e, 0xfc, 0x8a, 0x00, 0xbe,
  0x5c, 0xf8, 0xf9, 0x3d, 0x56, 0x9f, 0x9a, 0x3e, 0x79, 0x74, 0x1e, 0x3d,
  0xf6, 0x6b, 0x2d, 0x3e, 0xe1, 0x4b, 0x75, 0x3e, 0x8e, 0xec, 0x55, 0x3e,
  0x2a, 0x6d, 0x02, 0x3e, 0x54, 0x7a, 0x35, 0x3e, 0x40, 0x5a, 0xd9, 0x3d,
  0x75, 0xd3, 0xdf, 0x3d, 0x26, 0xf7, 0x85, 0xbe, 0x4a, 0x28, 0x8f, 0xbe,
  0x69, 0xfd, 0x21, 0xbe, 0x49, 0x2d, 0x01, 0x3e, 0xfe, 0xb7, 0xf2, 0xbc,
  0x61, 0x2c, 0x1f, 0x3e, 0xc0, 0xb2, 0x3f, 0xbd, 0x40, 0x6b, 0x31, 0x3d,
  0x5d, 0x47, 0x14, 0x3e, 0x73, 0x84, 0xd6, 0x3b, 0x04, 0xae, 0xa4, 0x3e,
  0x85, 0x93, 0xee, 0x3d, 0x32, 0x4f, 0x28, 0x3e, 0x43, 0x9f, 0x37, 0x3e,
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
};
