bialykostek/kontroler/Kontroler/babyDodoTFPPM/flight_model_12.h

#define TENSORFLOW_LITE_EXPERIMENTAL_MICRO_EXAMPLES_HELLO_WORLD_SINE_MODEL_DATA_H_
#ifdef __has_attribute
#define HAVE_ATTRIBUTE(x) __has_attribute(x)
#else
#define HAVE_ATTRIBUTE(x) 0
#endif
#if HAVE_ATTRIBUTE(aligned) || (defined(__GNUC__) && !defined(__clang__))
#define DATA_ALIGN_ATTRIBUTE __attribute__((aligned(4)))
#else
#define DATA_ALIGN_ATTRIBUTE
#endif

const int flight_model_len = 9976;
const unsigned char flight_model[] DATA_ALIGN_ATTRIBUTE = {
 0x20, 0x00, 0x00, 0x00, 0x54, 0x46, 0x4c, 0x33, 0x00, 0x00, 0x00, 0x00,
  0x00, 0x00, 0x12, 0x00, 0x1c, 0x00, 0x04, 0x00, 0x08, 0x00, 0x0c, 0x00,
  0x10, 0x00, 0x14, 0x00, 0x00, 0x00, 0x18, 0x00, 0x12, 0x00, 0x00, 0x00,
  0x03, 0x00, 0x00, 0x00, 0xb0, 0x26, 0x00, 0x00, 0x1c, 0x21, 0x00, 0x00,
  0x04, 0x21, 0x00, 0x00, 0x34, 0x00, 0x00, 0x00, 0x04, 0x00, 0x00, 0x00,
  0x01, 0x00, 0x00, 0x00, 0x04, 0x00, 0x00, 0x00, 0xf4, 0xd9, 0xff, 0xff,
  0x08, 0x00, 0x00, 0x00, 0x0e, 0x00, 0x00, 0x00, 0x13, 0x00, 0x00, 0x00,
  0x6d, 0x69, 0x6e, 0x5f, 0x72, 0x75, 0x6e, 0x74, 0x69, 0x6d, 0x65, 0x5f,
  0x76, 0x65, 0x72, 0x73, 0x69, 0x6f, 0x6e, 0x00, 0x0f, 0x00, 0x00, 0x00,
  0xc4, 0x20, 0x00, 0x00, 0xbc, 0x20, 0x00, 0x00, 0x6c, 0x1a, 0x00, 0x00,
  0x5c, 0x1a, 0x00, 0x00, 0x50, 0x1a, 0x00, 0x00, 0x48, 0x1a, 0x00, 0x00,
  0x40, 0x1a, 0x00, 0x00, 0x30, 0x10, 0x00, 0x00, 0x80, 0x0f, 0x00, 0x00,
  0xd0, 0x0e, 0x00, 0x00, 0x40, 0x02, 0x00, 0x00, 0xe0, 0x01, 0x00, 0x00,
  0x40, 0x00, 0x00, 0x00, 0x1c, 0x00, 0x00, 0x00, 0x04, 0x00, 0x00, 0x00,
  0xce, 0xe5, 0xff, 0xff, 0x04, 0x00, 0x00, 0x00, 0x05, 0x00, 0x00, 0x00,
  0x31, 0x2e, 0x35, 0x2e, 0x30, 0x00, 0x00, 0x00, 0xe2, 0xe5, 0xff, 0xff,
  0x04, 0x00, 0x00, 0x00, 0x14, 0x00, 0x00, 0x00, 0xae, 0xba, 0xe8, 0x3d,
  0x58, 0x10, 0xac, 0x3d, 0xd5, 0x94, 0xa4, 0x3d, 0x29, 0xea, 0x1c, 0x3e,
  0x67, 0x15, 0xe9, 0x3d, 0x02, 0xe6, 0xff, 0xff, 0x04, 0x00, 0x00, 0x00,
  0x90, 0x01, 0x00, 0x00, 0xb7, 0x70, 0x69, 0x3d, 0x87, 0xaf, 0xc4, 0x3e,
  0x9a, 0x12, 0x88, 0xbe, 0x6b, 0xe0, 0xf9, 0xbe, 0xe8, 0xe5, 0xb9, 0xbe,
  0x5e, 0xc8, 0x64, 0xbf, 0xb6, 0x2c, 0xc5, 0xbe, 0x54, 0x4a, 0x7b, 0x3c,
  0x98, 0xc6, 0x20, 0x3f, 0x05, 0xaf, 0xc0, 0xbe, 0x3e, 0x3a, 0x3e, 0x3e,
  0xff, 0x2c, 0x19, 0xbe, 0x10, 0x1f, 0x76, 0x3e, 0xa0, 0x16, 0xa8, 0xbd,
  0x2a, 0x6f, 0x46, 0x3e, 0xa2, 0xf6, 0x8a, 0x3e, 0x2c, 0x2d, 0x74, 0xbe,
  0x74, 0xca, 0x15, 0xbe, 0x61, 0x72, 0x23, 0xbe, 0xdb, 0xd7, 0xd5, 0xbe,
  0x52, 0x7d, 0x55, 0xbf, 0x53, 0x0a, 0x04, 0x3f, 0x49, 0x66, 0xab, 0xbd,
  0x9c, 0x5f, 0xee, 0x3e, 0xb5, 0x77, 0xf0, 0x3e, 0x7c, 0xb5, 0x22, 0x3f,
  0x72, 0x12, 0x4d, 0xbe, 0x2d, 0x33, 0x81, 0x3c, 0xe7, 0x8e, 0x67, 0xbe,
  0xcb, 0xdd, 0xd0, 0xbe, 0xbd, 0x5a, 0x4f, 0xbe, 0x9f, 0xd9, 0xc4, 0x3d,
  0x4d, 0x3f, 0x06, 0x3f, 0xca, 0xe6, 0x29, 0x3e, 0xa0, 0x90, 0x75, 0x3c,
  0x3c, 0xe2, 0xb0, 0x3e, 0xe3, 0x3e, 0x2b, 0x3d, 0x68, 0x21, 0x09, 0x3e,
  0x3a, 0xd2, 0x88, 0xbe, 0x0c, 0xf2, 0xd9, 0x3e, 0xdd, 0x6b, 0x54, 0xbf,
  0x62, 0x7b, 0x95, 0x3e, 0xcd, 0xa6, 0xc1, 0xbc, 0xfb, 0xef, 0xe6, 0x3e,
  0x6f, 0x0c, 0x0e, 0x3e, 0x51, 0xb6, 0x02, 0x3f, 0xcb, 0x29, 0x98, 0x3e,
  0x85, 0x93, 0x3a, 0xbe, 0x40, 0x98, 0x81, 0x3d, 0xfc, 0x94, 0xc5, 0xbe,
  0x3c, 0xbc, 0xaa, 0x3e, 0x28, 0xae, 0x0c, 0x3f, 0x6b, 0x65, 0x20, 0x3f,
  0x11, 0x50, 0x13, 0x3e, 0x56, 0x5c, 0xf9, 0xbe, 0x62, 0x55, 0x8d, 0x3d,
  0x20, 0xeb, 0x2e, 0x3e, 0xfb, 0x55, 0x89, 0xbe, 0xf4, 0x97, 0xf3, 0x3e,
  0x2a, 0x43, 0xd6, 0x3e, 0x18, 0xd9, 0x84, 0x3e, 0xee, 0x70, 0xc3, 0x3e,
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
};
