bialykostek/kontroler/Kontroler/babyDodoTFPPM/flight_model_13.h

#define TENSORFLOW_LITE_EXPERIMENTAL_MICRO_EXAMPLES_HELLO_WORLD_SINE_MODEL_DATA_H_
#ifdef __has_attribute
#define HAVE_ATTRIBUTE(x) __has_attribute(x)
#else
#define HAVE_ATTRIBUTE(x) 0
#endif
#if HAVE_ATTRIBUTE(aligned) || (defined(__GNUC__) && !defined(__clang__))
#define DATA_ALIGN_ATTRIBUTE __attribute__((aligned(4)))
#else
#define DATA_ALIGN_ATTRIBUTE
#endif

const int flight_model_len = 5928;
const unsigned char flight_model[] DATA_ALIGN_ATTRIBUTE = {
 0x1c, 0x00, 0x00, 0x00, 0x54, 0x46, 0x4c, 0x33, 0x00, 0x00, 0x12, 0x00,
  0x1c, 0x00, 0x04, 0x00, 0x08, 0x00, 0x0c, 0x00, 0x10, 0x00, 0x14, 0x00,
  0x00, 0x00, 0x18, 0x00, 0x12, 0x00, 0x00, 0x00, 0x03, 0x00, 0x00, 0x00,
  0xe4, 0x16, 0x00, 0x00, 0x74, 0x12, 0x00, 0x00, 0x5c, 0x12, 0x00, 0x00,
  0x34, 0x00, 0x00, 0x00, 0x04, 0x00, 0x00, 0x00, 0x01, 0x00, 0x00, 0x00,
  0x04, 0x00, 0x00, 0x00, 0xc0, 0xe9, 0xff, 0xff, 0x08, 0x00, 0x00, 0x00,
  0x0b, 0x00, 0x00, 0x00, 0x13, 0x00, 0x00, 0x00, 0x6d, 0x69, 0x6e, 0x5f,
  0x72, 0x75, 0x6e, 0x74, 0x69, 0x6d, 0x65, 0x5f, 0x76, 0x65, 0x72, 0x73,
  0x69, 0x6f, 0x6e, 0x00, 0x0c, 0x00, 0x00, 0x00, 0x1c, 0x12, 0x00, 0x00,
  0x14, 0x12, 0x00, 0x00, 0x38, 0x0d, 0x00, 0x00, 0x28, 0x0d, 0x00, 0x00,
  0x1c, 0x0d, 0x00, 0x00, 0x14, 0x0d, 0x00, 0x00, 0x44, 0x04, 0x00, 0x00,
  0xa8, 0x03, 0x00, 0x00, 0x0c, 0x03, 0x00, 0x00, 0x40, 0x00, 0x00, 0x00,
  0x1c, 0x00, 0x00, 0x00, 0x04, 0x00, 0x00, 0x00, 0xf6, 0xf2, 0xff, 0xff,
  0x04, 0x00, 0x00, 0x00, 0x05, 0x00, 0x00, 0x00, 0x31, 0x2e, 0x35, 0x2e,
  0x30, 0x00, 0x00, 0x00, 0x0a, 0xf3, 0xff, 0xff, 0x04, 0x00, 0x00, 0x00,
  0x14, 0x00, 0x00, 0x00, 0x67, 0xf9, 0x89, 0x3d, 0x32, 0x45, 0x3f, 0x3d,
  0x88, 0x09, 0x8b, 0x3d, 0x33, 0xb6, 0xac, 0x3d, 0x6f, 0xe6, 0xbb, 0x3d,
  0x2a, 0xf3, 0xff, 0xff, 0x04, 0x00, 0x00, 0x00, 0xbc, 0x02, 0x00, 0x00,
  0x83, 0x91, 0x22, 0x3d, 0xbf, 0x42, 0x03, 0xbf, 0xf0, 0x17, 0xfc, 0xbc,
  0xb1, 0x43, 0xa3, 0xbe, 0x78, 0x7f, 0x2a, 0x3e, 0xd8, 0xd2, 0x0a, 0x3d,
  0x40, 0x85, 0x8d, 0xbd, 0x67, 0x86, 0xb6, 0x3d, 0x52, 0xd0, 0x3b, 0x3e,
  0x0e, 0xbd, 0x32, 0xbf, 0x7a, 0xc2, 0x00, 0xbe, 0xf2, 0xc4, 0xc2, 0xbe,
  0xd0, 0x48, 0x7b, 0xbe, 0x95, 0x23, 0x0f, 0xbf, 0xb0, 0x04, 0x39, 0x3e,
  0xa4, 0x25, 0xcb, 0x3e, 0x3c, 0x14, 0x0a, 0xbe, 0x8f, 0x42, 0xa5, 0x3d,
  0x45, 0x63, 0xeb, 0xbd, 0x1b, 0xae, 0xa7, 0xbe, 0x2f, 0x73, 0xa9, 0x3e,
  0x02, 0x49, 0x67, 0xbe, 0xad, 0xa3, 0xa7, 0xbe, 0xf4, 0xbd, 0xaa, 0x3e,
  0xf1, 0x09, 0xaa, 0xbd, 0xc5, 0x6d, 0x17, 0x3e, 0x94, 0x93, 0x14, 0x3e,
  0xf0, 0xc1, 0xa5, 0x3e, 0x01, 0xc0, 0x5f, 0x3e, 0x6b, 0xfd, 0x1e, 0x3e,
  0xac, 0x63, 0xb2, 0xbe, 0x48, 0xa0, 0xd7, 0x3e, 0x20, 0xce, 0xa8, 0xbd,
  0x9e, 0x75, 0xb4, 0x3e, 0x05, 0xbc, 0x94, 0xbe, 0xb5, 0xd6, 0xaa, 0xbe,
  0xc4, 0xe1, 0x19, 0xbe, 0x60, 0x07, 0x22, 0x3d, 0x3e, 0x91, 0x85, 0x3e,
  0xbb, 0x36, 0xe0, 0xbe, 0xa8, 0x9a, 0x5c, 0xbe, 0x9d, 0x7e, 0x47, 0xbe,
  0x47, 0x26, 0x81, 0xbe, 0x65, 0x90, 0xbf, 0xbe, 0x7b, 0xba, 0x1c, 0x3f,
  0xa0, 0xe7, 0x16, 0x3e, 0x0c, 0x15, 0x31, 0x3e, 0x13, 0x3a, 0xe2, 0x3d,
  0xeb, 0xea, 0x30, 0xbe, 0x78, 0xb4, 0xaa, 0xbe, 0x89, 0xf1, 0xbb, 0x3e,
  0x58, 0x35, 0xa1, 0x3d, 0xf3, 0xa4, 0xdf, 0x3d, 0x41, 0x18, 0x8a, 0x3e,
  0xf5, 0xce, 0x85, 0xbd, 0x6c, 0x37, 0xb1, 0x3e, 0xb6, 0xa4, 0xbc, 0x3e,
  0xdd, 0x6e, 0xfc, 0xbe, 0x67, 0x3a, 0xf4, 0x3d, 0x80, 0xa0, 0xb4, 0x3d,
  0x80, 0x74, 0x8d, 0x3c, 0x80, 0xd7, 0x10, 0xbc, 0xe8, 0x37, 0x26, 0xbe,
  0x6c, 0x84, 0xd9, 0xbe, 0x24, 0x5f, 0x83, 0xbe, 0xc6, 0xdd, 0x86, 0x3c,
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
 
};
