bialykostek/kontroler/Kontroler/babyDodoTFPPM/flight_model_14.h

#define TENSORFLOW_LITE_EXPERIMENTAL_MICRO_EXAMPLES_HELLO_WORLD_SINE_MODEL_DATA_H_
#ifdef __has_attribute
#define HAVE_ATTRIBUTE(x) __has_attribute(x)
#else
#define HAVE_ATTRIBUTE(x) 0
#endif
#if HAVE_ATTRIBUTE(aligned) || (defined(__GNUC__) && !defined(__clang__))
#define DATA_ALIGN_ATTRIBUTE __attribute__((aligned(4)))
#else
#define DATA_ALIGN_ATTRIBUTE
#endif

const int flight_model_len = 8008;
const unsigned char flight_model[] DATA_ALIGN_ATTRIBUTE = {
 0x1c, 0x00, 0x00, 0x00, 0x54, 0x46, 0x4c, 0x33, 0x00, 0x00, 0x12, 0x00,
  0x1c, 0x00, 0x04, 0x00, 0x08, 0x00, 0x0c, 0x00, 0x10, 0x00, 0x14, 0x00,
  0x00, 0x00, 0x18, 0x00, 0x12, 0x00, 0x00, 0x00, 0x03, 0x00, 0x00, 0x00,
  0xf4, 0x1e, 0x00, 0x00, 0xfc, 0x19, 0x00, 0x00, 0xe4, 0x19, 0x00, 0x00,
  0x34, 0x00, 0x00, 0x00, 0x04, 0x00, 0x00, 0x00, 0x01, 0x00, 0x00, 0x00,
  0x04, 0x00, 0x00, 0x00, 0xb0, 0xe1, 0xff, 0xff, 0x08, 0x00, 0x00, 0x00,
  0x0d, 0x00, 0x00, 0x00, 0x13, 0x00, 0x00, 0x00, 0x6d, 0x69, 0x6e, 0x5f,
  0x72, 0x75, 0x6e, 0x74, 0x69, 0x6d, 0x65, 0x5f, 0x76, 0x65, 0x72, 0x73,
  0x69, 0x6f, 0x6e, 0x00, 0x0e, 0x00, 0x00, 0x00, 0xa4, 0x19, 0x00, 0x00,
  0x9c, 0x19, 0x00, 0x00, 0x7c, 0x0b, 0x00, 0x00, 0x6c, 0x0b, 0x00, 0x00,
  0x60, 0x0b, 0x00, 0x00, 0x58, 0x0b, 0x00, 0x00, 0xf0, 0x08, 0x00, 0x00,
  0xe8, 0x08, 0x00, 0x00, 0xe0, 0x08, 0x00, 0x00, 0x50, 0x01, 0x00, 0x00,
  0xc8, 0x00, 0x00, 0x00, 0x40, 0x00, 0x00, 0x00, 0x1c, 0x00, 0x00, 0x00,
  0x04, 0x00, 0x00, 0x00, 0xba, 0xf4, 0xff, 0xff, 0x04, 0x00, 0x00, 0x00,
  0x06, 0x00, 0x00, 0x00, 0x31, 0x2e, 0x31, 0x34, 0x2e, 0x30, 0x00, 0x00,
  0xce, 0xf4, 0xff, 0xff, 0x04, 0x00, 0x00, 0x00, 0x14, 0x00, 0x00, 0x00,
  0x38, 0x2a, 0xe8, 0x3b, 0xf2, 0x3d, 0x53, 0x3d, 0xfe, 0x12, 0x0c, 0x3d,
  0xf4, 0xbb, 0x36, 0x3d, 0x78, 0x8d, 0x57, 0x3d, 0xee, 0xf4, 0xff, 0xff,
  0x04, 0x00, 0x00, 0x00, 0x78, 0x00, 0x00, 0x00, 0x81, 0x81, 0x5d, 0x3d,
  0xa4, 0x4f, 0x6a, 0xbd, 0x61, 0x1c, 0x59, 0x3d, 0xb9, 0xe0, 0x21, 0x3d,
  0x3f, 0x5a, 0x2a, 0x3d, 0x95, 0x1f, 0xb2, 0x3d, 0x75, 0x6e, 0x92, 0x3d,
  0x80, 0x84, 0xbd, 0x3d, 0x35, 0xb9, 0xf3, 0x3c, 0x80, 0xf9, 0x87, 0x3d,
  0xe8, 0xa7, 0x1d, 0xbd, 0x3e, 0x10, 0x5f, 0x3d, 0x32, 0x7f, 0x5a, 0xbd,
  0x98, 0xe6, 0x0f, 0x3d, 0xe0, 0x20, 0x84, 0x3d, 0xff, 0x2b, 0xbc, 0xbc,
  0x6a, 0xa8, 0x7b, 0x3d, 0xc8, 0xae, 0xb7, 0x3c, 0x36, 0x31, 0x7b, 0xbd,
  0xd1, 0x78, 0x87, 0x3c, 0x79, 0xd9, 0xa6, 0x3d, 0xaa, 0x20, 0x12, 0xbc,
  0xf3, 0x2c, 0xb6, 0xbc, 0x90, 0x6d, 0x9d, 0xbc, 0xb0, 0xbf, 0x58, 0xbc,
  0x26, 0xbf, 0x2c, 0x3c, 0x8e, 0xbc, 0x85, 0xbd, 0xe4, 0xe5, 0x5b, 0x3d,
  0x02, 0xed, 0x0e, 0xbd, 0x67, 0x3f, 0x13, 0x3d, 0x72, 0xf5, 0xff, 0xff,
  0x04, 0x00, 0x00, 0x00, 0x78, 0x00, 0x00, 0x00, 0xb9, 0xf8, 0xb0, 0x3b,
  0xae, 0x75, 0x6a, 0x3c, 0xd9, 0x43, 0xce, 0x3c, 0x18, 0x05, 0x5c, 0xbc,
  0x62, 0x15, 0xd1, 0xbb, 0x01, 0xcd, 0x56, 0xbd, 0xbd, 0xf6, 0x87, 0xbc,
  0x53, 0x7c, 0x47, 0xbd, 0xe7, 0x7c, 0x1a, 0x3d, 0xf2, 0xfa, 0x36, 0xbe,
  0x84, 0xfc, 0x3f, 0xbb, 0xfb, 0x1d, 0x22, 0x3b, 0x3c, 0x0d, 0x77, 0x3d,
  0xa2, 0x94, 0xcc, 0xbd, 0x22, 0xcc, 0x07, 0x3e, 0x0c, 0xfd, 0xe6, 0xbc,
  0x69, 0xa4, 0xde, 0xbd, 0x90, 0xbf, 0xc4, 0x3c, 0x4f, 0x45, 0x38, 0x3d,
  0xd8, 0x4e, 0x29, 0xbd, 0x68, 0x73, 0x56, 0x3d, 0x6d, 0xb1, 0x3b, 0xbd,
  0x7d, 0xc1, 0x6a, 0x3d, 0x3b, 0x3f, 0xd0, 0xbd, 0xbf, 0xd0, 0x67, 0x3d,
  0xb2, 0xfa, 0x88, 0xbb, 0xe5, 0xc2, 0x49, 0xbd, 0x29, 0x9b, 0x8c, 0x3c,
  0x21, 0x59, 0x38, 0x3d, 0xc9, 0xd5, 0x5f, 0xbc, 0xf6, 0xf5, 0xff, 0xff,
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
};
