bialykostek/kontroler/Kontroler/babyDodoTFPPM/flight_model_15.h

#define TENSORFLOW_LITE_EXPERIMENTAL_MICRO_EXAMPLES_HELLO_WORLD_SINE_MODEL_DATA_H_
#ifdef __has_attribute
#define HAVE_ATTRIBUTE(x) __has_attribute(x)
#else
#define HAVE_ATTRIBUTE(x) 0
#endif
#if HAVE_ATTRIBUTE(aligned) || (defined(__GNUC__) && !defined(__clang__))
#define DATA_ALIGN_ATTRIBUTE __attribute__((aligned(4)))
#else
#define DATA_ALIGN_ATTRIBUTE
#endif

const int flight_model_len = 7780;
const unsigned char flight_model[] DATA_ALIGN_ATTRIBUTE = {
 0x1c, 0x00, 0x00, 0x00, 0x54, 0x46, 0x4c, 0x33, 0x00, 0x00, 0x12, 0x00,
  0x1c, 0x00, 0x04, 0x00, 0x08, 0x00, 0x0c, 0x00, 0x10, 0x00, 0x14, 0x00,
  0x00, 0x00, 0x18, 0x00, 0x12, 0x00, 0x00, 0x00, 0x03, 0x00, 0x00, 0x00,
  0x20, 0x1e, 0x00, 0x00, 0xec, 0x19, 0x00, 0x00, 0xd4, 0x19, 0x00, 0x00,
  0x34, 0x00, 0x00, 0x00, 0x04, 0x00, 0x00, 0x00, 0x01, 0x00, 0x00, 0x00,
  0x04, 0x00, 0x00, 0x00, 0x84, 0xe2, 0xff, 0xff, 0x08, 0x00, 0x00, 0x00,
  0x0b, 0x00, 0x00, 0x00, 0x13, 0x00, 0x00, 0x00, 0x6d, 0x69, 0x6e, 0x5f,
  0x72, 0x75, 0x6e, 0x74, 0x69, 0x6d, 0x65, 0x5f, 0x76, 0x65, 0x72, 0x73,
  0x69, 0x6f, 0x6e, 0x00, 0x0c, 0x00, 0x00, 0x00, 0x94, 0x19, 0x00, 0x00,
  0x8c, 0x19, 0x00, 0x00, 0x6c, 0x0b, 0x00, 0x00, 0x5c, 0x0b, 0x00, 0x00,
  0x50, 0x0b, 0x00, 0x00, 0x48, 0x0b, 0x00, 0x00, 0xb8, 0x03, 0x00, 0x00,
  0x30, 0x03, 0x00, 0x00, 0xa8, 0x02, 0x00, 0x00, 0x40, 0x00, 0x00, 0x00,
  0x1c, 0x00, 0x00, 0x00, 0x04, 0x00, 0x00, 0x00, 0xc2, 0xf4, 0xff, 0xff,
  0x04, 0x00, 0x00, 0x00, 0x05, 0x00, 0x00, 0x00, 0x31, 0x2e, 0x35, 0x2e,
  0x30, 0x00, 0x00, 0x00, 0xd6, 0xf4, 0xff, 0xff, 0x04, 0x00, 0x00, 0x00,
  0x14, 0x00, 0x00, 0x00, 0x3c, 0x92, 0x0b, 0x3e, 0x96, 0xfe, 0xe7, 0x3d,
  0x84, 0xe1, 0xe0, 0x3d, 0xd7, 0x75, 0xe4, 0x3d, 0x9a, 0x7c, 0x8c, 0x3d,
  0xf6, 0xf4, 0xff, 0xff, 0x04, 0x00, 0x00, 0x00, 0x58, 0x02, 0x00, 0x00,
  0xa5, 0xc7, 0xa5, 0x3e, 0xc1, 0x6b, 0xdf, 0x3e, 0x10, 0x08, 0xdf, 0x3b,
  0xd6, 0xad, 0xbc, 0x3c, 0xf2, 0xe7, 0xd1, 0x3e, 0xc9, 0xac, 0x85, 0x3e,
  0x4f, 0xae, 0xdf, 0xbc, 0x91, 0x0f, 0xd1, 0x3e, 0x98, 0x1c, 0x88, 0xbe,
  0x7e, 0x07, 0xf2, 0x3d, 0x06, 0x91, 0xe6, 0x3d, 0x74, 0x8d, 0xb6, 0x3e,
  0x6e, 0x94, 0x06, 0xbd, 0x61, 0x2a, 0xf3, 0xbd, 0x21, 0x1c, 0xb1, 0x3e,
  0xf3, 0xbd, 0x9e, 0xbb, 0x68, 0xbd, 0xaf, 0xbe, 0x53, 0x9d, 0x9d, 0xbe,
  0x59, 0xe4, 0xf3, 0xbb, 0x20, 0x18, 0xd7, 0xbc, 0xef, 0xbc, 0xd0, 0xbe,
  0xf9, 0x28, 0xaa, 0xbc, 0x0e, 0x10, 0x18, 0x3e, 0xe4, 0x12, 0x4e, 0xbe,
  0xd8, 0xd9, 0x96, 0x3c, 0x55, 0x2a, 0xba, 0x3e, 0x46, 0x3a, 0xb6, 0x3e,
  0x85, 0xf4, 0xa9, 0x3e, 0x0d, 0xd0, 0xd6, 0xbe, 0x82, 0x78, 0xd5, 0x3a,
  0xbc, 0x73, 0xe9, 0xbd, 0x8d, 0x8e, 0xba, 0xbe, 0x53, 0x6b, 0xaf, 0x3d,
  0x40, 0xc0, 0x82, 0x3e, 0x21, 0x15, 0x48, 0x3d, 0x88, 0x9d, 0xc9, 0x3d,
  0xf7, 0x9d, 0x17, 0x3e, 0xa0, 0xc9, 0x8e, 0xbd, 0x4c, 0x56, 0xf5, 0x3e,
  0x0e, 0x73, 0xeb, 0xbd, 0x56, 0x7f, 0x0f, 0xbf, 0x45, 0xcd, 0x69, 0xbe,
  0xca, 0x79, 0xb0, 0xbe, 0xd9, 0x85, 0xee, 0x3e, 0x2d, 0xda, 0x0a, 0x3e,
  0x75, 0x65, 0xbe, 0x3d, 0xbf, 0xc6, 0xb0, 0x3e, 0xf5, 0xc3, 0x51, 0xbd,
  0x57, 0x5c, 0x65, 0x3d, 0x29, 0x52, 0x93, 0x3e, 0x49, 0x73, 0x10, 0xbe,
  0x8c, 0x6a, 0xab, 0x3d, 0x46, 0x42, 0xaa, 0xbe, 0x02, 0x38, 0x11, 0xbf,
  0xfa, 0xe6, 0x3f, 0xbd, 0x90, 0x75, 0x1b, 0xbe, 0xfb, 0x36, 0x77, 0x3d,
  0x1c, 0x5e, 0xce, 0x3e, 0x35, 0x5f, 0x94, 0xbe, 0x3d, 0x9c, 0xa5, 0xbd,
  0x5f, 0x38, 0xb5, 0x3e, 0x8e, 0x8c, 0x7e, 0x3e, 0xab, 0xe8, 0xab, 0xbe,
  0xd1, 0x31, 0x44, 0x3e, 0xc9, 0xf7, 0x7e, 0x3e, 0x4b, 0xbf, 0x2d, 0xbe,
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
};
