bialykostek/kontroler/Kontroler/babyDodoTFPPM/flight_model_16.h

#define TENSORFLOW_LITE_EXPERIMENTAL_MICRO_EXAMPLES_HELLO_WORLD_SINE_MODEL_DATA_H_
#ifdef __has_attribute
#define HAVE_ATTRIBUTE(x) __has_attribute(x)
#else
#define HAVE_ATTRIBUTE(x) 0
#endif
#if HAVE_ATTRIBUTE(aligned) || (defined(__GNUC__) && !defined(__clang__))
#define DATA_ALIGN_ATTRIBUTE __attribute__((aligned(4)))
#else
#define DATA_ALIGN_ATTRIBUTE
#endif

const int flight_model_len = 23984;
const unsigned char flight_model[] DATA_ALIGN_ATTRIBUTE = {
 0x1c, 0x00, 0x00, 0x00, 0x54, 0x46, 0x4c, 0x33, 0x00, 0x00, 0x12, 0x00,
  0x1c, 0x00, 0x04, 0x00, 0x08, 0x00, 0x0c, 0x00, 0x10, 0x00, 0x14, 0x00,
  0x00, 0x00, 0x18, 0x00, 0x12, 0x00, 0x00, 0x00, 0x03, 0x00, 0x00, 0x00,
  0x6c, 0x5d, 0x00, 0x00, 0xa8, 0x54, 0x00, 0x00, 0x90, 0x54, 0x00, 0x00,
  0x34, 0x00, 0x00, 0x00, 0x04, 0x00, 0x00, 0x00, 0x01, 0x00, 0x00, 0x00,
  0x04, 0x00, 0x00, 0x00, 0x38, 0xa3, 0xff, 0xff, 0x08, 0x00, 0x00, 0x00,
  0x17, 0x00, 0x00, 0x00, 0x13, 0x00, 0x00, 0x00, 0x6d, 0x69, 0x6e, 0x5f,
  0x72, 0x75, 0x6e, 0x74, 0x69, 0x6d, 0x65, 0x5f, 0x76, 0x65, 0x72, 0x73,
  0x69, 0x6f, 0x6e, 0x00, 0x18, 0x00, 0x00, 0x00, 0x50, 0x54, 0x00, 0x00,
  0x48, 0x54, 0x00, 0x00, 0x28, 0x46, 0x00, 0x00, 0x00, 0x38, 0x00, 0x00,
  0xf8, 0x37, 0x00, 0x00, 0x70, 0x37, 0x00, 0x00, 0x68, 0x37, 0x00, 0x00,
  0xe0, 0x36, 0x00, 0x00, 0xd8, 0x36, 0x00, 0x00, 0xd0, 0x36, 0x00, 0x00,
  0xc8, 0x36, 0x00, 0x00, 0xc0, 0x36, 0x00, 0x00, 0xb8, 0x36, 0x00, 0x00,
  0x28, 0x2f, 0x00, 0x00, 0xa0, 0x2e, 0x00, 0x00, 0x18, 0x2e, 0x00, 0x00,
  0xf8, 0x1f, 0x00, 0x00, 0x70, 0x1f, 0x00, 0x00, 0x50, 0x11, 0x00, 0x00,
  0xc8, 0x10, 0x00, 0x00, 0xa8, 0x02, 0x00, 0x00, 0x40, 0x00, 0x00, 0x00,
  0x1c, 0x00, 0x00, 0x00, 0x04, 0x00, 0x00, 0x00, 0x36, 0xba, 0xff, 0xff,
  0x04, 0x00, 0x00, 0x00, 0x05, 0x00, 0x00, 0x00, 0x31, 0x2e, 0x35, 0x2e,
  0x30, 0x00, 0x00, 0x00, 0x4a, 0xba, 0xff, 0xff, 0x04, 0x00, 0x00, 0x00,
  0x14, 0x00, 0x00, 0x00, 0x2e, 0x16, 0x4f, 0x3e, 0x36, 0xf9, 0x2b, 0x3e,
  0xb2, 0xad, 0x67, 0x3d, 0x80, 0x12, 0x73, 0x3e, 0xb7, 0xe7, 0x13, 0x3e,
  0x6a, 0xba, 0xff, 0xff, 0x04, 0x00, 0x00, 0x00, 0x58, 0x02, 0x00, 0x00,
  0x7b, 0xcc, 0x94, 0xbe, 0x74, 0x29, 0x78, 0xbe, 0xd0, 0x35, 0xbf, 0x3e,
  0xd2, 0xfa, 0x30, 0xbe, 0x25, 0x8a, 0xb2, 0xbe, 0x87, 0xd1, 0x68, 0xbe,
  0x28, 0x51, 0xc9, 0xbe, 0xd9, 0xf9, 0x24, 0x3c, 0x1d, 0xce, 0xc8, 0x3e,
  0x9b, 0xf2, 0x2b, 0x3e, 0x6e, 0x1d, 0x77, 0x3d, 0xe6, 0x07, 0x86, 0xbe,
  0x1d, 0x02, 0x37, 0x3d, 0x67, 0x46, 0x09, 0xbe, 0x0f, 0xd6, 0x2e, 0xbd,
  0x0a, 0xf1, 0x1d, 0xbe, 0x49, 0x3f, 0xae, 0xbe, 0x8c, 0xe2, 0x86, 0x3c,
  0xbb, 0x58, 0x4a, 0xbe, 0x4d, 0x09, 0xbe, 0x3e, 0x37, 0x80, 0x14, 0xbe,
  0xf2, 0xb1, 0x08, 0x3f, 0xd7, 0x1b, 0x1a, 0xbe, 0x3a, 0x80, 0xb1, 0x3e,
  0x91, 0x74, 0xad, 0xbb, 0xd8, 0x8e, 0x3d, 0xbe, 0x8b, 0xed, 0xba, 0x3e,
  0x00, 0x09, 0x9f, 0xbd, 0x3b, 0x28, 0xf1, 0xbe, 0xbd, 0x1d, 0x41, 0x3e,
  0xe1, 0x62, 0xc3, 0x3e, 0x96, 0x65, 0x66, 0xbe, 0x79, 0xbd, 0x0d, 0xbe,
  0x02, 0x25, 0x88, 0xbe, 0x56, 0x72, 0x52, 0xbe, 0x20, 0xc6, 0xe3, 0x3d,
  0x8d, 0x10, 0xcd, 0x3e, 0x71, 0x6e, 0xbd, 0x3e, 0x84, 0x12, 0x48, 0x3e,
  0x06, 0x08, 0xe6, 0x3e, 0x93, 0x23, 0x9c, 0xbe, 0xdb, 0x41, 0xe9, 0x3c,
  0x8a, 0xe4, 0x1e, 0xbe, 0xde, 0xaf, 0x1d, 0xbe, 0x0c, 0xa0, 0xb6, 0xbb,
  0x05, 0x94, 0xc9, 0xbe, 0x91, 0xf5, 0x9f, 0xbe, 0xd5, 0x4f, 0xf1, 0x3e,
  0x17, 0xd0, 0xef, 0x3d, 0x73, 0xbe, 0xb9, 0xbd, 0x53, 0xd8, 0x5b, 0x3e,
  0x52, 0x02, 0xa4, 0x3d, 0xf8, 0xc8, 0xb0, 0xbe, 0xbb, 0xd8, 0xb6, 0xbd,
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
};
