bialykostek/kontroler/Kontroler/babyDodoTFPPM/flight_model_17.h

#define TENSORFLOW_LITE_EXPERIMENTAL_MICRO_EXAMPLES_HELLO_WORLD_SINE_MODEL_DATA_H_
#ifdef __has_attribute
#define HAVE_ATTRIBUTE(x) __has_attribute(x)
#else
#define HAVE_ATTRIBUTE(x) 0
#endif
#if HAVE_ATTRIBUTE(aligned) || (defined(__GNUC__) && !defined(__clang__))
#define DATA_ALIGN_ATTRIBUTE __attribute__((aligned(4)))
#else
#define DATA_ALIGN_ATTRIBUTE
#endif

const int flight_model_len = 24584;
const unsigned char flight_model[] DATA_ALIGN_ATTRIBUTE = {
 0x1c, 0x00, 0x00, 0x00, 0x54, 0x46, 0x4c, 0x33, 0x00, 0x00, 0x12, 0x00,
  0x1c, 0x00, 0x04, 0x00, 0x08, 0x00, 0x0c, 0x00, 0x10, 0x00, 0x14, 0x00,
  0x00, 0x00, 0x18, 0x00, 0x12, 0x00, 0x00, 0x00, 0x03, 0x00, 0x00, 0x00,
  0xc4, 0x5f, 0x00, 0x00, 0x00, 0x57, 0x00, 0x00, 0xe8, 0x56, 0x00, 0x00,
  0x34, 0x00, 0x00, 0x00, 0x04, 0x00, 0x00, 0x00, 0x01, 0x00, 0x00, 0x00,
  0x04, 0x00, 0x00, 0x00, 0xe0, 0xa0, 0xff, 0xff, 0x08, 0x00, 0x00, 0x00,
  0x17, 0x00, 0x00, 0x00, 0x13, 0x00, 0x00, 0x00, 0x6d, 0x69, 0x6e, 0x5f,
  0x72, 0x75, 0x6e, 0x74, 0x69, 0x6d, 0x65, 0x5f, 0x76, 0x65, 0x72, 0x73,
  0x69, 0x6f, 0x6e, 0x00, 0x18, 0x00, 0x00, 0x00, 0xa8, 0x56, 0x00, 0x00,
  0xa0, 0x56, 0x00, 0x00, 0x80, 0x48, 0x00, 0x00, 0x58, 0x3a, 0x00, 0x00,
  0x50, 0x3a, 0x00, 0x00, 0xc8, 0x39, 0x00, 0x00, 0xc0, 0x39, 0x00, 0x00,
  0x38, 0x39, 0x00, 0x00, 0x30, 0x39, 0x00, 0x00, 0x28, 0x39, 0x00, 0x00,
  0x20, 0x39, 0x00, 0x00, 0x18, 0x39, 0x00, 0x00, 0x10, 0x39, 0x00, 0x00,
  0x28, 0x2f, 0x00, 0x00, 0xa0, 0x2e, 0x00, 0x00, 0x18, 0x2e, 0x00, 0x00,
  0xf8, 0x1f, 0x00, 0x00, 0x70, 0x1f, 0x00, 0x00, 0x50, 0x11, 0x00, 0x00,
  0xc8, 0x10, 0x00, 0x00, 0xa8, 0x02, 0x00, 0x00, 0x40, 0x00, 0x00, 0x00,
  0x1c, 0x00, 0x00, 0x00, 0x04, 0x00, 0x00, 0x00, 0xde, 0xb7, 0xff, 0xff,
  0x04, 0x00, 0x00, 0x00, 0x05, 0x00, 0x00, 0x00, 0x31, 0x2e, 0x35, 0x2e,
  0x30, 0x00, 0x00, 0x00, 0xf2, 0xb7, 0xff, 0xff, 0x04, 0x00, 0x00, 0x00,
  0x14, 0x00, 0x00, 0x00, 0x44, 0x56, 0x76, 0x3d, 0x0a, 0xff, 0x39, 0x3d,
  0x45, 0x9a, 0x12, 0x3d, 0x02, 0x95, 0x1c, 0x3e, 0xc5, 0xe4, 0x38, 0x3d,
  0x12, 0xb8, 0xff, 0xff, 0x04, 0x00, 0x00, 0x00, 0x58, 0x02, 0x00, 0x00,
  0x60, 0xa0, 0xb5, 0xbe, 0x71, 0x22, 0xa2, 0x3e, 0xbe, 0xf3, 0x6d, 0x3e,
  0x37, 0x00, 0xa8, 0x3e, 0x00, 0x60, 0x6a, 0xb8, 0x09, 0xb9, 0x88, 0xba,
  0xf4, 0xa5, 0x28, 0xbe, 0x67, 0xbe, 0x5e, 0xbe, 0xe4, 0xac, 0x50, 0x3e,
  0x3d, 0x51, 0xe9, 0x3e, 0x4c, 0x9a, 0xe3, 0x3d, 0xc9, 0xb8, 0xce, 0x3e,
  0xb1, 0x72, 0x3b, 0xbe, 0xbc, 0x54, 0xb5, 0x3b, 0xd2, 0x61, 0xe9, 0xbc,
  0xb3, 0x44, 0xac, 0x3e, 0x8e, 0xdc, 0xd8, 0xb8, 0x12, 0x44, 0x8a, 0xbd,
  0xa8, 0xb1, 0x75, 0x3d, 0x68, 0x8d, 0x88, 0xbe, 0xd6, 0x8f, 0x6c, 0x3e,
  0xbf, 0x01, 0xf4, 0xbd, 0xaa, 0x74, 0xf3, 0xbd, 0x35, 0x37, 0xae, 0xbe,
  0xf3, 0x72, 0x64, 0xbe, 0x0e, 0xd4, 0x0b, 0xbc, 0xad, 0x3d, 0x98, 0xbe,
  0x9e, 0xcb, 0x32, 0x3e, 0xf3, 0xf7, 0x8a, 0x3d, 0x59, 0x64, 0x8a, 0x3e,
  0xbc, 0xbb, 0x7b, 0xbd, 0x97, 0xc3, 0xcc, 0x3e, 0x9d, 0xcd, 0xdc, 0x3e,
  0xaa, 0xca, 0xba, 0x3e, 0x20, 0x53, 0x4d, 0x3d, 0x17, 0x5f, 0xc4, 0x3e,
  0xc4, 0x27, 0xe3, 0x3d, 0xdc, 0x0b, 0xdf, 0xbd, 0x9e, 0x6b, 0x76, 0xbd,
  0x88, 0xa0, 0x37, 0xbe, 0x85, 0x5b, 0x8c, 0xbe, 0x2a, 0xa1, 0xac, 0xbe,
  0x93, 0xf1, 0x50, 0xbe, 0x57, 0x8b, 0xaf, 0x3e, 0xa0, 0x89, 0xb5, 0xbd,
  0xcd, 0xfa, 0x9e, 0x3d, 0xf3, 0x06, 0x6c, 0x3e, 0xbf, 0xd2, 0x0d, 0xbb,
  0x00, 0x03, 0x9d, 0x3b, 0x4a, 0x89, 0x60, 0xbe, 0x79, 0xba, 0x7e, 0x3d,
  0x28, 0x42, 0x89, 0xbd, 0x13, 0x78, 0x17, 0xbe, 0xc5, 0x45, 0x9f, 0x3e,
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
};
