bialykostek/kontroler/Kontroler/babyDodoTFPPM/flight_model_4.h

#define TENSORFLOW_LITE_EXPERIMENTAL_MICRO_EXAMPLES_HELLO_WORLD_SINE_MODEL_DATA_H_
#ifdef __has_attribute
#define HAVE_ATTRIBUTE(x) __has_attribute(x)
#else
#define HAVE_ATTRIBUTE(x) 0
#endif
#if HAVE_ATTRIBUTE(aligned) || (defined(__GNUC__) && !defined(__clang__))
#define DATA_ALIGN_ATTRIBUTE __attribute__((aligned(4)))
#else
#define DATA_ALIGN_ATTRIBUTE
#endif

const int flight_model_len = 24184;
const unsigned char flight_model[] DATA_ALIGN_ATTRIBUTE = {
 0x20, 0x00, 0x00, 0x00, 0x54, 0x46, 0x4c, 0x33, 0x00, 0x00, 0x00, 0x00,
  0x00, 0x00, 0x12, 0x00, 0x1c, 0x00, 0x04, 0x00, 0x08, 0x00, 0x0c, 0x00,
  0x10, 0x00, 0x14, 0x00, 0x00, 0x00, 0x18, 0x00, 0x12, 0x00, 0x00, 0x00,
  0x03, 0x00, 0x00, 0x00, 0x30, 0x5e, 0x00, 0x00, 0xcc, 0x54, 0x00, 0x00,
  0xb4, 0x54, 0x00, 0x00, 0x34, 0x00, 0x00, 0x00, 0x04, 0x00, 0x00, 0x00,
  0x01, 0x00, 0x00, 0x00, 0x04, 0x00, 0x00, 0x00, 0x74, 0xa2, 0xff, 0xff,
  0x08, 0x00, 0x00, 0x00, 0x17, 0x00, 0x00, 0x00, 0x13, 0x00, 0x00, 0x00,
  0x6d, 0x69, 0x6e, 0x5f, 0x72, 0x75, 0x6e, 0x74, 0x69, 0x6d, 0x65, 0x5f,
  0x76, 0x65, 0x72, 0x73, 0x69, 0x6f, 0x6e, 0x00, 0x18, 0x00, 0x00, 0x00,
  0x74, 0x54, 0x00, 0x00, 0x6c, 0x54, 0x00, 0x00, 0x1c, 0x4e, 0x00, 0x00,
  0x24, 0x49, 0x00, 0x00, 0x1c, 0x49, 0x00, 0x00, 0x7c, 0x47, 0x00, 0x00,
  0x74, 0x47, 0x00, 0x00, 0x00, 0x47, 0x00, 0x00, 0xf8, 0x46, 0x00, 0x00,
  0xf0, 0x46, 0x00, 0x00, 0xe8, 0x46, 0x00, 0x00, 0xe0, 0x46, 0x00, 0x00,
  0xd8, 0x46, 0x00, 0x00, 0xc8, 0x42, 0x00, 0x00, 0x78, 0x42, 0x00, 0x00,
  0xd8, 0x40, 0x00, 0x00, 0xb8, 0x19, 0x00, 0x00, 0x80, 0x19, 0x00, 0x00,
  0xe8, 0x05, 0x00, 0x00, 0x10, 0x05, 0x00, 0x00, 0x18, 0x01, 0x00, 0x00,
  0x40, 0x00, 0x00, 0x00, 0x1c, 0x00, 0x00, 0x00, 0x04, 0x00, 0x00, 0x00,
  0x42, 0xb2, 0xff, 0xff, 0x04, 0x00, 0x00, 0x00, 0x05, 0x00, 0x00, 0x00,
  0x31, 0x2e, 0x35, 0x2e, 0x30, 0x00, 0x00, 0x00, 0x56, 0xb2, 0xff, 0xff,
  0x04, 0x00, 0x00, 0x00, 0x14, 0x00, 0x00, 0x00, 0x82, 0x35, 0xa9, 0x3c,
  0x59, 0x76, 0xb6, 0x3d, 0xc8, 0xa5, 0x97, 0x3d, 0x1c, 0x96, 0x02, 0x3f,
  0x37, 0x56, 0xa9, 0xbc, 0x76, 0xb2, 0xff, 0xff, 0x04, 0x00, 0x00, 0x00,
  0xc8, 0x00, 0x00, 0x00, 0x5e, 0x18, 0xfb, 0x3e, 0xb3, 0xa2, 0x58, 0x3e,
  0x30, 0x53, 0x05, 0xbf, 0x17, 0x82, 0xa4, 0x3e, 0x37, 0x4c, 0xa6, 0xbe,
  0x43, 0xdf, 0x6b, 0x3e, 0x9f, 0xf7, 0x05, 0x3f, 0xa1, 0x9f, 0xa2, 0xbe,
  0x9d, 0x92, 0x09, 0xbf, 0x07, 0x1d, 0xed, 0x3e, 0x20, 0x68, 0xf9, 0xbe,
  0xb3, 0x69, 0x47, 0xbe, 0x23, 0xda, 0x11, 0xbf, 0x0c, 0x68, 0x10, 0x3f,
  0x00, 0x94, 0x85, 0xbe, 0xd1, 0x61, 0xcf, 0x3e, 0x4c, 0x86, 0x04, 0xbf,
  0x35, 0xe8, 0x3c, 0xbe, 0xf0, 0x3e, 0x92, 0xbe, 0x81, 0x64, 0x96, 0xbe,
  0x20, 0x0b, 0x16, 0x3e, 0xad, 0x2c, 0x63, 0xbe, 0x36, 0xd0, 0xcb, 0xbe,
  0x6d, 0x2f, 0x6b, 0xbe, 0x2e, 0x45, 0x9f, 0xbc, 0xee, 0x6e, 0x33, 0x3f,
  0x90, 0xc1, 0x6b, 0xbe, 0x78, 0xa1, 0xdd, 0xbd, 0x2e, 0x7c, 0xe5, 0xbe,
  0x98, 0xee, 0x89, 0x3c, 0x4e, 0xc6, 0xd6, 0xbe, 0xef, 0x93, 0xe2, 0xbe,
  0x34, 0xdf, 0x51, 0xbe, 0xc3, 0x5e, 0x73, 0x3e, 0x8f, 0x7b, 0x06, 0x3f,
  0xb2, 0x6d, 0xec, 0xbd, 0x6f, 0x9c, 0x0f, 0xbe, 0x38, 0x24, 0x18, 0xbf,
  0x5d, 0x95, 0xef, 0xbe, 0x98, 0x2b, 0xa4, 0xbd, 0x56, 0x15, 0x7d, 0xbe,
  0x69, 0xbb, 0xea, 0x3e, 0xe8, 0xd1, 0xac, 0xbe, 0x8f, 0xcc, 0x14, 0x3f,
  0xc2, 0xcd, 0x07, 0x3f, 0x46, 0x55, 0xe2, 0x3d, 0xa8, 0xcc, 0x43, 0x3f,
  0xe5, 0x7c, 0x0d, 0x3e, 0x96, 0x1e, 0xec, 0x3e, 0x34, 0xf4, 0xce, 0xbe,
  0x4a, 0xb3, 0xff, 0xff, 0x04, 0x00, 0x00, 0x00, 0xe8, 0x03, 0x00, 0x00,
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
};
