bialykostek/kontroler/Kontroler/babyDodoTFPPM/flight_model_5.h

#define TENSORFLOW_LITE_EXPERIMENTAL_MICRO_EXAMPLES_HELLO_WORLD_SINE_MODEL_DATA_H_
#ifdef __has_attribute
#define HAVE_ATTRIBUTE(x) __has_attribute(x)
#else
#define HAVE_ATTRIBUTE(x) 0
#endif
#if HAVE_ATTRIBUTE(aligned) || (defined(__GNUC__) && !defined(__clang__))
#define DATA_ALIGN_ATTRIBUTE __attribute__((aligned(4)))
#else
#define DATA_ALIGN_ATTRIBUTE
#endif

const int flight_model_len = 15296;
const unsigned char flight_model[] DATA_ALIGN_ATTRIBUTE = {
 0x1c, 0x00, 0x00, 0x00, 0x54, 0x46, 0x4c, 0x33, 0x00, 0x00, 0x12, 0x00,
  0x1c, 0x00, 0x04, 0x00, 0x08, 0x00, 0x0c, 0x00, 0x10, 0x00, 0x14, 0x00,
  0x00, 0x00, 0x18, 0x00, 0x12, 0x00, 0x00, 0x00, 0x03, 0x00, 0x00, 0x00,
  0x7c, 0x3b, 0x00, 0x00, 0x70, 0x30, 0x00, 0x00, 0x58, 0x30, 0x00, 0x00,
  0x34, 0x00, 0x00, 0x00, 0x04, 0x00, 0x00, 0x00, 0x01, 0x00, 0x00, 0x00,
  0x04, 0x00, 0x00, 0x00, 0x28, 0xc5, 0xff, 0xff, 0x08, 0x00, 0x00, 0x00,
  0x1d, 0x00, 0x00, 0x00, 0x13, 0x00, 0x00, 0x00, 0x6d, 0x69, 0x6e, 0x5f,
  0x72, 0x75, 0x6e, 0x74, 0x69, 0x6d, 0x65, 0x5f, 0x76, 0x65, 0x72, 0x73,
  0x69, 0x6f, 0x6e, 0x00, 0x1e, 0x00, 0x00, 0x00, 0x18, 0x30, 0x00, 0x00,
  0x10, 0x30, 0x00, 0x00, 0x00, 0x2b, 0x00, 0x00, 0xa8, 0x24, 0x00, 0x00,
  0xa0, 0x24, 0x00, 0x00, 0x40, 0x24, 0x00, 0x00, 0x38, 0x24, 0x00, 0x00,
  0xd8, 0x23, 0x00, 0x00, 0x78, 0x23, 0x00, 0x00, 0x18, 0x23, 0x00, 0x00,
  0x10, 0x23, 0x00, 0x00, 0x08, 0x23, 0x00, 0x00, 0x00, 0x23, 0x00, 0x00,
  0xf8, 0x22, 0x00, 0x00, 0xf0, 0x22, 0x00, 0x00, 0xb8, 0x22, 0x00, 0x00,
  0xb0, 0x22, 0x00, 0x00, 0xa0, 0x1e, 0x00, 0x00, 0x98, 0x1e, 0x00, 0x00,
  0x48, 0x1e, 0x00, 0x00, 0xf8, 0x17, 0x00, 0x00, 0x98, 0x17, 0x00, 0x00,
  0x48, 0x11, 0x00, 0x00, 0xe8, 0x10, 0x00, 0x00, 0x98, 0x0a, 0x00, 0x00,
  0x48, 0x04, 0x00, 0x00, 0x18, 0x01, 0x00, 0x00, 0x40, 0x00, 0x00, 0x00,
  0x1c, 0x00, 0x00, 0x00, 0x04, 0x00, 0x00, 0x00, 0x76, 0xd5, 0xff, 0xff,
  0x04, 0x00, 0x00, 0x00, 0x05, 0x00, 0x00, 0x00, 0x31, 0x2e, 0x35, 0x2e,
  0x30, 0x00, 0x00, 0x00, 0x8a, 0xd5, 0xff, 0xff, 0x04, 0x00, 0x00, 0x00,
  0x14, 0x00, 0x00, 0x00, 0x6e, 0x11, 0x23, 0x3f, 0xd6, 0x3c, 0xee, 0xbd,
  0xc4, 0x6d, 0x10, 0xbe, 0xab, 0x65, 0x05, 0x3f, 0xd1, 0xbc, 0xa2, 0x3d,
  0xaa, 0xd5, 0xff, 0xff, 0x04, 0x00, 0x00, 0x00, 0xc8, 0x00, 0x00, 0x00,
  0x3c, 0x78, 0x01, 0xbe, 0x18, 0xc4, 0xbd, 0x3d, 0x55, 0x44, 0x68, 0x3e,
  0x38, 0x4f, 0xcb, 0xbd, 0x95, 0x40, 0x8e, 0xbe, 0x05, 0x90, 0x8b, 0x3e,
  0x02, 0xc2, 0xe9, 0x3e, 0x9c, 0x03, 0x50, 0x3e, 0xc3, 0x64, 0xb5, 0x3e,
  0xc0, 0x70, 0x9f, 0x3c, 0x30, 0xdc, 0xe8, 0x3d, 0x01, 0xb2, 0x0f, 0x3f,
  0xca, 0x97, 0xc0, 0xbd, 0x60, 0x55, 0x81, 0x3d, 0x04, 0x50, 0x39, 0x3f,
  0xde, 0xae, 0x1f, 0xbf, 0xda, 0x75, 0x2d, 0xbe, 0xf4, 0x4b, 0x24, 0x3e,
  0x75, 0x86, 0x85, 0xbe, 0x12, 0x2b, 0xd2, 0xbe, 0x74, 0x75, 0x0d, 0xbe,
  0xfe, 0xcb, 0xda, 0xbe, 0xee, 0xee, 0x39, 0x3e, 0x58, 0x91, 0xf4, 0xbe,
  0x0c, 0xf0, 0xb1, 0x3e, 0x2c, 0xba, 0xf3, 0x3d, 0xab, 0xa7, 0x0a, 0xbf,
  0x5a, 0xaf, 0xdb, 0x3e, 0x7e, 0xe4, 0x02, 0xbf, 0x24, 0x72, 0x0e, 0xbf,
  0x40, 0x7c, 0xf7, 0xbc, 0xf9, 0xa4, 0xe5, 0xbe, 0xbb, 0x97, 0xde, 0xbd,
  0x6c, 0x82, 0xb1, 0xbe, 0xa2, 0xbb, 0xd8, 0x3d, 0xc5, 0x2e, 0x56, 0xbe,
  0x94, 0x1e, 0x16, 0xbf, 0x38, 0xc1, 0x95, 0x3e, 0x86, 0x16, 0xa0, 0xbe,
  0xc7, 0x6c, 0x08, 0xbf, 0x5a, 0xa6, 0xe4, 0xbe, 0xdc, 0x52, 0x81, 0xbe,
  0xb4, 0x22, 0x34, 0x3f, 0x80, 0x0c, 0x3f, 0x3e, 0xa1, 0x75, 0xed, 0xbe,
  0x8d, 0xab, 0xa9, 0xbe, 0xf5, 0x45, 0xb0, 0xbe, 0x98, 0xe7, 0xec, 0x3d,
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
};
