bialykostek/kontroler/Kontroler/babyDodoTFPPM/flight_model_6.h

#define TENSORFLOW_LITE_EXPERIMENTAL_MICRO_EXAMPLES_HELLO_WORLD_SINE_MODEL_DATA_H_
#ifdef __has_attribute
#define HAVE_ATTRIBUTE(x) __has_attribute(x)
#else
#define HAVE_ATTRIBUTE(x) 0
#endif
#if HAVE_ATTRIBUTE(aligned) || (defined(__GNUC__) && !defined(__clang__))
#define DATA_ALIGN_ATTRIBUTE __attribute__((aligned(4)))
#else
#define DATA_ALIGN_ATTRIBUTE
#endif

const int flight_model_len = 17848;
const unsigned char flight_model[] DATA_ALIGN_ATTRIBUTE = {
 0x1c, 0x00, 0x00, 0x00, 0x54, 0x46, 0x4c, 0x33, 0x00, 0x00, 0x12, 0x00,
  0x1c, 0x00, 0x04, 0x00, 0x08, 0x00, 0x0c, 0x00, 0x10, 0x00, 0x14, 0x00,
  0x00, 0x00, 0x18, 0x00, 0x12, 0x00, 0x00, 0x00, 0x03, 0x00, 0x00, 0x00,
  0x74, 0x45, 0x00, 0x00, 0x50, 0x3c, 0x00, 0x00, 0x38, 0x3c, 0x00, 0x00,
  0x34, 0x00, 0x00, 0x00, 0x04, 0x00, 0x00, 0x00, 0x01, 0x00, 0x00, 0x00,
  0x04, 0x00, 0x00, 0x00, 0x30, 0xbb, 0xff, 0xff, 0x08, 0x00, 0x00, 0x00,
  0x17, 0x00, 0x00, 0x00, 0x13, 0x00, 0x00, 0x00, 0x6d, 0x69, 0x6e, 0x5f,
  0x72, 0x75, 0x6e, 0x74, 0x69, 0x6d, 0x65, 0x5f, 0x76, 0x65, 0x72, 0x73,
  0x69, 0x6f, 0x6e, 0x00, 0x18, 0x00, 0x00, 0x00, 0xf8, 0x3b, 0x00, 0x00,
  0xf0, 0x3b, 0x00, 0x00, 0x60, 0x2f, 0x00, 0x00, 0xa8, 0x1f, 0x00, 0x00,
  0xa0, 0x1f, 0x00, 0x00, 0xc8, 0x1e, 0x00, 0x00, 0xc0, 0x1e, 0x00, 0x00,
  0x60, 0x1e, 0x00, 0x00, 0x58, 0x1e, 0x00, 0x00, 0x50, 0x1e, 0x00, 0x00,
  0x48, 0x1e, 0x00, 0x00, 0x40, 0x1e, 0x00, 0x00, 0x38, 0x1e, 0x00, 0x00,
  0x28, 0x1a, 0x00, 0x00, 0xd8, 0x19, 0x00, 0x00, 0x00, 0x19, 0x00, 0x00,
  0x2c, 0x0f, 0x00, 0x00, 0xf4, 0x0e, 0x00, 0x00, 0x20, 0x05, 0x00, 0x00,
  0x48, 0x04, 0x00, 0x00, 0x18, 0x01, 0x00, 0x00, 0x40, 0x00, 0x00, 0x00,
  0x1c, 0x00, 0x00, 0x00, 0x04, 0x00, 0x00, 0x00, 0xfe, 0xd0, 0xff, 0xff,
  0x04, 0x00, 0x00, 0x00, 0x05, 0x00, 0x00, 0x00, 0x31, 0x2e, 0x35, 0x2e,
  0x30, 0x00, 0x00, 0x00, 0x12, 0xd1, 0xff, 0xff, 0x04, 0x00, 0x00, 0x00,
  0x14, 0x00, 0x00, 0x00, 0xd4, 0x32, 0x28, 0x3d, 0x2d, 0x9f, 0xa4, 0x3d,
  0x16, 0x79, 0x9d, 0x3c, 0x5c, 0x1a, 0xc8, 0x3e, 0x5e, 0x94, 0x40, 0x3d,
  0x32, 0xd1, 0xff, 0xff, 0x04, 0x00, 0x00, 0x00, 0xc8, 0x00, 0x00, 0x00,
  0xc4, 0x2c, 0x21, 0x3f, 0x9c, 0x5e, 0xe9, 0xbe, 0x68, 0xc1, 0x83, 0xbe,
  0x15, 0xa8, 0x41, 0x3e, 0xf0, 0xf2, 0x2f, 0x3f, 0x40, 0x08, 0x0f, 0x3f,
  0x1b, 0x1a, 0xfb, 0x3e, 0x7c, 0xfc, 0x49, 0xbe, 0x56, 0x5d, 0x5c, 0x3e,
  0xbd, 0xa9, 0x19, 0x3f, 0x33, 0x5d, 0x82, 0xbe, 0xb3, 0x67, 0xbd, 0xbd,
  0xa0, 0x6b, 0xc8, 0x3d, 0x23, 0x03, 0xca, 0xbe, 0x23, 0xa2, 0x0b, 0x3f,
  0xc0, 0x2a, 0x17, 0xbf, 0x85, 0x15, 0x42, 0x3d, 0x2c, 0x69, 0x29, 0x3f,
  0x65, 0xb7, 0x4c, 0xbd, 0x69, 0xca, 0x05, 0xbe, 0xee, 0xdc, 0x43, 0xbf,
  0xc4, 0x85, 0xa7, 0x3e, 0x28, 0x0f, 0xe4, 0x3d, 0x28, 0xfb, 0x86, 0x3e,
  0xaf, 0x5e, 0xd2, 0xbc, 0xda, 0x1d, 0x01, 0xbf, 0x59, 0xfe, 0x71, 0xbe,
  0x56, 0xf6, 0x08, 0x3f, 0x07, 0x05, 0x94, 0x3e, 0x68, 0x89, 0xa7, 0x3d,
  0x40, 0xd4, 0xb9, 0x3d, 0x60, 0x1c, 0xcf, 0x3e, 0xc5, 0x9d, 0xa6, 0xbe,
  0x63, 0xb7, 0xd9, 0x3e, 0x69, 0x30, 0x1f, 0xbe, 0x78, 0x76, 0xca, 0xbe,
  0xb3, 0xcb, 0xf2, 0x3e, 0x3d, 0x1b, 0x63, 0xbd, 0xc5, 0x2d, 0x50, 0x3e,
  0x40, 0x05, 0xb8, 0xbd, 0x19, 0xf8, 0x10, 0x3e, 0x2c, 0xad, 0x0f, 0xbf,
  0xd4, 0x7b, 0x0b, 0xbf, 0xdb, 0x2c, 0x6a, 0x3e, 0xcf, 0x8e, 0x10, 0xbf,
  0x69, 0xbd, 0x29, 0x3e, 0x1f, 0x39, 0x7d, 0x3e, 0x6d, 0xbe, 0xf7, 0xbd,
  0x0d, 0xd8, 0x5a, 0x3f, 0x49, 0xae, 0x0b, 0xbd, 0x06, 0xd2, 0xff, 0xff,
  0x04, 0x00, 0x00, 0x00, 0x20, 0x03, 0x00, 0x00, 0xcc, 0x3f, 0xa5, 0xbe,
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
};
