bialykostek/kontroler/Kontroler/babyDodoTFPPM/flight_model_7.h

#define TENSORFLOW_LITE_EXPERIMENTAL_MICRO_EXAMPLES_HELLO_WORLD_SINE_MODEL_DATA_H_
#ifdef __has_attribute
#define HAVE_ATTRIBUTE(x) __has_attribute(x)
#else
#define HAVE_ATTRIBUTE(x) 0
#endif
#if HAVE_ATTRIBUTE(aligned) || (defined(__GNUC__) && !defined(__clang__))
#define DATA_ALIGN_ATTRIBUTE __attribute__((aligned(4)))
#else
#define DATA_ALIGN_ATTRIBUTE
#endif

const int flight_model_len = 14784;
const unsigned char flight_model[] DATA_ALIGN_ATTRIBUTE = {
 0x20, 0x00, 0x00, 0x00, 0x54, 0x46, 0x4c, 0x33, 0x00, 0x00, 0x00, 0x00,
  0x00, 0x00, 0x12, 0x00, 0x1c, 0x00, 0x04, 0x00, 0x08, 0x00, 0x0c, 0x00,
  0x10, 0x00, 0x14, 0x00, 0x00, 0x00, 0x18, 0x00, 0x12, 0x00, 0x00, 0x00,
  0x03, 0x00, 0x00, 0x00, 0x78, 0x39, 0x00, 0x00, 0x9c, 0x31, 0x00, 0x00,
  0x84, 0x31, 0x00, 0x00, 0x34, 0x00, 0x00, 0x00, 0x04, 0x00, 0x00, 0x00,
  0x01, 0x00, 0x00, 0x00, 0x04, 0x00, 0x00, 0x00, 0x2c, 0xc7, 0xff, 0xff,
  0x08, 0x00, 0x00, 0x00, 0x14, 0x00, 0x00, 0x00, 0x13, 0x00, 0x00, 0x00,
  0x6d, 0x69, 0x6e, 0x5f, 0x72, 0x75, 0x6e, 0x74, 0x69, 0x6d, 0x65, 0x5f,
  0x76, 0x65, 0x72, 0x73, 0x69, 0x6f, 0x6e, 0x00, 0x15, 0x00, 0x00, 0x00,
  0x44, 0x31, 0x00, 0x00, 0x3c, 0x31, 0x00, 0x00, 0xac, 0x24, 0x00, 0x00,
  0x74, 0x21, 0x00, 0x00, 0x6c, 0x21, 0x00, 0x00, 0x94, 0x20, 0x00, 0x00,
  0x8c, 0x20, 0x00, 0x00, 0x84, 0x20, 0x00, 0x00, 0x7c, 0x20, 0x00, 0x00,
  0x74, 0x20, 0x00, 0x00, 0x6c, 0x20, 0x00, 0x00, 0x5c, 0x1c, 0x00, 0x00,
  0x0c, 0x1c, 0x00, 0x00, 0x34, 0x1b, 0x00, 0x00, 0x60, 0x11, 0x00, 0x00,
  0x3c, 0x11, 0x00, 0x00, 0x8c, 0x01, 0x00, 0x00, 0x2c, 0x01, 0x00, 0x00,
  0xf4, 0x00, 0x00, 0x00, 0x1c, 0x00, 0x00, 0x00, 0x04, 0x00, 0x00, 0x00,
  0xa6, 0xdb, 0xff, 0xff, 0x04, 0x00, 0x00, 0x00, 0x05, 0x00, 0x00, 0x00,
  0x31, 0x2e, 0x35, 0x2e, 0x30, 0x00, 0x00, 0x00, 0xba, 0xdb, 0xff, 0xff,
  0x04, 0x00, 0x00, 0x00, 0xc8, 0x00, 0x00, 0x00, 0x21, 0x3d, 0x02, 0x3f,
  0xeb, 0x9f, 0x90, 0xbe, 0x61, 0x35, 0xf7, 0x3e, 0xda, 0x86, 0xcc, 0x3e,
  0x40, 0xa2, 0xf3, 0xbc, 0xae, 0x6f, 0x65, 0xbe, 0x6d, 0x1d, 0x72, 0xbe,
  0xdd, 0xc0, 0x98, 0xbc, 0xff, 0xfd, 0xb8, 0xbe, 0xe7, 0xc5, 0x24, 0x3f,
  0x6f, 0x40, 0x94, 0xbd, 0x7e, 0x30, 0x05, 0x3e, 0x84, 0x07, 0xbe, 0xbe,
  0x56, 0x48, 0x21, 0x3f, 0x8d, 0xfe, 0x9c, 0xbe, 0x2c, 0x64, 0x8d, 0xbe,
  0x53, 0xa5, 0x91, 0x3e, 0xc6, 0x7b, 0x1e, 0xbf, 0x1f, 0xc8, 0xa6, 0x3e,
  0x31, 0x60, 0xf2, 0xbc, 0x46, 0xfa, 0xb7, 0x3e, 0x33, 0x2a, 0x37, 0x3e,
  0xc1, 0x75, 0x50, 0xbe, 0x0d, 0xb2, 0xe5, 0xbd, 0x88, 0x75, 0x67, 0x3e,
  0xe7, 0xa0, 0x81, 0x3e, 0x32, 0xb6, 0x8b, 0x3e, 0x46, 0x5f, 0xdd, 0x3d,
  0x84, 0xaa, 0x7d, 0x3e, 0x37, 0x77, 0xb6, 0xbd, 0xe4, 0x89, 0xe9, 0xbe,
  0xb0, 0x7f, 0xa3, 0xbd, 0x07, 0xc3, 0xa0, 0xbe, 0x50, 0x32, 0xd2, 0xbd,
  0xf7, 0x39, 0x0a, 0xbf, 0x90, 0x0b, 0x19, 0x3d, 0x3d, 0xeb, 0xe6, 0xbc,
  0x60, 0x34, 0x09, 0x3f, 0x22, 0xc7, 0x2c, 0x3e, 0x93, 0xc8, 0x57, 0x3e,
  0xe0, 0x63, 0x04, 0xbf, 0xef, 0x5d, 0x9a, 0x3e, 0xa7, 0x19, 0xad, 0x3e,
  0x98, 0x36, 0x0b, 0x3f, 0xac, 0xc6, 0x31, 0x3e, 0x63, 0xd1, 0x23, 0xbe,
  0x81, 0x81, 0xd4, 0xbe, 0x7b, 0xad, 0x9f, 0x3e, 0xec, 0x1a, 0x0d, 0xbf,
  0xac, 0xc4, 0x94, 0x3e, 0x8e, 0xdc, 0xff, 0xff, 0x04, 0x00, 0x00, 0x00,
  0x28, 0x00, 0x00, 0x00, 0x14, 0x8d, 0xcc, 0xbc, 0x46, 0xa6, 0x1a, 0xbd,
  0x2f, 0x91, 0xde, 0xbb, 0x2b, 0xb9, 0xc4, 0x3b, 0x00, 0x00, 0x00, 0x00,
  0x9e, 0xf5, 0x16, 0xbc, 0x5d, 0x3d, 0xfc, 0x3c, 0xfe, 0xa8, 0x16, 0x3c,
  0xd5, 0xae, 0xac, 0x3b, 0x05, 0x61, 0xd7, 0x3d, 0xc2, 0xdc, 0xff, 0xff,
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
 
};
