bialykostek/kontroler/Kontroler/babyDodoTFPPM/flight_model_8.h

#define TENSORFLOW_LITE_EXPERIMENTAL_MICRO_EXAMPLES_HELLO_WORLD_SINE_MODEL_DATA_H_
#ifdef __has_attribute
#define HAVE_ATTRIBUTE(x) __has_attribute(x)
#else
#define HAVE_ATTRIBUTE(x) 0
#endif
#if HAVE_ATTRIBUTE(aligned) || (defined(__GNUC__) && !defined(__clang__))
#define DATA_ALIGN_ATTRIBUTE __attribute__((aligned(4)))
#else
#define DATA_ALIGN_ATTRIBUTE
#endif

const int flight_model_len = 9152;
const unsigned char flight_model[] DATA_ALIGN_ATTRIBUTE = {
 0x20, 0x00, 0x00, 0x00, 0x54, 0x46, 0x4c, 0x33, 0x00, 0x00, 0x00, 0x00,
  0x00, 0x00, 0x12, 0x00, 0x1c, 0x00, 0x04, 0x00, 0x08, 0x00, 0x0c, 0x00,
  0x10, 0x00, 0x14, 0x00, 0x00, 0x00, 0x18, 0x00, 0x12, 0x00, 0x00, 0x00,
  0x03, 0x00, 0x00, 0x00, 0x78, 0x23, 0x00, 0x00, 0x2c, 0x20, 0x00, 0x00,
  0x14, 0x20, 0x00, 0x00, 0x34, 0x00, 0x00, 0x00, 0x04, 0x00, 0x00, 0x00,
  0x01, 0x00, 0x00, 0x00, 0x04, 0x00, 0x00, 0x00, 0x2c, 0xdd, 0xff, 0xff,
  0x08, 0x00, 0x00, 0x00, 0x08, 0x00, 0x00, 0x00, 0x13, 0x00, 0x00, 0x00,
  0x6d, 0x69, 0x6e, 0x5f, 0x72, 0x75, 0x6e, 0x74, 0x69, 0x6d, 0x65, 0x5f,
  0x76, 0x65, 0x72, 0x73, 0x69, 0x6f, 0x6e, 0x00, 0x09, 0x00, 0x00, 0x00,
  0xd4, 0x1f, 0x00, 0x00, 0xcc, 0x1f, 0x00, 0x00, 0x1c, 0x10, 0x00, 0x00,
  0x0c, 0x10, 0x00, 0x00, 0x00, 0x10, 0x00, 0x00, 0x70, 0x03, 0x00, 0x00,
  0x40, 0x00, 0x00, 0x00, 0x1c, 0x00, 0x00, 0x00, 0x04, 0x00, 0x00, 0x00,
  0x06, 0xf0, 0xff, 0xff, 0x04, 0x00, 0x00, 0x00, 0x05, 0x00, 0x00, 0x00,
  0x31, 0x2e, 0x35, 0x2e, 0x30, 0x00, 0x00, 0x00, 0x1a, 0xf0, 0xff, 0xff,
  0x04, 0x00, 0x00, 0x00, 0x14, 0x00, 0x00, 0x00, 0xec, 0xca, 0xa3, 0x3d,
  0x80, 0x4d, 0x7f, 0x3d, 0x23, 0x94, 0x89, 0x3d, 0x77, 0x33, 0x42, 0x3d,
  0x27, 0x7c, 0x55, 0x3d, 0x3a, 0xf0, 0xff, 0xff, 0x04, 0x00, 0x00, 0x00,
  0x20, 0x03, 0x00, 0x00, 0xab, 0xd8, 0x54, 0x3e, 0xc4, 0xfa, 0xda, 0xbb,
  0xb7, 0xa4, 0x2e, 0x3d, 0x95, 0x4c, 0x53, 0x3e, 0x00, 0x00, 0x00, 0x00,
  0x22, 0x12, 0x13, 0xbd, 0x00, 0x00, 0x00, 0x00, 0x07, 0x6b, 0xe5, 0xbc,
  0x05, 0xd7, 0x75, 0xbc, 0x52, 0x78, 0x83, 0xbb, 0x00, 0x00, 0x00, 0x00,
  0x09, 0x5e, 0xfb, 0xbb, 0x00, 0x00, 0x00, 0x00, 0x5f, 0x34, 0x2d, 0xbb,
  0x34, 0x25, 0x91, 0xbc, 0xb3, 0xfb, 0xa9, 0xbb, 0x33, 0x2f, 0xd6, 0xbb,
  0x19, 0x75, 0xa6, 0xbc, 0xb5, 0xec, 0x55, 0x3d, 0xf6, 0x17, 0xca, 0x3d,
  0x55, 0x1b, 0x71, 0xbd, 0x43, 0x71, 0xc4, 0x3c, 0x5e, 0x5a, 0x93, 0x3d,
  0x00, 0x00, 0x00, 0x00, 0x00, 0x00, 0x00, 0x00, 0x6a, 0x99, 0x5d, 0x3d,
  0x87, 0x08, 0x46, 0xbd, 0xc6, 0x66, 0x86, 0x3b, 0x78, 0x65, 0x97, 0x3d,
  0x90, 0xe3, 0x21, 0x3d, 0x0d, 0x7d, 0x91, 0xbc, 0x27, 0xca, 0x9f, 0x3d,
  0x43, 0x5a, 0x33, 0xbc, 0xf5, 0x98, 0x81, 0xbd, 0x00, 0x00, 0x00, 0x00,
  0xcd, 0xae, 0x52, 0x3d, 0x32, 0x50, 0x3f, 0x3d, 0x9e, 0x3b, 0xde, 0x3c,
  0x00, 0x00, 0x00, 0x00, 0x00, 0x00, 0x00, 0x00, 0x00, 0x00, 0x00, 0x00,
  0xde, 0xae, 0x2a, 0xbd, 0x00, 0x00, 0x00, 0x00, 0x27, 0xb7, 0x5c, 0xbd,
  0x00, 0x00, 0x00, 0x00, 0x91, 0x5e, 0xa8, 0xba, 0x4f, 0x18, 0x58, 0xbc,
  0x67, 0xf0, 0x93, 0xbd, 0x00, 0x00, 0x00, 0x00, 0xd9, 0x79, 0x8a, 0x3d,
  0x4a, 0x88, 0x0c, 0xbc, 0xba, 0x9d, 0x53, 0xbc, 0xc3, 0x11, 0x8a, 0x3d,
  0x00, 0x00, 0x00, 0x00, 0xa2, 0x42, 0x3f, 0x3c, 0x00, 0x00, 0x00, 0x00,
  0x0c, 0x4f, 0xd6, 0x3d, 0x64, 0xcd, 0x67, 0x3d, 0x00, 0x00, 0x00, 0x00,
  0xcc, 0xec, 0x3a, 0x3d, 0x00, 0x00, 0x00, 0x00, 0x05, 0xed, 0x59, 0x3d,
  0x00, 0x00, 0x00, 0x00, 0x9d, 0x2c, 0x57, 0x3d, 0xab, 0xf7, 0x8f, 0xbb,
  0x00, 0x00, 0x00, 0x00, 0x38, 0x09, 0x90, 0x3d, 0x32, 0x49, 0xef, 0x3d,
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
};
