bialykostek/kontroler/Kontroler/babyDodoTFPPM/flight_model_9.h

#define TENSORFLOW_LITE_EXPERIMENTAL_MICRO_EXAMPLES_HELLO_WORLD_SINE_MODEL_DATA_H_
#ifdef __has_attribute
#define HAVE_ATTRIBUTE(x) __has_attribute(x)
#else
#define HAVE_ATTRIBUTE(x) 0
#endif
#if HAVE_ATTRIBUTE(aligned) || (defined(__GNUC__) && !defined(__clang__))
#define DATA_ALIGN_ATTRIBUTE __attribute__((aligned(4)))
#else
#define DATA_ALIGN_ATTRIBUTE
#endif

const int flight_model_len = 5152;
const unsigned char flight_model[] DATA_ALIGN_ATTRIBUTE = {
 0x20, 0x00, 0x00, 0x00, 0x54, 0x46, 0x4c, 0x33, 0x00, 0x00, 0x00, 0x00,
  0x00, 0x00, 0x12, 0x00, 0x1c, 0x00, 0x04, 0x00, 0x08, 0x00, 0x0c, 0x00,
  0x10, 0x00, 0x14, 0x00, 0x00, 0x00, 0x18, 0x00, 0x12, 0x00, 0x00, 0x00,
  0x03, 0x00, 0x00, 0x00, 0xd8, 0x13, 0x00, 0x00, 0x8c, 0x10, 0x00, 0x00,
  0x74, 0x10, 0x00, 0x00, 0x34, 0x00, 0x00, 0x00, 0x04, 0x00, 0x00, 0x00,
  0x01, 0x00, 0x00, 0x00, 0x04, 0x00, 0x00, 0x00, 0xcc, 0xec, 0xff, 0xff,
  0x08, 0x00, 0x00, 0x00, 0x08, 0x00, 0x00, 0x00, 0x13, 0x00, 0x00, 0x00,
  0x6d, 0x69, 0x6e, 0x5f, 0x72, 0x75, 0x6e, 0x74, 0x69, 0x6d, 0x65, 0x5f,
  0x76, 0x65, 0x72, 0x73, 0x69, 0x6f, 0x6e, 0x00, 0x09, 0x00, 0x00, 0x00,
  0x34, 0x10, 0x00, 0x00, 0x2c, 0x10, 0x00, 0x00, 0x4c, 0x08, 0x00, 0x00,
  0x3c, 0x08, 0x00, 0x00, 0x30, 0x08, 0x00, 0x00, 0xe0, 0x01, 0x00, 0x00,
  0x40, 0x00, 0x00, 0x00, 0x1c, 0x00, 0x00, 0x00, 0x04, 0x00, 0x00, 0x00,
  0xd6, 0xf7, 0xff, 0xff, 0x04, 0x00, 0x00, 0x00, 0x05, 0x00, 0x00, 0x00,
  0x31, 0x2e, 0x35, 0x2e, 0x30, 0x00, 0x00, 0x00, 0xea, 0xf7, 0xff, 0xff,
  0x04, 0x00, 0x00, 0x00, 0x14, 0x00, 0x00, 0x00, 0xa5, 0xc5, 0xfb, 0x3d,
  0x6a, 0x1a, 0xe4, 0x3d, 0x86, 0x26, 0xe9, 0x3d, 0xfe, 0x00, 0xa0, 0x3d,
  0xd4, 0x4f, 0xd1, 0x3d, 0x0a, 0xf8, 0xff, 0xff, 0x04, 0x00, 0x00, 0x00,
  0x90, 0x01, 0x00, 0x00, 0x89, 0xa8, 0xc7, 0xbd, 0x00, 0x00, 0x00, 0x00,
  0x90, 0x9d, 0x93, 0xbc, 0x73, 0x8f, 0x86, 0xbc, 0x04, 0x57, 0xf7, 0x3d,
  0x00, 0x00, 0x00, 0x00, 0x6f, 0xe3, 0x4a, 0x3e, 0xb7, 0x90, 0xc3, 0x3d,
  0x65, 0xe6, 0xff, 0xbb, 0x28, 0x92, 0xc0, 0xbd, 0x00, 0x00, 0x00, 0x00,
  0x00, 0x00, 0x00, 0x00, 0x00, 0x00, 0x00, 0x00, 0x00, 0x00, 0x00, 0x00,
  0x00, 0x00, 0x00, 0x00, 0x00, 0x00, 0x00, 0x00, 0x12, 0x06, 0xf8, 0xbc,
  0xf4, 0x88, 0xcb, 0x3b, 0xbb, 0xc9, 0xc9, 0x3d, 0xd6, 0x8f, 0x12, 0x3e,
  0x06, 0x01, 0xc7, 0xbd, 0x00, 0x00, 0x00, 0x00, 0x27, 0x5b, 0x24, 0xbc,
  0x4b, 0xbb, 0x0a, 0xbe, 0x00, 0x00, 0x00, 0x00, 0xa5, 0xc5, 0x02, 0x3e,
  0xf0, 0x22, 0x2d, 0x3e, 0x00, 0x00, 0x00, 0x00, 0x00, 0x00, 0x00, 0x00,
  0xc1, 0xaf, 0x80, 0xbc, 0x00, 0x00, 0x00, 0x00, 0x92, 0x9a, 0x16, 0xbd,
  0x8c, 0xa7, 0x92, 0x3d, 0x4c, 0x58, 0x17, 0xbd, 0x0b, 0x1f, 0xab, 0xbc,
  0x00, 0x00, 0x00, 0x00, 0x61, 0x5c, 0xf7, 0xbb, 0x15, 0x29, 0x2b, 0x3e,
  0x3e, 0x29, 0x52, 0x3d, 0x1b, 0xb0, 0xe0, 0x3d, 0xf1, 0xfb, 0x7d, 0xbd,
  0x5b, 0xe1, 0x06, 0xbd, 0xcd, 0x1a, 0x37, 0xbc, 0xeb, 0x9f, 0x54, 0x3d,
  0x00, 0x00, 0x00, 0x00, 0x00, 0x00, 0x00, 0x00, 0x35, 0x82, 0xce, 0xbd,
  0x00, 0x00, 0x00, 0x00, 0x04, 0x9a, 0xab, 0xbc, 0x00, 0x00, 0x00, 0x00,
  0x00, 0x00, 0x00, 0x00, 0x00, 0x00, 0x00, 0x00, 0x00, 0x00, 0x00, 0x00,
  0x00, 0x00, 0x00, 0x00, 0x00, 0x00, 0x00, 0x00, 0x60, 0x36, 0xc0, 0x3c,
  0x00, 0x00, 0x00, 0x00, 0xd1, 0xdc, 0xac, 0xbc, 0x67, 0x45, 0x10, 0xbd,
  0xee, 0x09, 0xc0, 0xbd, 0xaa, 0xbb, 0xc7, 0x3d, 0x00, 0x00, 0x00, 0x00,
  0x68, 0x18, 0xd2, 0xbd, 0xea, 0xbe, 0xcb, 0x3e, 0x38, 0x82, 0x93, 0x3d,
  0x0b, 0xc6, 0xb9, 0x3d, 0x00, 0x00, 0x00, 0x00, 0xe9, 0x80, 0x81, 0x3d,
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
};
