bialykostek/kontroler/AI/second_model.h

#define TENSORFLOW_LITE_EXPERIMENTAL_MICRO_EXAMPLES_HELLO_WORLD_SINE_MODEL_DATA_H_
#ifdef __has_attribute
#define HAVE_ATTRIBUTE(x) __has_attribute(x)
#else
#define HAVE_ATTRIBUTE(x) 0
#endif
#if HAVE_ATTRIBUTE(aligned) || (defined(__GNUC__) && !defined(__clang__))
#define DATA_ALIGN_ATTRIBUTE __attribute__((aligned(4)))
#else
#define DATA_ALIGN_ATTRIBUTE
#endif
const int g_second_model_data_len = 4772;
const unsigned char g_second_model_data[] DATA_ALIGN_ATTRIBUTE = {
 0x1c, 0x00, 0x00, 0x00, 0x54, 0x46, 0x4c, 0x33, 0x00, 0x00, 0x12, 0x00,
  0x1c, 0x00, 0x04, 0x00, 0x08, 0x00, 0x0c, 0x00, 0x10, 0x00, 0x14, 0x00,
  0x00, 0x00, 0x18, 0x00, 0x12, 0x00, 0x00, 0x00, 0x03, 0x00, 0x00, 0x00,
  0x50, 0x12, 0x00, 0x00, 0xe0, 0x0e, 0x00, 0x00, 0xc8, 0x0e, 0x00, 0x00,
  0x34, 0x00, 0x00, 0x00, 0x04, 0x00, 0x00, 0x00, 0x01, 0x00, 0x00, 0x00,
  0x04, 0x00, 0x00, 0x00, 0x54, 0xee, 0xff, 0xff, 0x08, 0x00, 0x00, 0x00,
  0x09, 0x00, 0x00, 0x00, 0x13, 0x00, 0x00, 0x00, 0x6d, 0x69, 0x6e, 0x5f,
  0x72, 0x75, 0x6e, 0x74, 0x69, 0x6d, 0x65, 0x5f, 0x76, 0x65, 0x72, 0x73,
  0x69, 0x6f, 0x6e, 0x00, 0x0a, 0x00, 0x00, 0x00, 0x88, 0x0e, 0x00, 0x00,
  0x80, 0x0e, 0x00, 0x00, 0x54, 0x0c, 0x00, 0x00, 0x44, 0x0c, 0x00, 0x00,
  0x38, 0x0c, 0x00, 0x00, 0x30, 0x0c, 0x00, 0x00, 0xbc, 0x00, 0x00, 0x00,
  0x40, 0x00, 0x00, 0x00, 0x1c, 0x00, 0x00, 0x00, 0x04, 0x00, 0x00, 0x00,
  0xd2, 0xf3, 0xff, 0xff, 0x04, 0x00, 0x00, 0x00, 0x06, 0x00, 0x00, 0x00,
  0x31, 0x2e, 0x31, 0x34, 0x2e, 0x30, 0x00, 0x00, 0xe6, 0xf3, 0xff, 0xff,
  0x04, 0x00, 0x00, 0x00, 0x14, 0x00, 0x00, 0x00, 0xe3, 0x76, 0xdd, 0x3c,
  0x82, 0x8a, 0x98, 0x3c, 0x8f, 0x0c, 0x1e, 0x3d, 0x26, 0x3e, 0x0a, 0x3d,
  0xc1, 0x58, 0xb0, 0x3c, 0x06, 0xf4, 0xff, 0xff, 0x04, 0x00, 0x00, 0x00,
  0x6c, 0x00, 0x00, 0x00, 0xf5, 0x24, 0x2c, 0x3d, 0xdd, 0x98, 0x2f, 0xbd,
  0xed, 0x5f, 0x25, 0x3d, 0x5f, 0x02, 0x1b, 0xbd, 0xa2, 0x06, 0x0d, 0xbd,
  0xaf, 0xcc, 0xdc, 0x3c, 0x05, 0xf9, 0x04, 0xbd, 0x2d, 0xa6, 0x02, 0xbd,
  0xc3, 0x16, 0x18, 0x3d, 0xae, 0x2a, 0x3a, 0xbd, 0xe5, 0x84, 0x2b, 0xbd,
  0x3c, 0x74, 0x0c, 0xbd, 0x6f, 0x51, 0x9f, 0xbc, 0x0b, 0xac, 0x16, 0xbd,
  0x2d, 0x00, 0x19, 0xbd, 0xa8, 0x04, 0x2e, 0x3d, 0xf4, 0x3d, 0x59, 0x3c,
  0xee, 0xfa, 0x24, 0xbd, 0x0c, 0x71, 0x4c, 0x3d, 0x45, 0xb8, 0x1e, 0xbd,
  0xe9, 0x64, 0x11, 0xbd, 0x98, 0xed, 0x1a, 0xbd, 0x44, 0x79, 0x25, 0x3d,
  0x9b, 0xd9, 0x1d, 0x3d, 0xc5, 0xb2, 0x2f, 0x3d, 0xa3, 0x1c, 0x18, 0x3d,
  0x5c, 0x5c, 0x0f, 0xbd, 0x7e, 0xf4, 0xff, 0xff, 0x04, 0x00, 0x00, 0x00,
  0x64, 0x0b, 0x00, 0x00, 0x96, 0xf9, 0x9d, 0x3e, 0x00, 0x4e, 0x3c, 0x3e,
  0x58, 0xb1, 0x62, 0xbe, 0xea, 0x34, 0xfb, 0xbc, 0xa8, 0xd6, 0xa5, 0x3e,
  0x04, 0x36, 0x85, 0x3a, 0xc1, 0x47, 0x60, 0xbe, 0x4a, 0x04, 0x36, 0x3e,
  0x5a, 0x1b, 0xb2, 0x3e, 0x51, 0xe7, 0x59, 0x3d, 0xd4, 0x2e, 0x42, 0x3e,
  0xe5, 0x2a, 0x63, 0xbc, 0xbe, 0x33, 0x5d, 0xbe, 0x82, 0x47, 0x60, 0x3e,
  0xee, 0x6a, 0xab, 0xbc, 0xa3, 0xfa, 0x91, 0xbe, 0x72, 0x6c, 0x2e, 0x3d,
  0xe6, 0x55, 0x6f, 0xbe, 0xc3, 0x32, 0xdb, 0x3c, 0x45, 0x2f, 0xe4, 0x3d,
  0xcc, 0xd4, 0x4b, 0xbe, 0xee, 0x6e, 0x5d, 0x3e, 0x01, 0x19, 0x83, 0x3e,
  0xa5, 0x52, 0xcc, 0xbc, 0x33, 0x7d, 0xdf, 0xbc, 0xe6, 0x93, 0x0e, 0xbb,
  0xde, 0x93, 0x74, 0xbd, 0x15, 0x06, 0x8e, 0x3e, 0xd7, 0xd0, 0x4f, 0xbc,
  0x01, 0x2f, 0x1a, 0x3e, 0x35, 0xa6, 0x87, 0x3e, 0xc8, 0x70, 0x33, 0x3e,
  0xc4, 0x67, 0x0f, 0x3e, 0x05, 0x73, 0x63, 0xbe, 0xeb, 0x2a, 0x9e, 0xbe,
  0x5c, 0x81, 0xea, 0xbc, 0x8d, 0x61, 0x9d, 0xbe, 0x3f, 0x42, 0x97, 0xbe,
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
};
