bialykostek/kontroler/AI/some_model.h

#ifndef SOME_MODEL_H
#define SOME_MODEL_H


unsigned int some_model_len = 5800;
unsigned char some_model[] = {
 0x1c, 0x00, 0x00, 0x00, 0x54, 0x46, 0x4c, 0x33, 0x00, 0x00, 0x12, 0x00,
  0x1c, 0x00, 0x04, 0x00, 0x08, 0x00, 0x0c, 0x00, 0x10, 0x00, 0x14, 0x00,
  0x00, 0x00, 0x18, 0x00, 0x12, 0x00, 0x00, 0x00, 0x03, 0x00, 0x00, 0x00,
  0x54, 0x16, 0x00, 0x00, 0x54, 0x11, 0x00, 0x00, 0x3c, 0x11, 0x00, 0x00,
  0x34, 0x00, 0x00, 0x00, 0x04, 0x00, 0x00, 0x00, 0x01, 0x00, 0x00, 0x00,
  0x04, 0x00, 0x00, 0x00, 0x50, 0xea, 0xff, 0xff, 0x08, 0x00, 0x00, 0x00,
  0x0d, 0x00, 0x00, 0x00, 0x13, 0x00, 0x00, 0x00, 0x6d, 0x69, 0x6e, 0x5f,
  0x72, 0x75, 0x6e, 0x74, 0x69, 0x6d, 0x65, 0x5f, 0x76, 0x65, 0x72, 0x73,
  0x69, 0x6f, 0x6e, 0x00, 0x0e, 0x00, 0x00, 0x00, 0xfc, 0x10, 0x00, 0x00,
  0xf4, 0x10, 0x00, 0x00, 0xbc, 0x0b, 0x00, 0x00, 0xac, 0x0b, 0x00, 0x00,
  0xa0, 0x0b, 0x00, 0x00, 0x98, 0x0b, 0x00, 0x00, 0x90, 0x0b, 0x00, 0x00,
  0x88, 0x0b, 0x00, 0x00, 0x30, 0x02, 0x00, 0x00, 0xc8, 0x01, 0x00, 0x00,
  0x7c, 0x01, 0x00, 0x00, 0x40, 0x00, 0x00, 0x00, 0x1c, 0x00, 0x00, 0x00,
  0x04, 0x00, 0x00, 0x00, 0x7a, 0xf4, 0xff, 0xff, 0x04, 0x00, 0x00, 0x00,
  0x06, 0x00, 0x00, 0x00, 0x31, 0x2e, 0x31, 0x34, 0x2e, 0x30, 0x00, 0x00,
  0x8e, 0xf4, 0xff, 0xff, 0x04, 0x00, 0x00, 0x00, 0x14, 0x00, 0x00, 0x00,
  0x4d, 0xd4, 0xde, 0x3c, 0x66, 0x65, 0x33, 0x3d, 0x46, 0xdf, 0xd0, 0x3d,
  0x70, 0xf3, 0x94, 0x3d, 0xb8, 0x2e, 0xb0, 0x3d, 0xae, 0xf4, 0xff, 0xff,
  0x04, 0x00, 0x00, 0x00, 0x2c, 0x01, 0x00, 0x00, 0x6a, 0x21, 0xcd, 0x3e,
  0x88, 0x81, 0x29, 0xbe, 0xca, 0xb4, 0x78, 0xbe, 0x02, 0x2c, 0x54, 0xbe,
  0xec, 0x56, 0x26, 0xbe, 0x17, 0xdb, 0xa7, 0x3c, 0xb4, 0x4d, 0x54, 0x3e,
  0x41, 0x77, 0x01, 0x3f, 0x99, 0x73, 0x47, 0xbe, 0xfd, 0x24, 0x20, 0x3c,
  0xe8, 0xab, 0xa0, 0xbc, 0x25, 0xbd, 0x43, 0xbd, 0x84, 0x71, 0x30, 0xbd,
  0xe0, 0xbe, 0x97, 0xbe, 0xf4, 0xa6, 0xf6, 0x3e, 0xdd, 0x0e, 0x8f, 0x3d,
  0x17, 0xa0, 0x67, 0xbe, 0xb8, 0x25, 0x6f, 0xbd, 0x88, 0xea, 0x01, 0xbe,
  0x88, 0x0c, 0xd8, 0x3e, 0x10, 0x47, 0x27, 0x3f, 0xb7, 0xc1, 0xeb, 0xbe,
  0x4e, 0xc2, 0x86, 0x3d, 0x76, 0xde, 0x63, 0x3d, 0x20, 0x15, 0xc1, 0x3c,
  0xe2, 0xf9, 0xe7, 0x3d, 0x7b, 0x07, 0x41, 0x3d, 0x75, 0x2e, 0x37, 0x3f,
  0x91, 0xa9, 0x82, 0xbe, 0x85, 0x63, 0x8b, 0x3e, 0x71, 0xb1, 0xf7, 0x3e,
  0x78, 0x6e, 0xa1, 0x3e, 0x18, 0xa9, 0xc3, 0xbe, 0x9b, 0x6f, 0x03, 0x3e,
  0xc2, 0xba, 0xbf, 0xbe, 0xbd, 0x90, 0x15, 0xbf, 0x73, 0x28, 0x8c, 0xbb,
  0xc6, 0x1a, 0x3c, 0x3e, 0x29, 0xfd, 0x03, 0xbe, 0x06, 0xc7, 0xc7, 0x3d,
  0x64, 0x68, 0xdd, 0xbe, 0x83, 0x0a, 0xeb, 0xbe, 0x77, 0xa2, 0xcc, 0x3d,
  0x54, 0x75, 0x34, 0x3f, 0x43, 0x8e, 0x25, 0x3e, 0x26, 0xc6, 0x00, 0x3e,
  0x92, 0xde, 0xc7, 0x3e, 0xb1, 0x45, 0xa6, 0xbe, 0x06, 0xaf, 0xa3, 0x3e,
  0x17, 0x7d, 0x76, 0x3e, 0xc4, 0x63, 0xd6, 0x3e, 0x13, 0xc7, 0x56, 0x3e,
  0xd9, 0xb2, 0x64, 0xbe, 0x70, 0xf9, 0x66, 0x3e, 0x69, 0x0d, 0xcf, 0xbe,
  0xdd, 0xac, 0x71, 0x3e, 0xb3, 0xbb, 0xbf, 0xbd, 0x54, 0x1a, 0x93, 0xbe,
  0x09, 0xff, 0x8c, 0x3d, 0x7d, 0xdb, 0xc2, 0xbe, 0x4f, 0x96, 0x96, 0xbe,
  0xb9, 0xa5, 0x1b, 0x3d, 0xc5, 0x34, 0xf7, 0xbc, 0x34, 0xb9, 0x1d, 0xbf,
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
};

#endif //SOME_MODEL_H
