bialykostek/kontroler/Kontroler/WTF/some_model.h

#define TENSORFLOW_LITE_EXPERIMENTAL_MICRO_EXAMPLES_HELLO_WORLD_SINE_MODEL_DATA_H_

#ifdef __has_attribute
#define HAVE_ATTRIBUTE(x) __has_attribute(x)
#else
#define HAVE_ATTRIBUTE(x) 0
#endif
#if HAVE_ATTRIBUTE(aligned) || (defined(__GNUC__) && !defined(__clang__))
#define DATA_ALIGN_ATTRIBUTE __attribute__((aligned(4)))
#else
#define DATA_ALIGN_ATTRIBUTE
#endif

const int g_sine_model_data_len = 5272;
const unsigned char g_sine_model_data[] DATA_ALIGN_ATTRIBUTE = {
 0x1c, 0x00, 0x00, 0x00, 0x54, 0x46, 0x4c, 0x33, 0x00, 0x00, 0x12, 0x00,
  0x1c, 0x00, 0x04, 0x00, 0x08, 0x00, 0x0c, 0x00, 0x10, 0x00, 0x14, 0x00,
  0x00, 0x00, 0x18, 0x00, 0x12, 0x00, 0x00, 0x00, 0x03, 0x00, 0x00, 0x00,
  0x44, 0x14, 0x00, 0x00, 0x44, 0x0f, 0x00, 0x00, 0x2c, 0x0f, 0x00, 0x00,
  0x34, 0x00, 0x00, 0x00, 0x04, 0x00, 0x00, 0x00, 0x01, 0x00, 0x00, 0x00,
  0x04, 0x00, 0x00, 0x00, 0x60, 0xec, 0xff, 0xff, 0x08, 0x00, 0x00, 0x00,
  0x0d, 0x00, 0x00, 0x00, 0x13, 0x00, 0x00, 0x00, 0x6d, 0x69, 0x6e, 0x5f,
  0x72, 0x75, 0x6e, 0x74, 0x69, 0x6d, 0x65, 0x5f, 0x76, 0x65, 0x72, 0x73,
  0x69, 0x6f, 0x6e, 0x00, 0x0e, 0x00, 0x00, 0x00, 0xec, 0x0e, 0x00, 0x00,
  0xe4, 0x0e, 0x00, 0x00, 0xac, 0x09, 0x00, 0x00, 0x9c, 0x09, 0x00, 0x00,
  0x90, 0x09, 0x00, 0x00, 0x88, 0x09, 0x00, 0x00, 0x80, 0x09, 0x00, 0x00,
  0x78, 0x09, 0x00, 0x00, 0x30, 0x02, 0x00, 0x00, 0xc8, 0x01, 0x00, 0x00,
  0x7c, 0x01, 0x00, 0x00, 0x40, 0x00, 0x00, 0x00, 0x1c, 0x00, 0x00, 0x00,
  0x04, 0x00, 0x00, 0x00, 0x8a, 0xf6, 0xff, 0xff, 0x04, 0x00, 0x00, 0x00,
  0x06, 0x00, 0x00, 0x00, 0x31, 0x2e, 0x31, 0x34, 0x2e, 0x30, 0x00, 0x00,
  0x9e, 0xf6, 0xff, 0xff, 0x04, 0x00, 0x00, 0x00, 0x14, 0x00, 0x00, 0x00,
  0xec, 0xa5, 0x06, 0xbd, 0x9d, 0x51, 0x2c, 0x3c, 0xbc, 0x6c, 0x6f, 0x3e,
  0x14, 0x3d, 0x48, 0x3b, 0x33, 0x15, 0x71, 0xbd, 0xbe, 0xf6, 0xff, 0xff,
  0x04, 0x00, 0x00, 0x00, 0x2c, 0x01, 0x00, 0x00, 0xb8, 0x9b, 0x06, 0x3e,
  0x02, 0x72, 0xe3, 0x3e, 0xc9, 0x52, 0xd5, 0xbe, 0x0c, 0x96, 0x89, 0x3d,
  0xa1, 0x83, 0x61, 0x3e, 0x48, 0x53, 0xcb, 0xbe, 0x70, 0x43, 0xf9, 0xbe,
  0xba, 0x88, 0x83, 0x3e, 0x7c, 0x22, 0x93, 0x3e, 0xdb, 0x95, 0xbe, 0xbe,
  0x07, 0x94, 0x0b, 0xbf, 0xdf, 0x8a, 0xab, 0x3e, 0x82, 0xc3, 0xb8, 0x3e,
  0xe7, 0x27, 0x9e, 0x3d, 0xdd, 0xef, 0x5b, 0x3e, 0x3c, 0x95, 0x09, 0xbe,
  0x2c, 0x27, 0xb0, 0x3e, 0x62, 0xac, 0xa0, 0xbd, 0xaa, 0x03, 0xba, 0x3d,
  0x8a, 0x13, 0xb3, 0x3e, 0x53, 0x8e, 0x74, 0x3e, 0xdc, 0x05, 0x0d, 0x3f,
  0x2e, 0x2b, 0xbe, 0x3e, 0xa5, 0xef, 0xa6, 0x3e, 0x98, 0x91, 0x53, 0x3e,
  0x84, 0xe9, 0x38, 0x3e, 0xbb, 0x92, 0xa5, 0xbe, 0x92, 0x0f, 0xa5, 0x3e,
  0x22, 0xf6, 0xad, 0x3e, 0x75, 0x44, 0x02, 0xbf, 0x26, 0xd0, 0x44, 0x3e,
  0x1f, 0x0c, 0x20, 0x3d, 0x30, 0x48, 0x99, 0x3d, 0x13, 0x2b, 0xa9, 0xbe,
  0xe4, 0xab, 0x6a, 0xbe, 0x7f, 0x21, 0x1b, 0xbd, 0x39, 0x0e, 0x5b, 0xbe,
  0xea, 0x48, 0x2f, 0x3f, 0x59, 0x01, 0x18, 0xbe, 0x76, 0x08, 0x3e, 0xbe,
  0x4f, 0x03, 0x93, 0xbe, 0x66, 0x4a, 0x29, 0x3d, 0x9b, 0x5a, 0x26, 0xbe,
  0x86, 0xf2, 0x98, 0x3d, 0xc1, 0x2a, 0x55, 0x3e, 0xa4, 0x0b, 0xb9, 0x3e,
  0xef, 0xf7, 0xcb, 0xbd, 0xde, 0x51, 0x85, 0xbe, 0x84, 0x3b, 0x10, 0xbe,
  0x4b, 0x9b, 0xd4, 0xbe, 0xbb, 0x4c, 0xdd, 0x3d, 0xbf, 0x44, 0x89, 0xbe,
  0xf3, 0xa5, 0x6a, 0xbd, 0xa1, 0xb7, 0x68, 0xbe, 0x32, 0x3d, 0x6d, 0x3e,
  0x61, 0x4c, 0x4b, 0xbe, 0xe8, 0x59, 0xa7, 0x3e, 0xe5, 0xd6, 0x5d, 0xbe,
  0xa0, 0xb8, 0xd6, 0x3e, 0x8f, 0xc6, 0x9e, 0xbe, 0xc8, 0x6c, 0x6d, 0x3e,
  0xd7, 0x23, 0x81, 0xbe, 0xd5, 0xd7, 0x6b, 0xbd, 0xc6, 0xf6, 0xbb, 0x3e,
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
};
