bialykostek/kontroler/Kontroler/babyDodoTFPPM/some_model.h

#define TENSORFLOW_LITE_EXPERIMENTAL_MICRO_EXAMPLES_HELLO_WORLD_SINE_MODEL_DATA_H_

#ifdef __has_attribute
#define HAVE_ATTRIBUTE(x) __has_attribute(x)
#else
#define HAVE_ATTRIBUTE(x) 0
#endif
#if HAVE_ATTRIBUTE(aligned) || (defined(__GNUC__) && !defined(__clang__))
#define DATA_ALIGN_ATTRIBUTE __attribute__((aligned(4)))
#else
#define DATA_ALIGN_ATTRIBUTE
#endif

const int g_sine_model_data_len = 6532;
const unsigned char g_sine_model_data[] DATA_ALIGN_ATTRIBUTE = {
  0x1c, 0x00, 0x00, 0x00, 0x54, 0x46, 0x4c, 0x33, 0x00, 0x00, 0x12, 0x00,
  0x1c, 0x00, 0x04, 0x00, 0x08, 0x00, 0x0c, 0x00, 0x10, 0x00, 0x14, 0x00,
  0x00, 0x00, 0x18, 0x00, 0x12, 0x00, 0x00, 0x00, 0x03, 0x00, 0x00, 0x00,
  0x30, 0x19, 0x00, 0x00, 0xa0, 0x12, 0x00, 0x00, 0x88, 0x12, 0x00, 0x00,
  0x34, 0x00, 0x00, 0x00, 0x04, 0x00, 0x00, 0x00, 0x01, 0x00, 0x00, 0x00,
  0x04, 0x00, 0x00, 0x00, 0x74, 0xe7, 0xff, 0xff, 0x08, 0x00, 0x00, 0x00,
  0x11, 0x00, 0x00, 0x00, 0x13, 0x00, 0x00, 0x00, 0x6d, 0x69, 0x6e, 0x5f,
  0x72, 0x75, 0x6e, 0x74, 0x69, 0x6d, 0x65, 0x5f, 0x76, 0x65, 0x72, 0x73,
  0x69, 0x6f, 0x6e, 0x00, 0x12, 0x00, 0x00, 0x00, 0x48, 0x12, 0x00, 0x00,
  0x40, 0x12, 0x00, 0x00, 0x44, 0x0d, 0x00, 0x00, 0x34, 0x0d, 0x00, 0x00,
  0x28, 0x0d, 0x00, 0x00, 0x20, 0x0d, 0x00, 0x00, 0x18, 0x0d, 0x00, 0x00,
  0x10, 0x0d, 0x00, 0x00, 0x08, 0x0d, 0x00, 0x00, 0x00, 0x0d, 0x00, 0x00,
  0x0c, 0x06, 0x00, 0x00, 0xa8, 0x05, 0x00, 0x00, 0x5c, 0x05, 0x00, 0x00,
  0xc8, 0x01, 0x00, 0x00, 0x7c, 0x01, 0x00, 0x00, 0x40, 0x00, 0x00, 0x00,
  0x1c, 0x00, 0x00, 0x00, 0x04, 0x00, 0x00, 0x00, 0x02, 0xf3, 0xff, 0xff,
  0x04, 0x00, 0x00, 0x00, 0x06, 0x00, 0x00, 0x00, 0x31, 0x2e, 0x31, 0x34,
  0x2e, 0x30, 0x00, 0x00, 0x16, 0xf3, 0xff, 0xff, 0x04, 0x00, 0x00, 0x00,
  0x14, 0x00, 0x00, 0x00, 0x89, 0xb4, 0x53, 0xbd, 0x38, 0xd3, 0x63, 0x3d,
  0x97, 0xfc, 0x88, 0x3a, 0xf8, 0xbe, 0x6e, 0x3c, 0x63, 0x14, 0xc1, 0x3d,
  0x36, 0xf3, 0xff, 0xff, 0x04, 0x00, 0x00, 0x00, 0x2c, 0x01, 0x00, 0x00,
  0x0a, 0x87, 0x52, 0xbc, 0x8f, 0x2f, 0x8f, 0xbe, 0x16, 0x2d, 0x7b, 0x3e,
  0xcb, 0x10, 0xd3, 0xbe, 0x7a, 0xed, 0x3d, 0x3e, 0x3c, 0xbc, 0xce, 0x3d,
  0xb0, 0xaf, 0x20, 0xbd, 0xfd, 0x59, 0x9f, 0x3d, 0x11, 0x58, 0xb6, 0x3e,
  0xb2, 0xb8, 0xb7, 0x3e, 0x59, 0x91, 0x48, 0x3e, 0x98, 0xea, 0x69, 0x3e,
  0xa2, 0x65, 0x84, 0x3e, 0xc6, 0xf6, 0xc6, 0x3e, 0xec, 0xd8, 0x85, 0x3e,
  0x7c, 0x3a, 0xda, 0xbe, 0x07, 0x34, 0x6e, 0x3e, 0x24, 0x92, 0xfb, 0xbd,
  0x55, 0x5a, 0xf7, 0xbe, 0x3d, 0x7d, 0x9c, 0x3e, 0x0a, 0xfa, 0x17, 0x3f,
  0x37, 0xe6, 0x34, 0x3e, 0x2a, 0x0b, 0xc4, 0xbe, 0x31, 0xc9, 0x0a, 0xbf,
  0x84, 0xad, 0x13, 0x3f, 0xe0, 0x0c, 0xc8, 0x3e, 0x7e, 0x27, 0xcf, 0xbe,
  0xdc, 0xa6, 0xba, 0x3e, 0x4a, 0x59, 0x05, 0x3e, 0x26, 0x0f, 0xa4, 0xbd,
  0xdd, 0x7f, 0x05, 0x3f, 0xe2, 0x87, 0xc5, 0xbe, 0x36, 0xf5, 0xc9, 0x3e,
  0x39, 0xb9, 0x36, 0xbd, 0x48, 0x36, 0xf4, 0xbe, 0x72, 0x0e, 0xe1, 0x3e,
  0xd0, 0xb3, 0x49, 0x3e, 0xc8, 0x27, 0x94, 0xbe, 0xca, 0xd1, 0x3b, 0xbc,
  0x48, 0x14, 0xd3, 0x3d, 0x0b, 0x5b, 0x62, 0x3d, 0xd4, 0x91, 0x8c, 0x3e,
  0x66, 0x2c, 0xe3, 0x3e, 0xe9, 0x9b, 0x32, 0x3e, 0x1d, 0xbf, 0xb2, 0xbe,
  0x03, 0x18, 0xa4, 0xbe, 0xbc, 0x29, 0xf0, 0xbe, 0x9e, 0xfd, 0x3c, 0x3e,
  0x67, 0x30, 0x00, 0xbf, 0xdf, 0x9c, 0xa4, 0x3d, 0xa9, 0xc5, 0x0d, 0x3f,
  0x1e, 0x1a, 0x51, 0xbc, 0x5c, 0x71, 0x03, 0x3f, 0xb4, 0x97, 0xc4, 0x3e,
  0x27, 0x54, 0x03, 0x3f, 0x8f, 0xb7, 0x6a, 0x3e, 0xd4, 0x1e, 0xf8, 0xbe,
  0x1c, 0x99, 0xe7, 0x3e, 0xd6, 0x70, 0xe4, 0x3e, 0x73, 0x0c, 0x6d, 0xbe,
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
};
