bialykostek/kontroler/Kontroler/testAI/flight_model.h

#define TENSORFLOW_LITE_EXPERIMENTAL_MICRO_EXAMPLES_HELLO_WORLD_SINE_MODEL_DATA_H_
#ifdef __has_attribute
#define HAVE_ATTRIBUTE(x) __has_attribute(x)
#else
#define HAVE_ATTRIBUTE(x) 0
#endif
#if HAVE_ATTRIBUTE(aligned) || (defined(__GNUC__) && !defined(__clang__))
#define DATA_ALIGN_ATTRIBUTE __attribute__((aligned(4)))
#else
#define DATA_ALIGN_ATTRIBUTE
#endif

const int flight_model_len = 4584;
const unsigned char flight_model[] DATA_ALIGN_ATTRIBUTE = {
 0x1c, 0x00, 0x00, 0x00, 0x54, 0x46, 0x4c, 0x33, 0x00, 0x00, 0x12, 0x00,
  0x1c, 0x00, 0x04, 0x00, 0x08, 0x00, 0x0c, 0x00, 0x10, 0x00, 0x14, 0x00,
  0x00, 0x00, 0x18, 0x00, 0x12, 0x00, 0x00, 0x00, 0x03, 0x00, 0x00, 0x00,
  0x94, 0x11, 0x00, 0x00, 0x94, 0x0c, 0x00, 0x00, 0x7c, 0x0c, 0x00, 0x00,
  0x34, 0x00, 0x00, 0x00, 0x04, 0x00, 0x00, 0x00, 0x01, 0x00, 0x00, 0x00,
  0x04, 0x00, 0x00, 0x00, 0x10, 0xef, 0xff, 0xff, 0x08, 0x00, 0x00, 0x00,
  0x0d, 0x00, 0x00, 0x00, 0x13, 0x00, 0x00, 0x00, 0x6d, 0x69, 0x6e, 0x5f,
  0x72, 0x75, 0x6e, 0x74, 0x69, 0x6d, 0x65, 0x5f, 0x76, 0x65, 0x72, 0x73,
  0x69, 0x6f, 0x6e, 0x00, 0x0e, 0x00, 0x00, 0x00, 0x3c, 0x0c, 0x00, 0x00,
  0x34, 0x0c, 0x00, 0x00, 0xdc, 0x08, 0x00, 0x00, 0xcc, 0x08, 0x00, 0x00,
  0xc0, 0x08, 0x00, 0x00, 0xb8, 0x08, 0x00, 0x00, 0xb0, 0x08, 0x00, 0x00,
  0xa8, 0x08, 0x00, 0x00, 0xb4, 0x01, 0x00, 0x00, 0x50, 0x01, 0x00, 0x00,
  0x18, 0x01, 0x00, 0x00, 0x40, 0x00, 0x00, 0x00, 0x1c, 0x00, 0x00, 0x00,
  0x04, 0x00, 0x00, 0x00, 0x5a, 0xf7, 0xff, 0xff, 0x04, 0x00, 0x00, 0x00,
  0x06, 0x00, 0x00, 0x00, 0x31, 0x2e, 0x31, 0x34, 0x2e, 0x30, 0x00, 0x00,
  0x6e, 0xf7, 0xff, 0xff, 0x04, 0x00, 0x00, 0x00, 0x14, 0x00, 0x00, 0x00,
  0x4b, 0x69, 0xcc, 0x3e, 0x59, 0x04, 0xd0, 0x3e, 0x5d, 0x98, 0xa8, 0x3e,
  0x88, 0xd7, 0x03, 0x3f, 0x21, 0x92, 0xdf, 0x3e, 0x8e, 0xf7, 0xff, 0xff,
  0x04, 0x00, 0x00, 0x00, 0xc8, 0x00, 0x00, 0x00, 0x01, 0xdd, 0xf8, 0x3e,
  0x72, 0xd9, 0x7c, 0x3e, 0x1c, 0x94, 0x18, 0xbe, 0x69, 0x3c, 0x13, 0x3f,
  0xe7, 0x35, 0x9b, 0xbc, 0x37, 0x1b, 0x46, 0x3d, 0xdf, 0x50, 0xeb, 0xbc,
  0xde, 0x82, 0xf2, 0x3e, 0xe1, 0x77, 0x0f, 0x3f, 0x8d, 0x81, 0xe2, 0x3e,
  0xc3, 0xea, 0x7b, 0xbe, 0xa3, 0x2b, 0x31, 0xbd, 0x92, 0xac, 0x76, 0x3e,
  0x0b, 0x14, 0x82, 0x3e, 0x3f, 0xf2, 0x28, 0x3e, 0xf6, 0x85, 0x7d, 0x3e,
  0x8e, 0xb1, 0xb0, 0x3e, 0x3c, 0x97, 0xad, 0x3e, 0x40, 0x46, 0xa3, 0xbb,
  0xf9, 0x9c, 0x9f, 0xbe, 0x36, 0xc8, 0x81, 0xbe, 0x9a, 0x31, 0x9e, 0xbd,
  0xc8, 0x24, 0x2d, 0x3e, 0xfc, 0x97, 0x94, 0x3e, 0x9d, 0x50, 0x31, 0x3e,
  0x8f, 0xf0, 0x7b, 0x3e, 0x08, 0x6a, 0xaf, 0x3e, 0xe1, 0x6d, 0xad, 0x3e,
  0x08, 0x7e, 0x35, 0xbd, 0xd9, 0x69, 0x8d, 0xbe, 0x95, 0xca, 0x52, 0xbd,
  0x31, 0xaa, 0x81, 0xbd, 0x83, 0xcb, 0xd0, 0xbd, 0xd9, 0x01, 0x26, 0x3d,
  0xe7, 0xc8, 0xea, 0x3d, 0x5b, 0xda, 0xda, 0xbc, 0xe5, 0x97, 0xd5, 0xbd,
  0x2f, 0xa7, 0x44, 0x3d, 0x08, 0x78, 0x3a, 0xbd, 0x7d, 0x6c, 0x0c, 0x3b,
  0x4c, 0x90, 0x00, 0x3e, 0x97, 0x7e, 0x2a, 0xbf, 0x03, 0x74, 0xd0, 0x3e,
  0xec, 0x93, 0x86, 0x3e, 0xf9, 0x13, 0x85, 0xbe, 0x30, 0x4e, 0x8f, 0x3d,
  0x37, 0x14, 0xbd, 0xbc, 0x4b, 0xfc, 0x85, 0x3d, 0xf8, 0x75, 0xd8, 0x3e,
  0x65, 0xb5, 0x8c, 0x3b, 0x62, 0xf8, 0xff, 0xff, 0x04, 0x00, 0x00, 0x00,
  0x28, 0x00, 0x00, 0x00, 0x23, 0x8d, 0xa3, 0xbe, 0x6e, 0xee, 0xdf, 0xbe,
  0x03, 0xf2, 0x10, 0xbf, 0x9b, 0x94, 0x9c, 0xbe, 0x93, 0x41, 0x02, 0xbf,
  0x25, 0x7b, 0xdc, 0xbe, 0x76, 0x1a, 0xcf, 0xbe, 0xb6, 0x23, 0xbb, 0xbe,
  0xe1, 0xd3, 0xf6, 0xbe, 0x79, 0x08, 0x9d, 0xbe, 0x96, 0xf8, 0xff, 0xff,
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
 
};
