bialykostek/kontroler/(commit log)

2022-10-03 imu and gps
2022-10-03 all sensors
2022-10-09 fixed i2c
2022-12-01 well xd commit time
    [lewe_11_30_2022 11-24-17.csv, lewe_11_30_2022 11-24-38.csv, lewe_11_30_2022 11-25-01.csv, lewe_przetarte_11_30_2022_11-34-10.csv, lewe_przetarte_11_30_2022_11-34-30.csv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]
2022-12-28 Final veersion & server code
    [S1-PV-areas-1.csv]
